JPirman/FPGA_polarimeter/doc/Block Design.pdf

AD7983_driver_0

AD7983_driver_v1_0

fpga_clk_i adc_clk_i

reset_n_i

data_o[15:0] data_rd_ready_o

adc_sdo

adc_sclk_o
adc_cnv_o
trigg_i

Encoder

nres
clk A_i B_i

I_i

cnt_o[10:0] dir_o_0 A_o B_o

Input_debouncer_0

Input_debouncer_v1_0

clk
signal_in

signal_out
trigg_falling
trigg_rising

axi_bram_ctrl_0

AXI BRAM Controller

S_AXI
s_axi_aclk | BRAM_PORTA
s_axi_aresetn

axi_bram_ctrl_0_bram

Block Memory Generator

BRAM_PORTA
BRAM_PORTB
addrb[31:0]
clkb
dinb[31:0] doutb[31:0] enb web[3:0]

rsta_busy
rstb_busy

axi_gpio_0

AXI GPIO

S_AXI | GPIO
gpio_io_i[1:0] s_axi_aclk
s_axi_aresetn

axi_iic_0

AXI IIC

S_AXI | IIC
s_axi_aclk s_axi_aresetn | iic2intc_irpt gpo[0:0]

axi_smc

AXI SmartConnect

S00_AXI | M00_AXI M01_AXI M02_AXI M03_AXI M04_AXI

aclk aresetn

axi_uartlite_0

AXI Uartlite

S_AXI | UART
s_axi_aclk s_axi_aresetn | interrupt

clk_wiz_0

Clocking Wizard

resetn
clk_in1

clk_out1
clk_out2
locked

i2c

mdm_1

MicroBlaze Debug Module (MDM)

MBDEBUG_0 Debug_SYS_Rst

microblaze_0

MicroBlaze

INTERRUPT | DLMB
| ILMB M_AXI_DP

DEBUG
Clk Reset

microblaze_0_axi_intc

AXI Interrupt Controller

s_axi
interrupt s_axi_aclk
s_axi_aresetn
intr[1:0]

microblaze_0_local_memory

DLMB
ILMB
LMB_Clk SYS_Rst

microblaze_0_xlconcat

Concat

In0[0:0]
In1[0:0] | dout[1:0]

A_i_0

BTN0

B_i_0
I_i_0

LD2

LD3

LD4
LD5

SW0

adc_cnv_0

adc_sck_0

adc_sdo_0

mot_sby

reset sys_clock

rst_clk_wiz_0_100M

Processor System Reset

slowest_sync_clk ext_reset_in

aux_reset_in mb_debug_sys_rst dcm_locked

mb_reset bus_struct_reset[0:0] peripheral_reset[0:0]

interconnect_aresetn[0:0] peripheral_aresetn[0:0]

sampling_controller_0

sampling_controller_v1_0

fpga_clk_i
reset_n_i | data_ready_o
trigger_i | idle_o
| bram_addr[31:0] bram_clk bram_wrdata[31:0]
bram_rddata[31:0]

bram_en
bram_we[3:0]

adc_data_ready_i adc_data_1[15:0] adc_data_2[15:0] enc_cnt_i[10:0]

usb_uart

util_vector_logic_0

Utility Vector Logic

Op1[0:0] Op2[0:0] | Res[0:0]

xlconcat_0

Concat

In0[0:0]
In1[0:0] | dout[1:0]

xlconstant_0

Constant

dout[15:0]

adc_sck_0 - JA pin 4
adc_cnv_0 - JA pin 1 mot_sby - IO9

Output of the XOR gate on bot quadrature encoder outputs will change state for every encoder step. We'll use this to trigger the ADC

### adc_sdo_0 - JA pin 3 I_i_0 - JC pin 1 A_i_0 - JC pin 2 B_i_0 - JC pin 3

## We can use the debouncer to output a pulse when a button is pressed/released. This is then used

## as a start signal for the sampling controller. This way we can prevent

## the core from continously running when the button is held
