JPirman/FPGA_polarimeter/Encoder_sampling/Vivado/archive_project_summary.txt

***************************************************************************************
*                      PROJECT ARCHIVE SUMMARY REPORT
*
*                      (archive_project_summary.txt)
*
*  PLEASE READ THIS REPORT TO GET THE DETAILED INFORMATION ABOUT THE PROJECT DATA THAT
*  WAS ARCHIVED FOR THE CURRENT PROJECT
*
* The report is divided into following five sections:-
*
* Section (1) - PROJECT INFORMATION
*  This section provides the details of the current project that was archived
*
* Section (2) - INCLUDED/EXCLUDED RUNS
*  This section summarizes the list of design runs for which the results were included
*  or excluded from the archive
*
* Section (3) - ARCHIVED SOURCES
*  This section summarizes the list of files that were added to the archive
*
* Section (3.1) - INCLUDE FILES
*  This section summarizes the list of 'include' files that were added to the archive
*
* Section (3.1.1) - INCLUDE_DIRS SETTINGS
*  This section summarizes the 'verilog include directory' path settings, if any
*
* Section (3.2) - REMOTE SOURCES
*  This section summarizes the list of referenced 'remote' files that were 'imported'
*  into the archived project
*
* Section (3.3) - SOURCES SUMMARY
*  This section summarizes the list of all the files present in the archive
*
* Section (3.4) - REMOTE IP DEFINITIONS
*  This section summarizes the list of all the remote IP's present in the archive
*
* Section (4) - JOURNAL/LOG FILES
*  This section summarizes the list of journal/log files that were added to the archive
*
* Section (5) - CONFIGURATION SETTINGS/FILES
*  This section summarizes the configuration settings/files that were added to the archive
*
***************************************************************************************

Section (1) - PROJECT INFORMATION
---------------------------------
Name      = Encoder_sampler
Directory = /home/jure/Dokumenti/Xilinx/Polarimeter/Encoder_sampler

WARNING: Please verify the compiled library directory path for the following property in the
         current project. The path may point to an invalid location after opening this project.
         This could happen if the project was unarchived in a location where this path is not
         accessible. To resolve this issue, please set this property with the desired path
         before launching simulation:-

Property = compxlib.xsim_compiled_library_dir
Path     = 

Section (2) - Excluded Runs
---------------------------
The run results were excluded for the following runs in the archived project:-

<synth_1>
<Main_microblaze_0_3_synth_1>
<Main_microblaze_0_axi_intc_3_synth_1>
<Main_clk_wiz_0_2_synth_1>
<Main_dlmb_v10_4_synth_1>
<Main_ilmb_v10_4_synth_1>
<Main_ilmb_bram_if_cntlr_4_synth_1>
<Main_lmb_bram_4_synth_1>
<Main_mdm_1_4_synth_1>
<Main_rst_clk_wiz_0_100M_1_synth_1>
<Main_axi_uartlite_0_2_synth_1>
<Main_axi_iic_0_1_synth_1>
<Main_util_vector_logic_0_1_synth_1>
<Main_axi_bram_ctrl_0_bram_0_synth_1>
<Main_sampling_controller_0_0_synth_1>
<Main_AD7983_driver_0_0_synth_1>
<impl_1>
<Main_microblaze_0_3_impl_1>
<Main_microblaze_0_axi_intc_3_impl_1>
<Main_clk_wiz_0_2_impl_1>
<Main_dlmb_v10_4_impl_1>
<Main_ilmb_v10_4_impl_1>
<Main_ilmb_bram_if_cntlr_4_impl_1>
<Main_lmb_bram_4_impl_1>
<Main_mdm_1_4_impl_1>
<Main_rst_clk_wiz_0_100M_1_impl_1>
<Main_axi_uartlite_0_2_impl_1>
<Main_axi_iic_0_1_impl_1>
<Main_util_vector_logic_0_1_impl_1>
<Main_axi_bram_ctrl_0_bram_0_impl_1>
<Main_sampling_controller_0_0_impl_1>
<Main_AD7983_driver_0_0_impl_1>

Section (3) - ARCHIVED SOURCES
------------------------------
The following sub-sections describes the list of sources that were archived for the current project:-

Section (3.1) - INCLUDE FILES
-----------------------------
List of referenced 'RTL Include' files that were 'imported' into the archived project:-

None

Section (3.1.1) - INCLUDE_DIRS SETTINGS
---------------------------------------
List of the "INCLUDE_DIRS" fileset property settings that may or may not be applicable in the archived
project, since most the 'RTL Include' files referenced in the original project were 'imported' into the
archived project.

<sources_1> fileset RTL include directory paths (INCLUDE_DIRS):-
None

<sim_1> fileset RTL include directory paths (INCLUDE_DIRS):-
None

Section (3.2) - REMOTE SOURCES
------------------------------
List of referenced 'remote' design files that were 'imported' into the archived project:-

<Main_AD7983_driver_0_0>
None

<Main_axi_bram_ctrl_0_bram_0>
/tmp/.Xil_jure/Vivado-25980-Jure-Linux/PrjAr/_X_/Encoder_sampler.gen/sources_1/bd/Main/ipshared/25a8/simulation/blk_mem_gen_v8_4.v
/tmp/.Xil_jure/Vivado-25980-Jure-Linux/PrjAr/_X_/Encoder_sampler.gen/sources_1/bd/Main/ipshared/25a8/hdl/blk_mem_gen_v8_4_vhsyn_rfs.vhd

<Main_axi_iic_0_1>
/tmp/.Xil_jure/Vivado-25980-Jure-Linux/PrjAr/_X_/Encoder_sampler.gen/sources_1/bd/Main/ipshared/0513/hdl/lib_pkg_v1_0_rfs.vhd
/tmp/.Xil_jure/Vivado-25980-Jure-Linux/PrjAr/_X_/Encoder_sampler.gen/sources_1/bd/Main/ipshared/ef1e/hdl/lib_cdc_v1_0_rfs.vhd
/tmp/.Xil_jure/Vivado-25980-Jure-Linux/PrjAr/_X_/Encoder_sampler.gen/sources_1/bd/Main/ipshared/66ea/hdl/axi_lite_ipif_v3_0_vh_rfs.vhd
/tmp/.Xil_jure/Vivado-25980-Jure-Linux/PrjAr/_X_/Encoder_sampler.gen/sources_1/bd/Main/ipshared/a040/hdl/interrupt_control_v3_1_vh_rfs.vhd
/tmp/.Xil_jure/Vivado-25980-Jure-Linux/PrjAr/_X_/Encoder_sampler.gen/sources_1/bd/Main/ipshared/eddf/hdl/axi_iic_v2_1_vh_rfs.vhd

<Main_axi_uartlite_0_2>
/tmp/.Xil_jure/Vivado-25980-Jure-Linux/PrjAr/_X_/Encoder_sampler.gen/sources_1/bd/Main/ipshared/66ea/hdl/axi_lite_ipif_v3_0_vh_rfs.vhd
/tmp/.Xil_jure/Vivado-25980-Jure-Linux/PrjAr/_X_/Encoder_sampler.gen/sources_1/bd/Main/ipshared/0513/hdl/lib_pkg_v1_0_rfs.vhd
/tmp/.Xil_jure/Vivado-25980-Jure-Linux/PrjAr/_X_/Encoder_sampler.gen/sources_1/bd/Main/ipshared/51ce/hdl/lib_srl_fifo_v1_0_rfs.vhd
/tmp/.Xil_jure/Vivado-25980-Jure-Linux/PrjAr/_X_/Encoder_sampler.gen/sources_1/bd/Main/ipshared/ef1e/hdl/lib_cdc_v1_0_rfs.vhd
/tmp/.Xil_jure/Vivado-25980-Jure-Linux/PrjAr/_X_/Encoder_sampler.gen/sources_1/bd/Main/ipshared/5d2b/hdl/axi_uartlite_v2_0_vh_rfs.vhd

<Main_clk_wiz_0_2>
/tmp/.Xil_jure/Vivado-25980-Jure-Linux/PrjAr/_X_/Encoder_sampler.gen/sources_1/bd/Main/ipshared/4e49/mmcm_pll_drp_func_7s_mmcm.vh
/tmp/.Xil_jure/Vivado-25980-Jure-Linux/PrjAr/_X_/Encoder_sampler.gen/sources_1/bd/Main/ipshared/4e49/mmcm_pll_drp_func_7s_pll.vh
/tmp/.Xil_jure/Vivado-25980-Jure-Linux/PrjAr/_X_/Encoder_sampler.gen/sources_1/bd/Main/ipshared/4e49/mmcm_pll_drp_func_us_mmcm.vh
/tmp/.Xil_jure/Vivado-25980-Jure-Linux/PrjAr/_X_/Encoder_sampler.gen/sources_1/bd/Main/ipshared/4e49/mmcm_pll_drp_func_us_pll.vh
/tmp/.Xil_jure/Vivado-25980-Jure-Linux/PrjAr/_X_/Encoder_sampler.gen/sources_1/bd/Main/ipshared/4e49/mmcm_pll_drp_func_us_plus_pll.vh
/tmp/.Xil_jure/Vivado-25980-Jure-Linux/PrjAr/_X_/Encoder_sampler.gen/sources_1/bd/Main/ipshared/4e49/mmcm_pll_drp_func_us_plus_mmcm.vh

<Main_dlmb_v10_4>
/tmp/.Xil_jure/Vivado-25980-Jure-Linux/PrjAr/_X_/Encoder_sampler.gen/sources_1/bd/Main/ipshared/cd1d/hdl/lmb_v10_v3_0_vh_rfs.vhd

<Main_ilmb_bram_if_cntlr_4>
/tmp/.Xil_jure/Vivado-25980-Jure-Linux/PrjAr/_X_/Encoder_sampler.gen/sources_1/bd/Main/ipshared/a177/hdl/lmb_bram_if_cntlr_v4_0_vh_rfs.vhd

<Main_ilmb_v10_4>
/tmp/.Xil_jure/Vivado-25980-Jure-Linux/PrjAr/_X_/Encoder_sampler.gen/sources_1/bd/Main/ipshared/cd1d/hdl/lmb_v10_v3_0_vh_rfs.vhd

<Main_lmb_bram_4>
/tmp/.Xil_jure/Vivado-25980-Jure-Linux/PrjAr/_X_/Encoder_sampler.gen/sources_1/bd/Main/ipshared/25a8/simulation/blk_mem_gen_v8_4.v
/tmp/.Xil_jure/Vivado-25980-Jure-Linux/PrjAr/_X_/Encoder_sampler.gen/sources_1/bd/Main/ipshared/25a8/hdl/blk_mem_gen_v8_4_vhsyn_rfs.vhd

<Main_mdm_1_4>
/tmp/.Xil_jure/Vivado-25980-Jure-Linux/PrjAr/_X_/Encoder_sampler.gen/sources_1/bd/Main/ipshared/66ea/hdl/axi_lite_ipif_v3_0_vh_rfs.vhd
/tmp/.Xil_jure/Vivado-25980-Jure-Linux/PrjAr/_X_/Encoder_sampler.gen/sources_1/bd/Main/ipshared/b8f4/hdl/mdm_v3_2_vh_rfs.vhd

<Main_microblaze_0_3>
/tmp/.Xil_jure/Vivado-25980-Jure-Linux/PrjAr/_X_/Encoder_sampler.gen/sources_1/bd/Main/ipshared/057e/hdl/microblaze_v11_0_vh_rfs.vhd

<Main_microblaze_0_axi_intc_3>
/tmp/.Xil_jure/Vivado-25980-Jure-Linux/PrjAr/_X_/Encoder_sampler.gen/sources_1/bd/Main/ipshared/66ea/hdl/axi_lite_ipif_v3_0_vh_rfs.vhd
/tmp/.Xil_jure/Vivado-25980-Jure-Linux/PrjAr/_X_/Encoder_sampler.gen/sources_1/bd/Main/ipshared/802b/hdl/axi_intc_v4_1_vh_rfs.vhd

<Main_rst_clk_wiz_0_100M_1>
/tmp/.Xil_jure/Vivado-25980-Jure-Linux/PrjAr/_X_/Encoder_sampler.gen/sources_1/bd/Main/ipshared/ef1e/hdl/lib_cdc_v1_0_rfs.vhd
/tmp/.Xil_jure/Vivado-25980-Jure-Linux/PrjAr/_X_/Encoder_sampler.gen/sources_1/bd/Main/ipshared/8842/hdl/proc_sys_reset_v5_0_vh_rfs.vhd

<Main_sampling_controller_0_0>
None

<Main_util_vector_logic_0_1>
/tmp/.Xil_jure/Vivado-25980-Jure-Linux/PrjAr/_X_/Encoder_sampler.gen/sources_1/bd/Main/ipshared/3d84/hdl/util_vector_logic_v2_0_vl_rfs.v

<constrs_1>
None

<sim_1>
None

<sources_1>
/tmp/.Xil_jure/Vivado-25980-Jure-Linux/PrjAr/_X_/Encoder_sampler.gen/sources_1/bd/Main/ipshared/057e/hdl/microblaze_v11_0_vh_rfs.vhd
/tmp/.Xil_jure/Vivado-25980-Jure-Linux/PrjAr/_X_/Encoder_sampler.gen/sources_1/bd/Main/ipshared/4e49/mmcm_pll_drp_func_7s_mmcm.vh
/tmp/.Xil_jure/Vivado-25980-Jure-Linux/PrjAr/_X_/Encoder_sampler.gen/sources_1/bd/Main/ipshared/4e49/mmcm_pll_drp_func_7s_pll.vh
/tmp/.Xil_jure/Vivado-25980-Jure-Linux/PrjAr/_X_/Encoder_sampler.gen/sources_1/bd/Main/ipshared/4e49/mmcm_pll_drp_func_us_mmcm.vh
/tmp/.Xil_jure/Vivado-25980-Jure-Linux/PrjAr/_X_/Encoder_sampler.gen/sources_1/bd/Main/ipshared/4e49/mmcm_pll_drp_func_us_pll.vh
/tmp/.Xil_jure/Vivado-25980-Jure-Linux/PrjAr/_X_/Encoder_sampler.gen/sources_1/bd/Main/ipshared/4e49/mmcm_pll_drp_func_us_plus_pll.vh
/tmp/.Xil_jure/Vivado-25980-Jure-Linux/PrjAr/_X_/Encoder_sampler.gen/sources_1/bd/Main/ipshared/4e49/mmcm_pll_drp_func_us_plus_mmcm.vh
/tmp/.Xil_jure/Vivado-25980-Jure-Linux/PrjAr/_X_/Encoder_sampler.gen/sources_1/bd/Main/ipshared/cd1d/hdl/lmb_v10_v3_0_vh_rfs.vhd
/tmp/.Xil_jure/Vivado-25980-Jure-Linux/PrjAr/_X_/Encoder_sampler.gen/sources_1/bd/Main/ipshared/cd1d/hdl/lmb_v10_v3_0_vh_rfs.vhd
/tmp/.Xil_jure/Vivado-25980-Jure-Linux/PrjAr/_X_/Encoder_sampler.gen/sources_1/bd/Main/ipshared/a177/hdl/lmb_bram_if_cntlr_v4_0_vh_rfs.vhd
/tmp/.Xil_jure/Vivado-25980-Jure-Linux/PrjAr/_X_/Encoder_sampler.gen/sources_1/bd/Main/ipshared/a177/hdl/lmb_bram_if_cntlr_v4_0_vh_rfs.vhd
/tmp/.Xil_jure/Vivado-25980-Jure-Linux/PrjAr/_X_/Encoder_sampler.gen/sources_1/bd/Main/ipshared/25a8/simulation/blk_mem_gen_v8_4.v
/tmp/.Xil_jure/Vivado-25980-Jure-Linux/PrjAr/_X_/Encoder_sampler.gen/sources_1/bd/Main/ipshared/25a8/hdl/blk_mem_gen_v8_4_vhsyn_rfs.vhd
/tmp/.Xil_jure/Vivado-25980-Jure-Linux/PrjAr/_X_/Encoder_sampler.gen/sources_1/bd/Main/ipshared/66ea/hdl/axi_lite_ipif_v3_0_vh_rfs.vhd
/tmp/.Xil_jure/Vivado-25980-Jure-Linux/PrjAr/_X_/Encoder_sampler.gen/sources_1/bd/Main/ipshared/802b/hdl/axi_intc_v4_1_vh_rfs.vhd
/tmp/.Xil_jure/Vivado-25980-Jure-Linux/PrjAr/_X_/Encoder_sampler.gen/sources_1/bd/Main/ipshared/4b67/hdl/xlconcat_v2_1_vl_rfs.v
/tmp/.Xil_jure/Vivado-25980-Jure-Linux/PrjAr/_X_/Encoder_sampler.gen/sources_1/bd/Main/ipshared/66ea/hdl/axi_lite_ipif_v3_0_vh_rfs.vhd
/tmp/.Xil_jure/Vivado-25980-Jure-Linux/PrjAr/_X_/Encoder_sampler.gen/sources_1/bd/Main/ipshared/b8f4/hdl/mdm_v3_2_vh_rfs.vhd
/tmp/.Xil_jure/Vivado-25980-Jure-Linux/PrjAr/_X_/Encoder_sampler.gen/sources_1/bd/Main/ipshared/ef1e/hdl/lib_cdc_v1_0_rfs.vhd
/tmp/.Xil_jure/Vivado-25980-Jure-Linux/PrjAr/_X_/Encoder_sampler.gen/sources_1/bd/Main/ipshared/8842/hdl/proc_sys_reset_v5_0_vh_rfs.vhd
/tmp/.Xil_jure/Vivado-25980-Jure-Linux/PrjAr/_X_/Encoder_sampler.gen/sources_1/bd/Main/ipshared/66ea/hdl/axi_lite_ipif_v3_0_vh_rfs.vhd
/tmp/.Xil_jure/Vivado-25980-Jure-Linux/PrjAr/_X_/Encoder_sampler.gen/sources_1/bd/Main/ipshared/0513/hdl/lib_pkg_v1_0_rfs.vhd
/tmp/.Xil_jure/Vivado-25980-Jure-Linux/PrjAr/_X_/Encoder_sampler.gen/sources_1/bd/Main/ipshared/51ce/hdl/lib_srl_fifo_v1_0_rfs.vhd
/tmp/.Xil_jure/Vivado-25980-Jure-Linux/PrjAr/_X_/Encoder_sampler.gen/sources_1/bd/Main/ipshared/ef1e/hdl/lib_cdc_v1_0_rfs.vhd
/tmp/.Xil_jure/Vivado-25980-Jure-Linux/PrjAr/_X_/Encoder_sampler.gen/sources_1/bd/Main/ipshared/5d2b/hdl/axi_uartlite_v2_0_vh_rfs.vhd
/tmp/.Xil_jure/Vivado-25980-Jure-Linux/PrjAr/_X_/Encoder_sampler.gen/sources_1/bd/Main/ipshared/0513/hdl/lib_pkg_v1_0_rfs.vhd
/tmp/.Xil_jure/Vivado-25980-Jure-Linux/PrjAr/_X_/Encoder_sampler.gen/sources_1/bd/Main/ipshared/ef1e/hdl/lib_cdc_v1_0_rfs.vhd
/tmp/.Xil_jure/Vivado-25980-Jure-Linux/PrjAr/_X_/Encoder_sampler.gen/sources_1/bd/Main/ipshared/66ea/hdl/axi_lite_ipif_v3_0_vh_rfs.vhd
/tmp/.Xil_jure/Vivado-25980-Jure-Linux/PrjAr/_X_/Encoder_sampler.gen/sources_1/bd/Main/ipshared/a040/hdl/interrupt_control_v3_1_vh_rfs.vhd
/tmp/.Xil_jure/Vivado-25980-Jure-Linux/PrjAr/_X_/Encoder_sampler.gen/sources_1/bd/Main/ipshared/eddf/hdl/axi_iic_v2_1_vh_rfs.vhd
/tmp/.Xil_jure/Vivado-25980-Jure-Linux/PrjAr/_X_/Encoder_sampler.gen/sources_1/bd/Main/ipshared/3d84/hdl/util_vector_logic_v2_0_vl_rfs.v
/tmp/.Xil_jure/Vivado-25980-Jure-Linux/PrjAr/_X_/Encoder_sampler.gen/sources_1/bd/Main/ipshared/66ea/hdl/axi_lite_ipif_v3_0_vh_rfs.vhd
/tmp/.Xil_jure/Vivado-25980-Jure-Linux/PrjAr/_X_/Encoder_sampler.gen/sources_1/bd/Main/ipshared/ef1e/hdl/lib_cdc_v1_0_rfs.vhd
/tmp/.Xil_jure/Vivado-25980-Jure-Linux/PrjAr/_X_/Encoder_sampler.gen/sources_1/bd/Main/ipshared/a040/hdl/interrupt_control_v3_1_vh_rfs.vhd
/tmp/.Xil_jure/Vivado-25980-Jure-Linux/PrjAr/_X_/Encoder_sampler.gen/sources_1/bd/Main/ipshared/3ed9/hdl/axi_gpio_v2_0_vh_rfs.vhd
/tmp/.Xil_jure/Vivado-25980-Jure-Linux/PrjAr/_X_/Encoder_sampler.gen/sources_1/bd/Main/ipshared/4b67/hdl/xlconcat_v2_1_vl_rfs.v
/tmp/.Xil_jure/Vivado-25980-Jure-Linux/PrjAr/_X_/Encoder_sampler.gen/sources_1/bd/Main/ipshared/fcfc/hdl/xlconstant_v1_1_vl_rfs.v
/tmp/.Xil_jure/Vivado-25980-Jure-Linux/PrjAr/_X_/Encoder_sampler.gen/sources_1/bd/Main/ipshared/3c31/hdl/axi_bram_ctrl_v4_1_rfs.vhd
/tmp/.Xil_jure/Vivado-25980-Jure-Linux/PrjAr/_X_/Encoder_sampler.gen/sources_1/bd/Main/ipshared/25a8/simulation/blk_mem_gen_v8_4.v
/tmp/.Xil_jure/Vivado-25980-Jure-Linux/PrjAr/_X_/Encoder_sampler.gen/sources_1/bd/Main/ipshared/25a8/hdl/blk_mem_gen_v8_4_vhsyn_rfs.vhd
/tmp/.Xil_jure/Vivado-25980-Jure-Linux/PrjAr/_X_/Encoder_sampler.gen/sources_1/bd/Main/ipshared/fcfc/hdl/xlconstant_v1_1_vl_rfs.v
/tmp/.Xil_jure/Vivado-25980-Jure-Linux/PrjAr/_X_/Encoder_sampler.gen/sources_1/bd/Main/ipshared/ef1e/hdl/lib_cdc_v1_0_rfs.vhd
/tmp/.Xil_jure/Vivado-25980-Jure-Linux/PrjAr/_X_/Encoder_sampler.gen/sources_1/bd/Main/ipshared/8842/hdl/proc_sys_reset_v5_0_vh_rfs.vhd
/tmp/.Xil_jure/Vivado-25980-Jure-Linux/PrjAr/_X_/Encoder_sampler.gen/sources_1/bd/Main/ipshared/f0b6/hdl/verilog/sc_util_v1_0_4_constants.vh
/tmp/.Xil_jure/Vivado-25980-Jure-Linux/PrjAr/_X_/Encoder_sampler.gen/sources_1/bd/Main/ipshared/f0b6/hdl/verilog/sc_util_v1_0_4_constants_noc.vh
/tmp/.Xil_jure/Vivado-25980-Jure-Linux/PrjAr/_X_/Encoder_sampler.gen/sources_1/bd/Main/ipshared/f0b6/hdl/verilog/sc_util_v1_0_4_structs.svh
/tmp/.Xil_jure/Vivado-25980-Jure-Linux/PrjAr/_X_/Encoder_sampler.gen/sources_1/bd/Main/ipshared/f0b6/hdl/sc_util_v1_0_vl_rfs.sv
/tmp/.Xil_jure/Vivado-25980-Jure-Linux/PrjAr/_X_/Encoder_sampler.gen/sources_1/bd/Main/ipshared/c012/hdl/sc_switchboard_v1_0_vl_rfs.sv
/tmp/.Xil_jure/Vivado-25980-Jure-Linux/PrjAr/_X_/Encoder_sampler.gen/sources_1/bd/Main/ipshared/f0b6/hdl/verilog/sc_util_v1_0_4_constants.vh
/tmp/.Xil_jure/Vivado-25980-Jure-Linux/PrjAr/_X_/Encoder_sampler.gen/sources_1/bd/Main/ipshared/f0b6/hdl/verilog/sc_util_v1_0_4_constants_noc.vh
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
/tmp/.Xil_jure/Vivado-25980-Jure-Linux/PrjAr/_X_/Encoder_sampler.gen/sources_1/bd/Main/ipshared/f0b6/hdl/verilog/sc_util_v1_0_4_constants_noc.vh
/tmp/.Xil_jure/Vivado-25980-Jure-Linux/PrjAr/_X_/Encoder_sampler.gen/sources_1/bd/Main/ipshared/f0b6/hdl/verilog/sc_util_v1_0_4_structs.svh
/tmp/.Xil_jure/Vivado-25980-Jure-Linux/PrjAr/_X_/Encoder_sampler.gen/sources_1/bd/Main/ipshared/f0b6/hdl/sc_util_v1_0_vl_rfs.sv
/tmp/.Xil_jure/Vivado-25980-Jure-Linux/PrjAr/_X_/Encoder_sampler.gen/sources_1/bd/Main/ipshared/ea34/hdl/sc_mmu_v1_0_vl_rfs.sv
/tmp/.Xil_jure/Vivado-25980-Jure-Linux/PrjAr/_X_/Encoder_sampler.gen/sources_1/bd/Main/ipshared/4fd2/hdl/sc_transaction_regulator_v1_0_vl_rfs.sv
/tmp/.Xil_jure/Vivado-25980-Jure-Linux/PrjAr/_X_/Encoder_sampler.gen/sources_1/bd/Main/ipshared/8047/hdl/sc_si_converter_v1_0_vl_rfs.sv
/tmp/.Xil_jure/Vivado-25980-Jure-Linux/PrjAr/_X_/Encoder_sampler.gen/sources_1/bd/Main/ipshared/66be/hdl/verilog/sc_node_v1_0_14_t_reqsend.svh
/tmp/.Xil_jure/Vivado-25980-Jure-Linux/PrjAr/_X_/Encoder_sampler.gen/sources_1/bd/Main/ipshared/66be/hdl/sc_node_v1_0_vl_rfs.sv
/tmp/.Xil_jure/Vivado-25980-Jure-Linux/PrjAr/_X_/Encoder_sampler.gen/sources_1/bd/Main/ipshared/c012/hdl/sc_switchboard_v1_0_vl_rfs.sv
/tmp/.Xil_jure/Vivado-25980-Jure-Linux/PrjAr/_X_/Encoder_sampler.gen/sources_1/bd/Main/ipshared/f38e/hdl/sc_axi2sc_v1_0_vl_rfs.sv
/tmp/.Xil_jure/Vivado-25980-Jure-Linux/PrjAr/_X_/Encoder_sampler.gen/sources_1/bd/Main/ipshared/9cc5/hdl/sc_sc2axi_v1_0_vl_rfs.sv
/tmp/.Xil_jure/Vivado-25980-Jure-Linux/PrjAr/_X_/Encoder_sampler.gen/sources_1/bd/Main/ipshared/6bba/hdl/sc_exit_v1_0_vl_rfs.sv
/tmp/.Xil_jure/Vivado-25980-Jure-Linux/PrjAr/_X_/Encoder_sampler.gen/sources_1/bd/Main/ipshared/ec67/hdl/axi_infrastructure_v1_1_0.vh
/tmp/.Xil_jure/Vivado-25980-Jure-Linux/PrjAr/_X_/Encoder_sampler.gen/sources_1/bd/Main/ipshared/ec67/hdl/axi_infrastructure_v1_1_vl_rfs.v
/tmp/.Xil_jure/Vivado-25980-Jure-Linux/PrjAr/_X_/Encoder_sampler.gen/sources_1/bd/Main/ipshared/0a3f/hdl/axi_register_slice_v2_1_vl_rfs.v
/tmp/.Xil_jure/Vivado-25980-Jure-Linux/PrjAr/_X_/Encoder_sampler.gen/sources_1/bd/Main/ipshared/1033/hdl/axi_vip_v1_1_vl_rfs.sv
/tmp/.Xil_jure/Vivado-25980-Jure-Linux/PrjAr/_X_/Encoder_sampler.gen/sources_1/bd/Main/ipshared/ef1e/hdl/lib_cdc_v1_0_rfs.vhd
/tmp/.Xil_jure/Vivado-25980-Jure-Linux/PrjAr/_X_/Encoder_sampler.gen/sources_1/bd/Main/ipshared/8842/hdl/proc_sys_reset_v5_0_vh_rfs.vhd
/tmp/.Xil_jure/Vivado-25980-Jure-Linux/PrjAr/_X_/Encoder_sampler.gen/sources_1/bd/Main/ipshared/fcfc/hdl/xlconstant_v1_1_vl_rfs.v

<utils_1>
None

Section (3.3) - SOURCES SUMMARY
-------------------------------
List of all the source files present in the archived project:-

<sources_1>
./Encoder_sampler.srcs/sources_1/new/Input_debouncer.v
./Encoder_sampler.srcs/sources_1/new/Encoder_decoder.v
./Encoder_sampler.srcs/sources_1/new/AD7983_driver.v
./Encoder_sampler.srcs/sources_1/new/sampling_controller.v
./Encoder_sampler.srcs/sources_1/bd/Main/Main.bd
./Encoder_sampler.srcs/sources_1/bd/Main/ip/Main_microblaze_0_3/Main_microblaze_0_3.xci
./Encoder_sampler.gen/sources_1/bd/Main/ip/Main_microblaze_0_3/data/mb_bootloop_le.elf
./Encoder_sampler.gen/sources_1/bd/Main/ip/Main_microblaze_0_3/Main_microblaze_0_3.xdc
./Encoder_sampler.gen/sources_1/bd/Main/ip/Main_microblaze_0_3/Main_microblaze_0_3_ooc_debug.xdc
./Encoder_sampler.gen/sources_1/bd/Main/ipshared/057e/hdl/microblaze_v11_0_vh_rfs.vhd
./Encoder_sampler.gen/sources_1/bd/Main/ip/Main_microblaze_0_3/sim/Main_microblaze_0_3.vhd
./Encoder_sampler.gen/sources_1/bd/Main/ip/Main_microblaze_0_3/Main_microblaze_0_3.dcp
./Encoder_sampler.gen/sources_1/bd/Main/ip/Main_microblaze_0_3/Main_microblaze_0_3_stub.v
./Encoder_sampler.gen/sources_1/bd/Main/ip/Main_microblaze_0_3/Main_microblaze_0_3_stub.vhdl
./Encoder_sampler.gen/sources_1/bd/Main/ip/Main_microblaze_0_3/Main_microblaze_0_3_sim_netlist.v
./Encoder_sampler.gen/sources_1/bd/Main/ip/Main_microblaze_0_3/Main_microblaze_0_3_sim_netlist.vhdl
./Encoder_sampler.gen/sources_1/bd/Main/ip/Main_microblaze_0_3/synth/Main_microblaze_0_3.vhd
./Encoder_sampler.gen/sources_1/bd/Main/ip/Main_microblaze_0_3/Main_microblaze_0_3_ooc.xdc
./Encoder_sampler.gen/sources_1/bd/Main/ip/Main_microblaze_0_3/Main_microblaze_0_3.xml
./Encoder_sampler.srcs/sources_1/bd/Main/ip/Main_clk_wiz_0_2/Main_clk_wiz_0_2.xci
./Encoder_sampler.gen/sources_1/bd/Main/ip/Main_clk_wiz_0_2/Main_clk_wiz_0_2_board.xdc
./Encoder_sampler.gen/sources_1/bd/Main/ip/Main_clk_wiz_0_2/Main_clk_wiz_0_2.xdc
./Encoder_sampler.gen/sources_1/bd/Main/ip/Main_clk_wiz_0_2/Main_clk_wiz_0_2_ooc.xdc
./Encoder_sampler.gen/sources_1/bd/Main/ipshared/4e49/mmcm_pll_drp_func_7s_mmcm.vh
./Encoder_sampler.gen/sources_1/bd/Main/ipshared/4e49/mmcm_pll_drp_func_7s_pll.vh
./Encoder_sampler.gen/sources_1/bd/Main/ipshared/4e49/mmcm_pll_drp_func_us_mmcm.vh
./Encoder_sampler.gen/sources_1/bd/Main/ipshared/4e49/mmcm_pll_drp_func_us_pll.vh
./Encoder_sampler.gen/sources_1/bd/Main/ipshared/4e49/mmcm_pll_drp_func_us_plus_pll.vh
./Encoder_sampler.gen/sources_1/bd/Main/ipshared/4e49/mmcm_pll_drp_func_us_plus_mmcm.vh
./Encoder_sampler.gen/sources_1/bd/Main/ip/Main_clk_wiz_0_2/Main_clk_wiz_0_2_clk_wiz.v
./Encoder_sampler.gen/sources_1/bd/Main/ip/Main_clk_wiz_0_2/Main_clk_wiz_0_2.v
./Encoder_sampler.gen/sources_1/bd/Main/ip/Main_clk_wiz_0_2/Main_clk_wiz_0_2.dcp
./Encoder_sampler.gen/sources_1/bd/Main/ip/Main_clk_wiz_0_2/Main_clk_wiz_0_2_stub.v
./Encoder_sampler.gen/sources_1/bd/Main/ip/Main_clk_wiz_0_2/Main_clk_wiz_0_2_stub.vhdl
./Encoder_sampler.gen/sources_1/bd/Main/ip/Main_clk_wiz_0_2/Main_clk_wiz_0_2_sim_netlist.v
./Encoder_sampler.gen/sources_1/bd/Main/ip/Main_clk_wiz_0_2/Main_clk_wiz_0_2_sim_netlist.vhdl
./Encoder_sampler.gen/sources_1/bd/Main/ip/Main_clk_wiz_0_2/Main_clk_wiz_0_2.xml
./Encoder_sampler.srcs/sources_1/bd/Main/ip/Main_dlmb_v10_4/Main_dlmb_v10_4.xci
./Encoder_sampler.gen/sources_1/bd/Main/ipshared/cd1d/hdl/lmb_v10_v3_0_vh_rfs.vhd
./Encoder_sampler.gen/sources_1/bd/Main/ip/Main_dlmb_v10_4/sim/Main_dlmb_v10_4.vhd
./Encoder_sampler.gen/sources_1/bd/Main/ip/Main_dlmb_v10_4/Main_dlmb_v10_4.dcp
./Encoder_sampler.gen/sources_1/bd/Main/ip/Main_dlmb_v10_4/Main_dlmb_v10_4_stub.v
./Encoder_sampler.gen/sources_1/bd/Main/ip/Main_dlmb_v10_4/Main_dlmb_v10_4_stub.vhdl
./Encoder_sampler.gen/sources_1/bd/Main/ip/Main_dlmb_v10_4/Main_dlmb_v10_4_sim_netlist.v
./Encoder_sampler.gen/sources_1/bd/Main/ip/Main_dlmb_v10_4/Main_dlmb_v10_4_sim_netlist.vhdl
./Encoder_sampler.gen/sources_1/bd/Main/ip/Main_dlmb_v10_4/synth/Main_dlmb_v10_4.vhd
./Encoder_sampler.gen/sources_1/bd/Main/ip/Main_dlmb_v10_4/Main_dlmb_v10_4_ooc.xdc
./Encoder_sampler.gen/sources_1/bd/Main/ip/Main_dlmb_v10_4/Main_dlmb_v10_4.xml
./Encoder_sampler.srcs/sources_1/bd/Main/ip/Main_ilmb_v10_4/Main_ilmb_v10_4.xci
./Encoder_sampler.gen/sources_1/bd/Main/ipshared/cd1d/hdl/lmb_v10_v3_0_vh_rfs.vhd
./Encoder_sampler.gen/sources_1/bd/Main/ip/Main_ilmb_v10_4/sim/Main_ilmb_v10_4.vhd
./Encoder_sampler.gen/sources_1/bd/Main/ip/Main_ilmb_v10_4/Main_ilmb_v10_4.dcp
./Encoder_sampler.gen/sources_1/bd/Main/ip/Main_ilmb_v10_4/Main_ilmb_v10_4_stub.v
./Encoder_sampler.gen/sources_1/bd/Main/ip/Main_ilmb_v10_4/Main_ilmb_v10_4_stub.vhdl
./Encoder_sampler.gen/sources_1/bd/Main/ip/Main_ilmb_v10_4/Main_ilmb_v10_4_sim_netlist.v
./Encoder_sampler.gen/sources_1/bd/Main/ip/Main_ilmb_v10_4/Main_ilmb_v10_4_sim_netlist.vhdl
./Encoder_sampler.gen/sources_1/bd/Main/ip/Main_ilmb_v10_4/synth/Main_ilmb_v10_4.vhd
./Encoder_sampler.gen/sources_1/bd/Main/ip/Main_ilmb_v10_4/Main_ilmb_v10_4_ooc.xdc
./Encoder_sampler.gen/sources_1/bd/Main/ip/Main_ilmb_v10_4/Main_ilmb_v10_4.xml
./Encoder_sampler.srcs/sources_1/bd/Main/ip/Main_dlmb_bram_if_cntlr_4/Main_dlmb_bram_if_cntlr_4.xci
./Encoder_sampler.gen/sources_1/bd/Main/ipshared/a177/hdl/lmb_bram_if_cntlr_v4_0_vh_rfs.vhd
./Encoder_sampler.gen/sources_1/bd/Main/ip/Main_dlmb_bram_if_cntlr_4/sim/Main_dlmb_bram_if_cntlr_4.vhd
./Encoder_sampler.gen/sources_1/bd/Main/ip/Main_dlmb_bram_if_cntlr_4/Main_dlmb_bram_if_cntlr_4_stub.v
./Encoder_sampler.gen/sources_1/bd/Main/ip/Main_dlmb_bram_if_cntlr_4/Main_dlmb_bram_if_cntlr_4_sim_netlist.v
./Encoder_sampler.gen/sources_1/bd/Main/ip/Main_dlmb_bram_if_cntlr_4/Main_dlmb_bram_if_cntlr_4.dcp
./Encoder_sampler.gen/sources_1/bd/Main/ip/Main_dlmb_bram_if_cntlr_4/Main_dlmb_bram_if_cntlr_4_sim_netlist.vhdl
./Encoder_sampler.gen/sources_1/bd/Main/ip/Main_dlmb_bram_if_cntlr_4/Main_dlmb_bram_if_cntlr_4_stub.vhdl
./Encoder_sampler.gen/sources_1/bd/Main/ip/Main_dlmb_bram_if_cntlr_4/synth/Main_dlmb_bram_if_cntlr_4.vhd
./Encoder_sampler.gen/sources_1/bd/Main/ip/Main_dlmb_bram_if_cntlr_4/Main_dlmb_bram_if_cntlr_4_ooc.xdc
./Encoder_sampler.gen/sources_1/bd/Main/ip/Main_dlmb_bram_if_cntlr_4/Main_dlmb_bram_if_cntlr_4.xml
./Encoder_sampler.srcs/sources_1/bd/Main/ip/Main_ilmb_bram_if_cntlr_4/Main_ilmb_bram_if_cntlr_4.xci
./Encoder_sampler.gen/sources_1/bd/Main/ipshared/a177/hdl/lmb_bram_if_cntlr_v4_0_vh_rfs.vhd
./Encoder_sampler.gen/sources_1/bd/Main/ip/Main_ilmb_bram_if_cntlr_4/sim/Main_ilmb_bram_if_cntlr_4.vhd
./Encoder_sampler.gen/sources_1/bd/Main/ip/Main_ilmb_bram_if_cntlr_4/Main_ilmb_bram_if_cntlr_4.dcp
./Encoder_sampler.gen/sources_1/bd/Main/ip/Main_ilmb_bram_if_cntlr_4/Main_ilmb_bram_if_cntlr_4_stub.v
./Encoder_sampler.gen/sources_1/bd/Main/ip/Main_ilmb_bram_if_cntlr_4/Main_ilmb_bram_if_cntlr_4_stub.vhdl
./Encoder_sampler.gen/sources_1/bd/Main/ip/Main_ilmb_bram_if_cntlr_4/Main_ilmb_bram_if_cntlr_4_sim_netlist.v
./Encoder_sampler.gen/sources_1/bd/Main/ip/Main_ilmb_bram_if_cntlr_4/Main_ilmb_bram_if_cntlr_4_sim_netlist.vhdl
./Encoder_sampler.gen/sources_1/bd/Main/ip/Main_ilmb_bram_if_cntlr_4/synth/Main_ilmb_bram_if_cntlr_4.vhd
./Encoder_sampler.gen/sources_1/bd/Main/ip/Main_ilmb_bram_if_cntlr_4/Main_ilmb_bram_if_cntlr_4_ooc.xdc
./Encoder_sampler.gen/sources_1/bd/Main/ip/Main_ilmb_bram_if_cntlr_4/Main_ilmb_bram_if_cntlr_4.xml
./Encoder_sampler.srcs/sources_1/bd/Main/ip/Main_lmb_bram_4/Main_lmb_bram_4.xci
./Encoder_sampler.gen/sources_1/bd/Main/ipshared/25a8/simulation/blk_mem_gen_v8_4.v
./Encoder_sampler.gen/sources_1/bd/Main/ip/Main_lmb_bram_4/sim/Main_lmb_bram_4.v
./Encoder_sampler.gen/sources_1/bd/Main/ip/Main_lmb_bram_4/Main_lmb_bram_4.dcp
./Encoder_sampler.gen/sources_1/bd/Main/ip/Main_lmb_bram_4/Main_lmb_bram_4_stub.v
./Encoder_sampler.gen/sources_1/bd/Main/ip/Main_lmb_bram_4/Main_lmb_bram_4_stub.vhdl
./Encoder_sampler.gen/sources_1/bd/Main/ip/Main_lmb_bram_4/Main_lmb_bram_4_sim_netlist.v
./Encoder_sampler.gen/sources_1/bd/Main/ip/Main_lmb_bram_4/Main_lmb_bram_4_sim_netlist.vhdl
./Encoder_sampler.gen/sources_1/bd/Main/ip/Main_lmb_bram_4/Main_lmb_bram_4_ooc.xdc
./Encoder_sampler.gen/sources_1/bd/Main/ipshared/25a8/hdl/blk_mem_gen_v8_4_vhsyn_rfs.vhd
./Encoder_sampler.gen/sources_1/bd/Main/ip/Main_lmb_bram_4/synth/Main_lmb_bram_4.vhd
./Encoder_sampler.gen/sources_1/bd/Main/ip/Main_lmb_bram_4/Main_lmb_bram_4.xml
./Encoder_sampler.srcs/sources_1/bd/Main/ip/Main_microblaze_0_axi_intc_3/Main_microblaze_0_axi_intc_3.xci
./Encoder_sampler.gen/sources_1/bd/Main/ipshared/66ea/hdl/axi_lite_ipif_v3_0_vh_rfs.vhd
./Encoder_sampler.gen/sources_1/bd/Main/ip/Main_microblaze_0_axi_intc_3/Main_microblaze_0_axi_intc_3.xdc
./Encoder_sampler.gen/sources_1/bd/Main/ip/Main_microblaze_0_axi_intc_3/Main_microblaze_0_axi_intc_3_clocks.xdc
./Encoder_sampler.gen/sources_1/bd/Main/ip/Main_microblaze_0_axi_intc_3/Main_microblaze_0_axi_intc_3_ooc.xdc
./Encoder_sampler.gen/sources_1/bd/Main/ipshared/802b/hdl/axi_intc_v4_1_vh_rfs.vhd
./Encoder_sampler.gen/sources_1/bd/Main/ip/Main_microblaze_0_axi_intc_3/sim/Main_microblaze_0_axi_intc_3.vhd
./Encoder_sampler.gen/sources_1/bd/Main/ip/Main_microblaze_0_axi_intc_3/Main_microblaze_0_axi_intc_3.dcp
./Encoder_sampler.gen/sources_1/bd/Main/ip/Main_microblaze_0_axi_intc_3/Main_microblaze_0_axi_intc_3_stub.v
./Encoder_sampler.gen/sources_1/bd/Main/ip/Main_microblaze_0_axi_intc_3/Main_microblaze_0_axi_intc_3_stub.vhdl
./Encoder_sampler.gen/sources_1/bd/Main/ip/Main_microblaze_0_axi_intc_3/Main_microblaze_0_axi_intc_3_sim_netlist.v
./Encoder_sampler.gen/sources_1/bd/Main/ip/Main_microblaze_0_axi_intc_3/Main_microblaze_0_axi_intc_3_sim_netlist.vhdl
./Encoder_sampler.gen/sources_1/bd/Main/ip/Main_microblaze_0_axi_intc_3/synth/Main_microblaze_0_axi_intc_3.vhd
./Encoder_sampler.gen/sources_1/bd/Main/ip/Main_microblaze_0_axi_intc_3/Main_microblaze_0_axi_intc_3.xml
./Encoder_sampler.srcs/sources_1/bd/Main/ip/Main_microblaze_0_xlconcat_3/Main_microblaze_0_xlconcat_3.xci
./Encoder_sampler.gen/sources_1/bd/Main/ipshared/4b67/hdl/xlconcat_v2_1_vl_rfs.v
./Encoder_sampler.gen/sources_1/bd/Main/ip/Main_microblaze_0_xlconcat_3/sim/Main_microblaze_0_xlconcat_3.v
./Encoder_sampler.gen/sources_1/bd/Main/ip/Main_microblaze_0_xlconcat_3/synth/Main_microblaze_0_xlconcat_3.v
./Encoder_sampler.gen/sources_1/bd/Main/ip/Main_microblaze_0_xlconcat_3/Main_microblaze_0_xlconcat_3.xml
./Encoder_sampler.srcs/sources_1/bd/Main/ip/Main_mdm_1_4/Main_mdm_1_4.xci
./Encoder_sampler.gen/sources_1/bd/Main/ipshared/66ea/hdl/axi_lite_ipif_v3_0_vh_rfs.vhd
./Encoder_sampler.gen/sources_1/bd/Main/ip/Main_mdm_1_4/Main_mdm_1_4.xdc
./Encoder_sampler.gen/sources_1/bd/Main/ip/Main_mdm_1_4/Main_mdm_1_4_ooc_trace.xdc
./Encoder_sampler.gen/sources_1/bd/Main/ipshared/b8f4/hdl/mdm_v3_2_vh_rfs.vhd
./Encoder_sampler.gen/sources_1/bd/Main/ip/Main_mdm_1_4/sim/Main_mdm_1_4.vhd
./Encoder_sampler.gen/sources_1/bd/Main/ip/Main_mdm_1_4/Main_mdm_1_4.dcp
./Encoder_sampler.gen/sources_1/bd/Main/ip/Main_mdm_1_4/Main_mdm_1_4_stub.v
./Encoder_sampler.gen/sources_1/bd/Main/ip/Main_mdm_1_4/Main_mdm_1_4_stub.vhdl
./Encoder_sampler.gen/sources_1/bd/Main/ip/Main_mdm_1_4/Main_mdm_1_4_sim_netlist.v
./Encoder_sampler.gen/sources_1/bd/Main/ip/Main_mdm_1_4/Main_mdm_1_4_sim_netlist.vhdl
./Encoder_sampler.gen/sources_1/bd/Main/ip/Main_mdm_1_4/synth/Main_mdm_1_4.vhd
./Encoder_sampler.gen/sources_1/bd/Main/ip/Main_mdm_1_4/Main_mdm_1_4.xml
./Encoder_sampler.srcs/sources_1/bd/Main/ip/Main_rst_clk_wiz_0_100M_1/Main_rst_clk_wiz_0_100M_1.xci
./Encoder_sampler.gen/sources_1/bd/Main/ip/Main_rst_clk_wiz_0_100M_1/Main_rst_clk_wiz_0_100M_1_board.xdc
./Encoder_sampler.gen/sources_1/bd/Main/ipshared/ef1e/hdl/lib_cdc_v1_0_rfs.vhd
./Encoder_sampler.gen/sources_1/bd/Main/ipshared/8842/hdl/proc_sys_reset_v5_0_vh_rfs.vhd
./Encoder_sampler.gen/sources_1/bd/Main/ip/Main_rst_clk_wiz_0_100M_1/sim/Main_rst_clk_wiz_0_100M_1.vhd
./Encoder_sampler.gen/sources_1/bd/Main/ip/Main_rst_clk_wiz_0_100M_1/Main_rst_clk_wiz_0_100M_1.dcp
./Encoder_sampler.gen/sources_1/bd/Main/ip/Main_rst_clk_wiz_0_100M_1/Main_rst_clk_wiz_0_100M_1_stub.v
./Encoder_sampler.gen/sources_1/bd/Main/ip/Main_rst_clk_wiz_0_100M_1/Main_rst_clk_wiz_0_100M_1_stub.vhdl
./Encoder_sampler.gen/sources_1/bd/Main/ip/Main_rst_clk_wiz_0_100M_1/Main_rst_clk_wiz_0_100M_1_sim_netlist.v
./Encoder_sampler.gen/sources_1/bd/Main/ip/Main_rst_clk_wiz_0_100M_1/Main_rst_clk_wiz_0_100M_1_sim_netlist.vhdl
./Encoder_sampler.gen/sources_1/bd/Main/ip/Main_rst_clk_wiz_0_100M_1/Main_rst_clk_wiz_0_100M_1.xdc
./Encoder_sampler.gen/sources_1/bd/Main/ip/Main_rst_clk_wiz_0_100M_1/synth/Main_rst_clk_wiz_0_100M_1.vhd
./Encoder_sampler.gen/sources_1/bd/Main/ip/Main_rst_clk_wiz_0_100M_1/Main_rst_clk_wiz_0_100M_1_ooc.xdc
./Encoder_sampler.gen/sources_1/bd/Main/ip/Main_rst_clk_wiz_0_100M_1/Main_rst_clk_wiz_0_100M_1.xml
./Encoder_sampler.srcs/sources_1/bd/Main/ip/Main_axi_uartlite_0_2/Main_axi_uartlite_0_2.xci
./Encoder_sampler.gen/sources_1/bd/Main/ip/Main_axi_uartlite_0_2/Main_axi_uartlite_0_2_board.xdc
./Encoder_sampler.gen/sources_1/bd/Main/ipshared/66ea/hdl/axi_lite_ipif_v3_0_vh_rfs.vhd
./Encoder_sampler.gen/sources_1/bd/Main/ipshared/0513/hdl/lib_pkg_v1_0_rfs.vhd
./Encoder_sampler.gen/sources_1/bd/Main/ipshared/51ce/hdl/lib_srl_fifo_v1_0_rfs.vhd
./Encoder_sampler.gen/sources_1/bd/Main/ipshared/ef1e/hdl/lib_cdc_v1_0_rfs.vhd
./Encoder_sampler.gen/sources_1/bd/Main/ip/Main_axi_uartlite_0_2/Main_axi_uartlite_0_2_ooc.xdc
./Encoder_sampler.gen/sources_1/bd/Main/ip/Main_axi_uartlite_0_2/Main_axi_uartlite_0_2.xdc
./Encoder_sampler.gen/sources_1/bd/Main/ipshared/5d2b/hdl/axi_uartlite_v2_0_vh_rfs.vhd
./Encoder_sampler.gen/sources_1/bd/Main/ip/Main_axi_uartlite_0_2/sim/Main_axi_uartlite_0_2.vhd
./Encoder_sampler.gen/sources_1/bd/Main/ip/Main_axi_uartlite_0_2/Main_axi_uartlite_0_2.dcp
./Encoder_sampler.gen/sources_1/bd/Main/ip/Main_axi_uartlite_0_2/Main_axi_uartlite_0_2_stub.v
./Encoder_sampler.gen/sources_1/bd/Main/ip/Main_axi_uartlite_0_2/Main_axi_uartlite_0_2_stub.vhdl
./Encoder_sampler.gen/sources_1/bd/Main/ip/Main_axi_uartlite_0_2/Main_axi_uartlite_0_2_sim_netlist.v
./Encoder_sampler.gen/sources_1/bd/Main/ip/Main_axi_uartlite_0_2/Main_axi_uartlite_0_2_sim_netlist.vhdl
./Encoder_sampler.gen/sources_1/bd/Main/ip/Main_axi_uartlite_0_2/synth/Main_axi_uartlite_0_2.vhd
./Encoder_sampler.gen/sources_1/bd/Main/ip/Main_axi_uartlite_0_2/Main_axi_uartlite_0_2.xml
./Encoder_sampler.srcs/sources_1/bd/Main/ip/Main_axi_iic_0_1/Main_axi_iic_0_1.xci
./Encoder_sampler.gen/sources_1/bd/Main/ip/Main_axi_iic_0_1/Main_axi_iic_0_1_board.xdc
./Encoder_sampler.gen/sources_1/bd/Main/ipshared/0513/hdl/lib_pkg_v1_0_rfs.vhd
./Encoder_sampler.gen/sources_1/bd/Main/ipshared/ef1e/hdl/lib_cdc_v1_0_rfs.vhd
./Encoder_sampler.gen/sources_1/bd/Main/ipshared/66ea/hdl/axi_lite_ipif_v3_0_vh_rfs.vhd
./Encoder_sampler.gen/sources_1/bd/Main/ipshared/a040/hdl/interrupt_control_v3_1_vh_rfs.vhd
./Encoder_sampler.gen/sources_1/bd/Main/ipshared/eddf/hdl/axi_iic_v2_1_vh_rfs.vhd
./Encoder_sampler.gen/sources_1/bd/Main/ip/Main_axi_iic_0_1/sim/Main_axi_iic_0_1.vhd
./Encoder_sampler.gen/sources_1/bd/Main/ip/Main_axi_iic_0_1/Main_axi_iic_0_1.dcp
./Encoder_sampler.gen/sources_1/bd/Main/ip/Main_axi_iic_0_1/Main_axi_iic_0_1_stub.v
./Encoder_sampler.gen/sources_1/bd/Main/ip/Main_axi_iic_0_1/Main_axi_iic_0_1_stub.vhdl
./Encoder_sampler.gen/sources_1/bd/Main/ip/Main_axi_iic_0_1/Main_axi_iic_0_1_sim_netlist.v
./Encoder_sampler.gen/sources_1/bd/Main/ip/Main_axi_iic_0_1/Main_axi_iic_0_1_sim_netlist.vhdl
./Encoder_sampler.gen/sources_1/bd/Main/ip/Main_axi_iic_0_1/Main_axi_iic_0_1_ooc.xdc
./Encoder_sampler.gen/sources_1/bd/Main/ip/Main_axi_iic_0_1/synth/Main_axi_iic_0_1.vhd
./Encoder_sampler.gen/sources_1/bd/Main/ip/Main_axi_iic_0_1/Main_axi_iic_0_1.xml
./Encoder_sampler.srcs/sources_1/bd/Main/ip/Main_util_vector_logic_0_1/Main_util_vector_logic_0_1.xci
./Encoder_sampler.gen/sources_1/bd/Main/ipshared/3d84/hdl/util_vector_logic_v2_0_vl_rfs.v
./Encoder_sampler.gen/sources_1/bd/Main/ip/Main_util_vector_logic_0_1/sim/Main_util_vector_logic_0_1.v
./Encoder_sampler.gen/sources_1/bd/Main/ip/Main_util_vector_logic_0_1/Main_util_vector_logic_0_1.dcp
./Encoder_sampler.gen/sources_1/bd/Main/ip/Main_util_vector_logic_0_1/Main_util_vector_logic_0_1_stub.v
./Encoder_sampler.gen/sources_1/bd/Main/ip/Main_util_vector_logic_0_1/Main_util_vector_logic_0_1_stub.vhdl
./Encoder_sampler.gen/sources_1/bd/Main/ip/Main_util_vector_logic_0_1/Main_util_vector_logic_0_1_sim_netlist.v
./Encoder_sampler.gen/sources_1/bd/Main/ip/Main_util_vector_logic_0_1/Main_util_vector_logic_0_1_sim_netlist.vhdl
./Encoder_sampler.gen/sources_1/bd/Main/ip/Main_util_vector_logic_0_1/synth/Main_util_vector_logic_0_1.v
./Encoder_sampler.gen/sources_1/bd/Main/ip/Main_util_vector_logic_0_1/Main_util_vector_logic_0_1.xml
./Encoder_sampler.srcs/sources_1/bd/Main/ip/Main_axi_gpio_0_1/Main_axi_gpio_0_1.xci
./Encoder_sampler.gen/sources_1/bd/Main/ip/Main_axi_gpio_0_1/Main_axi_gpio_0_1_board.xdc
./Encoder_sampler.gen/sources_1/bd/Main/ipshared/66ea/hdl/axi_lite_ipif_v3_0_vh_rfs.vhd
./Encoder_sampler.gen/sources_1/bd/Main/ipshared/ef1e/hdl/lib_cdc_v1_0_rfs.vhd
./Encoder_sampler.gen/sources_1/bd/Main/ipshared/a040/hdl/interrupt_control_v3_1_vh_rfs.vhd
./Encoder_sampler.gen/sources_1/bd/Main/ip/Main_axi_gpio_0_1/Main_axi_gpio_0_1_ooc.xdc
./Encoder_sampler.gen/sources_1/bd/Main/ip/Main_axi_gpio_0_1/Main_axi_gpio_0_1.xdc
./Encoder_sampler.gen/sources_1/bd/Main/ipshared/3ed9/hdl/axi_gpio_v2_0_vh_rfs.vhd
./Encoder_sampler.gen/sources_1/bd/Main/ip/Main_axi_gpio_0_1/sim/Main_axi_gpio_0_1.vhd
./Encoder_sampler.gen/sources_1/bd/Main/ip/Main_axi_gpio_0_1/Main_axi_gpio_0_1.dcp
./Encoder_sampler.gen/sources_1/bd/Main/ip/Main_axi_gpio_0_1/Main_axi_gpio_0_1_stub.v
./Encoder_sampler.gen/sources_1/bd/Main/ip/Main_axi_gpio_0_1/Main_axi_gpio_0_1_sim_netlist.v
./Encoder_sampler.gen/sources_1/bd/Main/ip/Main_axi_gpio_0_1/Main_axi_gpio_0_1_sim_netlist.vhdl
./Encoder_sampler.gen/sources_1/bd/Main/ip/Main_axi_gpio_0_1/Main_axi_gpio_0_1_stub.vhdl
./Encoder_sampler.gen/sources_1/bd/Main/ip/Main_axi_gpio_0_1/synth/Main_axi_gpio_0_1.vhd
./Encoder_sampler.gen/sources_1/bd/Main/ip/Main_axi_gpio_0_1/Main_axi_gpio_0_1.xml
./Encoder_sampler.srcs/sources_1/bd/Main/ip/Main_xlconcat_0_0/Main_xlconcat_0_0.xci
./Encoder_sampler.gen/sources_1/bd/Main/ipshared/4b67/hdl/xlconcat_v2_1_vl_rfs.v
./Encoder_sampler.gen/sources_1/bd/Main/ip/Main_xlconcat_0_0/sim/Main_xlconcat_0_0.v
./Encoder_sampler.gen/sources_1/bd/Main/ip/Main_xlconcat_0_0/synth/Main_xlconcat_0_0.v
./Encoder_sampler.gen/sources_1/bd/Main/ip/Main_xlconcat_0_0/Main_xlconcat_0_0.xml
./Encoder_sampler.srcs/sources_1/bd/Main/ip/Main_Input_debouncer_0_3/Main_Input_debouncer_0_3.xci
./Encoder_sampler.gen/sources_1/bd/Main/ip/Main_Input_debouncer_0_3/sim/Main_Input_debouncer_0_3.v
./Encoder_sampler.gen/sources_1/bd/Main/ip/Main_Input_debouncer_0_3/Main_Input_debouncer_0_3_stub.vhdl
./Encoder_sampler.gen/sources_1/bd/Main/ip/Main_Input_debouncer_0_3/Main_Input_debouncer_0_3_stub.v
./Encoder_sampler.gen/sources_1/bd/Main/ip/Main_Input_debouncer_0_3/Main_Input_debouncer_0_3_sim_netlist.v
./Encoder_sampler.gen/sources_1/bd/Main/ip/Main_Input_debouncer_0_3/Main_Input_debouncer_0_3_sim_netlist.vhdl
./Encoder_sampler.gen/sources_1/bd/Main/ip/Main_Input_debouncer_0_3/Main_Input_debouncer_0_3.dcp
./Encoder_sampler.gen/sources_1/bd/Main/ip/Main_Input_debouncer_0_3/synth/Main_Input_debouncer_0_3.v
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
./Encoder_sampler.srcs/sources_1/bd/Main/ip/Main_axi_bram_ctrl_0_1/Main_axi_bram_ctrl_0_1.xci
./Encoder_sampler.gen/sources_1/bd/Main/ipshared/3c31/hdl/axi_bram_ctrl_v4_1_rfs.vhd
./Encoder_sampler.gen/sources_1/bd/Main/ip/Main_axi_bram_ctrl_0_1/sim/Main_axi_bram_ctrl_0_1.vhd
./Encoder_sampler.gen/sources_1/bd/Main/ip/Main_axi_bram_ctrl_0_1/Main_axi_bram_ctrl_0_1_sim_netlist.vhdl
./Encoder_sampler.gen/sources_1/bd/Main/ip/Main_axi_bram_ctrl_0_1/Main_axi_bram_ctrl_0_1_stub.v
./Encoder_sampler.gen/sources_1/bd/Main/ip/Main_axi_bram_ctrl_0_1/Main_axi_bram_ctrl_0_1.dcp
./Encoder_sampler.gen/sources_1/bd/Main/ip/Main_axi_bram_ctrl_0_1/Main_axi_bram_ctrl_0_1_stub.vhdl
./Encoder_sampler.gen/sources_1/bd/Main/ip/Main_axi_bram_ctrl_0_1/Main_axi_bram_ctrl_0_1_sim_netlist.v
./Encoder_sampler.gen/sources_1/bd/Main/ip/Main_axi_bram_ctrl_0_1/synth/Main_axi_bram_ctrl_0_1.vhd
./Encoder_sampler.gen/sources_1/bd/Main/ip/Main_axi_bram_ctrl_0_1/Main_axi_bram_ctrl_0_1_ooc.xdc
./Encoder_sampler.gen/sources_1/bd/Main/ip/Main_axi_bram_ctrl_0_1/Main_axi_bram_ctrl_0_1.xml
./Encoder_sampler.srcs/sources_1/bd/Main/ip/Main_axi_bram_ctrl_0_bram_0/Main_axi_bram_ctrl_0_bram_0.xci
./Encoder_sampler.gen/sources_1/bd/Main/ipshared/25a8/simulation/blk_mem_gen_v8_4.v
./Encoder_sampler.gen/sources_1/bd/Main/ip/Main_axi_bram_ctrl_0_bram_0/sim/Main_axi_bram_ctrl_0_bram_0.v
./Encoder_sampler.gen/sources_1/bd/Main/ip/Main_axi_bram_ctrl_0_bram_0/Main_axi_bram_ctrl_0_bram_0.dcp
./Encoder_sampler.gen/sources_1/bd/Main/ip/Main_axi_bram_ctrl_0_bram_0/Main_axi_bram_ctrl_0_bram_0_stub.v
./Encoder_sampler.gen/sources_1/bd/Main/ip/Main_axi_bram_ctrl_0_bram_0/Main_axi_bram_ctrl_0_bram_0_stub.vhdl
./Encoder_sampler.gen/sources_1/bd/Main/ip/Main_axi_bram_ctrl_0_bram_0/Main_axi_bram_ctrl_0_bram_0_sim_netlist.v
./Encoder_sampler.gen/sources_1/bd/Main/ip/Main_axi_bram_ctrl_0_bram_0/Main_axi_bram_ctrl_0_bram_0_sim_netlist.vhdl
./Encoder_sampler.gen/sources_1/bd/Main/ip/Main_axi_bram_ctrl_0_bram_0/Main_axi_bram_ctrl_0_bram_0_ooc.xdc
./Encoder_sampler.gen/sources_1/bd/Main/ipshared/25a8/hdl/blk_mem_gen_v8_4_vhsyn_rfs.vhd
./Encoder_sampler.gen/sources_1/bd/Main/ip/Main_axi_bram_ctrl_0_bram_0/synth/Main_axi_bram_ctrl_0_bram_0.vhd
./Encoder_sampler.gen/sources_1/bd/Main/ip/Main_axi_bram_ctrl_0_bram_0/Main_axi_bram_ctrl_0_bram_0.xml
./Encoder_sampler.srcs/sources_1/bd/Main/ip/Main_axi_smc_0/Main_axi_smc_0.xci
./Encoder_sampler.gen/sources_1/bd/Main/ip/Main_axi_smc_0/bd_0/bd_4c2d.bd
./Encoder_sampler.gen/sources_1/bd/Main/ip/Main_axi_smc_0/bd_0/ip/ip_0/bd_4c2d_one_0.xci
./Encoder_sampler.gen/sources_1/bd/Main/ipshared/fcfc/hdl/xlconstant_v1_1_vl_rfs.v
./Encoder_sampler.gen/sources_1/bd/Main/ip/Main_axi_smc_0/bd_0/ip/ip_0/sim/bd_4c2d_one_0.v
./Encoder_sampler.gen/sources_1/bd/Main/ip/Main_axi_smc_0/bd_0/ip/ip_0/synth/bd_4c2d_one_0.v
./Encoder_sampler.gen/sources_1/bd/Main/ip/Main_axi_smc_0/bd_0/ip/ip_0/bd_4c2d_one_0.xml
./Encoder_sampler.gen/sources_1/bd/Main/ip/Main_axi_smc_0/bd_0/ip/ip_1/bd_4c2d_psr_aclk_0.xci
./Encoder_sampler.gen/sources_1/bd/Main/ip/Main_axi_smc_0/bd_0/ip/ip_1/bd_4c2d_psr_aclk_0_board.xdc
./Encoder_sampler.gen/sources_1/bd/Main/ipshared/ef1e/hdl/lib_cdc_v1_0_rfs.vhd
./Encoder_sampler.gen/sources_1/bd/Main/ipshared/8842/hdl/proc_sys_reset_v5_0_vh_rfs.vhd
./Encoder_sampler.gen/sources_1/bd/Main/ip/Main_axi_smc_0/bd_0/ip/ip_1/sim/bd_4c2d_psr_aclk_0.vhd
./Encoder_sampler.gen/sources_1/bd/Main/ip/Main_axi_smc_0/bd_0/ip/ip_1/bd_4c2d_psr_aclk_0.xdc
./Encoder_sampler.gen/sources_1/bd/Main/ip/Main_axi_smc_0/bd_0/ip/ip_1/synth/bd_4c2d_psr_aclk_0.vhd
./Encoder_sampler.gen/sources_1/bd/Main/ip/Main_axi_smc_0/bd_0/ip/ip_1/bd_4c2d_psr_aclk_0.xml
./Encoder_sampler.gen/sources_1/bd/Main/ip/Main_axi_smc_0/bd_0/ip/ip_2/bd_4c2d_arinsw_0.xci
./Encoder_sampler.gen/sources_1/bd/Main/ipshared/f0b6/hdl/verilog/sc_util_v1_0_4_constants.vh
./Encoder_sampler.gen/sources_1/bd/Main/ipshared/f0b6/hdl/verilog/sc_util_v1_0_4_constants_noc.vh
./Encoder_sampler.gen/sources_1/bd/Main/ipshared/f0b6/hdl/verilog/sc_util_v1_0_4_structs.svh
./Encoder_sampler.gen/sources_1/bd/Main/ipshared/f0b6/hdl/sc_util_v1_0_vl_rfs.sv
./Encoder_sampler.gen/sources_1/bd/Main/ip/Main_axi_smc_0/bd_0/ip/ip_2/bd_4c2d_arinsw_0_ooc.xdc
./Encoder_sampler.gen/sources_1/bd/Main/ipshared/c012/hdl/sc_switchboard_v1_0_vl_rfs.sv
./Encoder_sampler.gen/sources_1/bd/Main/ip/Main_axi_smc_0/bd_0/ip/ip_2/sim/bd_4c2d_arinsw_0.sv
./Encoder_sampler.gen/sources_1/bd/Main/ip/Main_axi_smc_0/bd_0/ip/ip_2/synth/bd_4c2d_arinsw_0.sv
./Encoder_sampler.gen/sources_1/bd/Main/ip/Main_axi_smc_0/bd_0/ip/ip_2/bd_4c2d_arinsw_0.xml
./Encoder_sampler.gen/sources_1/bd/Main/ip/Main_axi_smc_0/bd_0/ip/ip_3/bd_4c2d_rinsw_0.xci
./Encoder_sampler.gen/sources_1/bd/Main/ipshared/f0b6/hdl/verilog/sc_util_v1_0_4_constants.vh
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
./Encoder_sampler.gen/sources_1/bd/Main/ipshared/f0b6/hdl/sc_util_v1_0_vl_rfs.sv
./Encoder_sampler.gen/sources_1/bd/Main/ipshared/66be/hdl/verilog/sc_node_v1_0_14_t_reqsend.svh
./Encoder_sampler.gen/sources_1/bd/Main/ip/Main_axi_smc_0/bd_0/ip/ip_59/bd_4c2d_m04bn_0_ooc.xdc
./Encoder_sampler.gen/sources_1/bd/Main/ipshared/66be/hdl/sc_node_v1_0_vl_rfs.sv
./Encoder_sampler.gen/sources_1/bd/Main/ip/Main_axi_smc_0/bd_0/ip/ip_59/sim/bd_4c2d_m04bn_0.sv
./Encoder_sampler.gen/sources_1/bd/Main/ip/Main_axi_smc_0/bd_0/ip/ip_59/synth/bd_4c2d_m04bn_0.sv
./Encoder_sampler.gen/sources_1/bd/Main/ip/Main_axi_smc_0/bd_0/ip/ip_59/bd_4c2d_m04bn_0.xml
./Encoder_sampler.gen/sources_1/bd/Main/ip/Main_axi_smc_0/bd_0/ip/ip_60/bd_4c2d_m04e_0.xci
./Encoder_sampler.gen/sources_1/bd/Main/ipshared/f0b6/hdl/verilog/sc_util_v1_0_4_constants.vh
./Encoder_sampler.gen/sources_1/bd/Main/ipshared/f0b6/hdl/verilog/sc_util_v1_0_4_constants_noc.vh
./Encoder_sampler.gen/sources_1/bd/Main/ipshared/f0b6/hdl/verilog/sc_util_v1_0_4_structs.svh
./Encoder_sampler.gen/sources_1/bd/Main/ipshared/f0b6/hdl/sc_util_v1_0_vl_rfs.sv
./Encoder_sampler.gen/sources_1/bd/Main/ipshared/6bba/hdl/sc_exit_v1_0_vl_rfs.sv
./Encoder_sampler.gen/sources_1/bd/Main/ip/Main_axi_smc_0/bd_0/ip/ip_60/sim/bd_4c2d_m04e_0.sv
./Encoder_sampler.gen/sources_1/bd/Main/ip/Main_axi_smc_0/bd_0/ip/ip_60/synth/bd_4c2d_m04e_0.sv
./Encoder_sampler.gen/sources_1/bd/Main/ip/Main_axi_smc_0/bd_0/ip/ip_60/bd_4c2d_m04e_0.xml
./Encoder_sampler.gen/sources_1/bd/Main/ip/Main_axi_smc_0/bd_0/synth/bd_4c2d.v
./Encoder_sampler.gen/sources_1/bd/Main/ip/Main_axi_smc_0/bd_0/sim/bd_4c2d.v
./Encoder_sampler.gen/sources_1/bd/Main/ip/Main_axi_smc_0/bd_0/sim/bd_4c2d.protoinst
./Encoder_sampler.gen/sources_1/bd/Main/ip/Main_axi_smc_0/bd_0/hw_handoff/Main_axi_smc_0.hwh
./Encoder_sampler.gen/sources_1/bd/Main/ip/Main_axi_smc_0/bd_0/synth/Main_axi_smc_0.hwdef
./Encoder_sampler.gen/sources_1/bd/Main/ip/Main_axi_smc_0/sc_xtlm_Main_axi_smc_0.mem
./Encoder_sampler.gen/sources_1/bd/Main/ipshared/f0b6/hdl/verilog/sc_util_v1_0_4_constants.vh
./Encoder_sampler.gen/sources_1/bd/Main/ipshared/f0b6/hdl/verilog/sc_util_v1_0_4_constants_noc.vh
./Encoder_sampler.gen/sources_1/bd/Main/ipshared/f0b6/hdl/verilog/sc_util_v1_0_4_structs.svh
./Encoder_sampler.gen/sources_1/bd/Main/ipshared/f0b6/hdl/sc_util_v1_0_vl_rfs.sv
./Encoder_sampler.gen/sources_1/bd/Main/ipshared/ea34/hdl/sc_mmu_v1_0_vl_rfs.sv
./Encoder_sampler.gen/sources_1/bd/Main/ipshared/4fd2/hdl/sc_transaction_regulator_v1_0_vl_rfs.sv
./Encoder_sampler.gen/sources_1/bd/Main/ipshared/8047/hdl/sc_si_converter_v1_0_vl_rfs.sv
./Encoder_sampler.gen/sources_1/bd/Main/ipshared/66be/hdl/verilog/sc_node_v1_0_14_t_reqsend.svh
./Encoder_sampler.gen/sources_1/bd/Main/ipshared/66be/hdl/sc_node_v1_0_vl_rfs.sv
./Encoder_sampler.gen/sources_1/bd/Main/ipshared/c012/hdl/sc_switchboard_v1_0_vl_rfs.sv
./Encoder_sampler.gen/sources_1/bd/Main/ipshared/f38e/hdl/sc_axi2sc_v1_0_vl_rfs.sv
./Encoder_sampler.gen/sources_1/bd/Main/ipshared/9cc5/hdl/sc_sc2axi_v1_0_vl_rfs.sv
./Encoder_sampler.gen/sources_1/bd/Main/ipshared/6bba/hdl/sc_exit_v1_0_vl_rfs.sv
./Encoder_sampler.gen/sources_1/bd/Main/ipshared/ec67/hdl/axi_infrastructure_v1_1_0.vh
./Encoder_sampler.gen/sources_1/bd/Main/ipshared/ec67/hdl/axi_infrastructure_v1_1_vl_rfs.v
./Encoder_sampler.gen/sources_1/bd/Main/ipshared/0a3f/hdl/axi_register_slice_v2_1_vl_rfs.v
./Encoder_sampler.gen/sources_1/bd/Main/ipshared/1033/hdl/axi_vip_v1_1_vl_rfs.sv
./Encoder_sampler.gen/sources_1/bd/Main/ipshared/ef1e/hdl/lib_cdc_v1_0_rfs.vhd
./Encoder_sampler.gen/sources_1/bd/Main/ipshared/8842/hdl/proc_sys_reset_v5_0_vh_rfs.vhd
./Encoder_sampler.gen/sources_1/bd/Main/ipshared/fcfc/hdl/xlconstant_v1_1_vl_rfs.v
./Encoder_sampler.gen/sources_1/bd/Main/ip/Main_axi_smc_0/sim/Main_axi_smc_0.v
./Encoder_sampler.gen/sources_1/bd/Main/ip/Main_axi_smc_0/Main_axi_smc_0.dcp
./Encoder_sampler.gen/sources_1/bd/Main/ip/Main_axi_smc_0/Main_axi_smc_0_stub.v
./Encoder_sampler.gen/sources_1/bd/Main/ip/Main_axi_smc_0/Main_axi_smc_0_stub.vhdl
./Encoder_sampler.gen/sources_1/bd/Main/ip/Main_axi_smc_0/Main_axi_smc_0_sim_netlist.v
./Encoder_sampler.gen/sources_1/bd/Main/ip/Main_axi_smc_0/Main_axi_smc_0_sim_netlist.vhdl
./Encoder_sampler.gen/sources_1/bd/Main/ip/Main_axi_smc_0/ooc.xdc
./Encoder_sampler.gen/sources_1/bd/Main/ip/Main_axi_smc_0/synth/Main_axi_smc_0.v
./Encoder_sampler.gen/sources_1/bd/Main/ip/Main_axi_smc_0/Main_axi_smc_0.xml
./Encoder_sampler.srcs/sources_1/bd/Main/ip/Main_AD7983_driver_0_0/Main_AD7983_driver_0_0.xci
./Encoder_sampler.gen/sources_1/bd/Main/ip/Main_AD7983_driver_0_0/sim/Main_AD7983_driver_0_0.v
./Encoder_sampler.gen/sources_1/bd/Main/ip/Main_AD7983_driver_0_0/Main_AD7983_driver_0_0.dcp
./Encoder_sampler.gen/sources_1/bd/Main/ip/Main_AD7983_driver_0_0/Main_AD7983_driver_0_0_stub.v
./Encoder_sampler.gen/sources_1/bd/Main/ip/Main_AD7983_driver_0_0/Main_AD7983_driver_0_0_stub.vhdl
./Encoder_sampler.gen/sources_1/bd/Main/ip/Main_AD7983_driver_0_0/Main_AD7983_driver_0_0_sim_netlist.v
./Encoder_sampler.gen/sources_1/bd/Main/ip/Main_AD7983_driver_0_0/Main_AD7983_driver_0_0_sim_netlist.vhdl
./Encoder_sampler.gen/sources_1/bd/Main/ip/Main_AD7983_driver_0_0/synth/Main_AD7983_driver_0_0.v
./Encoder_sampler.gen/sources_1/bd/Main/ip/Main_AD7983_driver_0_0/Main_AD7983_driver_0_0.xml
./Encoder_sampler.srcs/sources_1/bd/Main/ip/Main_sampling_controller_0_0/Main_sampling_controller_0_0.xci
./Encoder_sampler.gen/sources_1/bd/Main/ip/Main_sampling_controller_0_0/sim/Main_sampling_controller_0_0.v
./Encoder_sampler.gen/sources_1/bd/Main/ip/Main_sampling_controller_0_0/Main_sampling_controller_0_0.dcp
./Encoder_sampler.gen/sources_1/bd/Main/ip/Main_sampling_controller_0_0/Main_sampling_controller_0_0_stub.v
./Encoder_sampler.gen/sources_1/bd/Main/ip/Main_sampling_controller_0_0/Main_sampling_controller_0_0_stub.vhdl
./Encoder_sampler.gen/sources_1/bd/Main/ip/Main_sampling_controller_0_0/Main_sampling_controller_0_0_sim_netlist.v
./Encoder_sampler.gen/sources_1/bd/Main/ip/Main_sampling_controller_0_0/Main_sampling_controller_0_0_sim_netlist.vhdl
./Encoder_sampler.gen/sources_1/bd/Main/ip/Main_sampling_controller_0_0/synth/Main_sampling_controller_0_0.v
./Encoder_sampler.gen/sources_1/bd/Main/ip/Main_sampling_controller_0_0/Main_sampling_controller_0_0.xml
./Encoder_sampler.gen/sources_1/bd/Main/synth/Main.v
./Encoder_sampler.gen/sources_1/bd/Main/sim/Main.v
./Encoder_sampler.gen/sources_1/bd/Main/Main.bmm
./Encoder_sampler.gen/sources_1/bd/Main/Main_ooc.xdc
./Encoder_sampler.gen/sources_1/bd/Main/hw_handoff/Main.hwh
./Encoder_sampler.gen/sources_1/bd/Main/Main.bda
./Encoder_sampler.gen/sources_1/bd/Main/synth/Main.hwdef
./Encoder_sampler.gen/sources_1/bd/Main/sim/Main.protoinst

<constrs_1>
./Encoder_sampler.srcs/constrs_1/new/Pinout.xdc

<sim_1>
None

<utils_1>
./Encoder_sampler.srcs/utils_1/imports/synth_1/Main_wrapper.dcp

<Main_microblaze_0_3>
./Encoder_sampler.srcs/sources_1/bd/Main/ip/Main_microblaze_0_3/Main_microblaze_0_3.xci
./Encoder_sampler.gen/sources_1/bd/Main/ip/Main_microblaze_0_3/data/mb_bootloop_le.elf
./Encoder_sampler.gen/sources_1/bd/Main/ip/Main_microblaze_0_3/Main_microblaze_0_3.xdc
./Encoder_sampler.gen/sources_1/bd/Main/ip/Main_microblaze_0_3/Main_microblaze_0_3_ooc_debug.xdc
./Encoder_sampler.gen/sources_1/bd/Main/ipshared/057e/hdl/microblaze_v11_0_vh_rfs.vhd
./Encoder_sampler.gen/sources_1/bd/Main/ip/Main_microblaze_0_3/sim/Main_microblaze_0_3.vhd
./Encoder_sampler.gen/sources_1/bd/Main/ip/Main_microblaze_0_3/Main_microblaze_0_3.dcp
./Encoder_sampler.gen/sources_1/bd/Main/ip/Main_microblaze_0_3/Main_microblaze_0_3_stub.v
./Encoder_sampler.gen/sources_1/bd/Main/ip/Main_microblaze_0_3/Main_microblaze_0_3_stub.vhdl
./Encoder_sampler.gen/sources_1/bd/Main/ip/Main_microblaze_0_3/Main_microblaze_0_3_sim_netlist.v
./Encoder_sampler.gen/sources_1/bd/Main/ip/Main_microblaze_0_3/Main_microblaze_0_3_sim_netlist.vhdl
./Encoder_sampler.gen/sources_1/bd/Main/ip/Main_microblaze_0_3/synth/Main_microblaze_0_3.vhd
./Encoder_sampler.gen/sources_1/bd/Main/ip/Main_microblaze_0_3/Main_microblaze_0_3_ooc.xdc
./Encoder_sampler.gen/sources_1/bd/Main/ip/Main_microblaze_0_3/Main_microblaze_0_3.xml

<Main_microblaze_0_axi_intc_3>
./Encoder_sampler.srcs/sources_1/bd/Main/ip/Main_microblaze_0_axi_intc_3/Main_microblaze_0_axi_intc_3.xci
./Encoder_sampler.gen/sources_1/bd/Main/ipshared/66ea/hdl/axi_lite_ipif_v3_0_vh_rfs.vhd
./Encoder_sampler.gen/sources_1/bd/Main/ip/Main_microblaze_0_axi_intc_3/Main_microblaze_0_axi_intc_3.xdc
./Encoder_sampler.gen/sources_1/bd/Main/ip/Main_microblaze_0_axi_intc_3/Main_microblaze_0_axi_intc_3_clocks.xdc
./Encoder_sampler.gen/sources_1/bd/Main/ip/Main_microblaze_0_axi_intc_3/Main_microblaze_0_axi_intc_3_ooc.xdc
./Encoder_sampler.gen/sources_1/bd/Main/ipshared/802b/hdl/axi_intc_v4_1_vh_rfs.vhd
./Encoder_sampler.gen/sources_1/bd/Main/ip/Main_microblaze_0_axi_intc_3/sim/Main_microblaze_0_axi_intc_3.vhd
./Encoder_sampler.gen/sources_1/bd/Main/ip/Main_microblaze_0_axi_intc_3/Main_microblaze_0_axi_intc_3.dcp
./Encoder_sampler.gen/sources_1/bd/Main/ip/Main_microblaze_0_axi_intc_3/Main_microblaze_0_axi_intc_3_stub.v
./Encoder_sampler.gen/sources_1/bd/Main/ip/Main_microblaze_0_axi_intc_3/Main_microblaze_0_axi_intc_3_stub.vhdl
./Encoder_sampler.gen/sources_1/bd/Main/ip/Main_microblaze_0_axi_intc_3/Main_microblaze_0_axi_intc_3_sim_netlist.v
./Encoder_sampler.gen/sources_1/bd/Main/ip/Main_microblaze_0_axi_intc_3/Main_microblaze_0_axi_intc_3_sim_netlist.vhdl
./Encoder_sampler.gen/sources_1/bd/Main/ip/Main_microblaze_0_axi_intc_3/synth/Main_microblaze_0_axi_intc_3.vhd
./Encoder_sampler.gen/sources_1/bd/Main/ip/Main_microblaze_0_axi_intc_3/Main_microblaze_0_axi_intc_3.xml

<Main_clk_wiz_0_2>
./Encoder_sampler.srcs/sources_1/bd/Main/ip/Main_clk_wiz_0_2/Main_clk_wiz_0_2.xci
./Encoder_sampler.gen/sources_1/bd/Main/ip/Main_clk_wiz_0_2/Main_clk_wiz_0_2_board.xdc
./Encoder_sampler.gen/sources_1/bd/Main/ip/Main_clk_wiz_0_2/Main_clk_wiz_0_2.xdc
./Encoder_sampler.gen/sources_1/bd/Main/ip/Main_clk_wiz_0_2/Main_clk_wiz_0_2_ooc.xdc
./Encoder_sampler.gen/sources_1/bd/Main/ipshared/4e49/mmcm_pll_drp_func_7s_mmcm.vh
./Encoder_sampler.gen/sources_1/bd/Main/ipshared/4e49/mmcm_pll_drp_func_7s_pll.vh
./Encoder_sampler.gen/sources_1/bd/Main/ipshared/4e49/mmcm_pll_drp_func_us_mmcm.vh
./Encoder_sampler.gen/sources_1/bd/Main/ipshared/4e49/mmcm_pll_drp_func_us_pll.vh
./Encoder_sampler.gen/sources_1/bd/Main/ipshared/4e49/mmcm_pll_drp_func_us_plus_pll.vh
./Encoder_sampler.gen/sources_1/bd/Main/ipshared/4e49/mmcm_pll_drp_func_us_plus_mmcm.vh
./Encoder_sampler.gen/sources_1/bd/Main/ip/Main_clk_wiz_0_2/Main_clk_wiz_0_2_clk_wiz.v
./Encoder_sampler.gen/sources_1/bd/Main/ip/Main_clk_wiz_0_2/Main_clk_wiz_0_2.v
./Encoder_sampler.gen/sources_1/bd/Main/ip/Main_clk_wiz_0_2/Main_clk_wiz_0_2.dcp
./Encoder_sampler.gen/sources_1/bd/Main/ip/Main_clk_wiz_0_2/Main_clk_wiz_0_2_stub.v
./Encoder_sampler.gen/sources_1/bd/Main/ip/Main_clk_wiz_0_2/Main_clk_wiz_0_2_stub.vhdl
./Encoder_sampler.gen/sources_1/bd/Main/ip/Main_clk_wiz_0_2/Main_clk_wiz_0_2_sim_netlist.v
./Encoder_sampler.gen/sources_1/bd/Main/ip/Main_clk_wiz_0_2/Main_clk_wiz_0_2_sim_netlist.vhdl
./Encoder_sampler.gen/sources_1/bd/Main/ip/Main_clk_wiz_0_2/Main_clk_wiz_0_2.xml

<Main_dlmb_v10_4>
./Encoder_sampler.srcs/sources_1/bd/Main/ip/Main_dlmb_v10_4/Main_dlmb_v10_4.xci
./Encoder_sampler.gen/sources_1/bd/Main/ipshared/cd1d/hdl/lmb_v10_v3_0_vh_rfs.vhd
./Encoder_sampler.gen/sources_1/bd/Main/ip/Main_dlmb_v10_4/sim/Main_dlmb_v10_4.vhd
./Encoder_sampler.gen/sources_1/bd/Main/ip/Main_dlmb_v10_4/Main_dlmb_v10_4.dcp
./Encoder_sampler.gen/sources_1/bd/Main/ip/Main_dlmb_v10_4/Main_dlmb_v10_4_stub.v
./Encoder_sampler.gen/sources_1/bd/Main/ip/Main_dlmb_v10_4/Main_dlmb_v10_4_stub.vhdl
./Encoder_sampler.gen/sources_1/bd/Main/ip/Main_dlmb_v10_4/Main_dlmb_v10_4_sim_netlist.v
./Encoder_sampler.gen/sources_1/bd/Main/ip/Main_dlmb_v10_4/Main_dlmb_v10_4_sim_netlist.vhdl
./Encoder_sampler.gen/sources_1/bd/Main/ip/Main_dlmb_v10_4/synth/Main_dlmb_v10_4.vhd
./Encoder_sampler.gen/sources_1/bd/Main/ip/Main_dlmb_v10_4/Main_dlmb_v10_4_ooc.xdc
./Encoder_sampler.gen/sources_1/bd/Main/ip/Main_dlmb_v10_4/Main_dlmb_v10_4.xml

<Main_ilmb_v10_4>
./Encoder_sampler.srcs/sources_1/bd/Main/ip/Main_ilmb_v10_4/Main_ilmb_v10_4.xci
./Encoder_sampler.gen/sources_1/bd/Main/ipshared/cd1d/hdl/lmb_v10_v3_0_vh_rfs.vhd
./Encoder_sampler.gen/sources_1/bd/Main/ip/Main_ilmb_v10_4/sim/Main_ilmb_v10_4.vhd
./Encoder_sampler.gen/sources_1/bd/Main/ip/Main_ilmb_v10_4/Main_ilmb_v10_4.dcp
./Encoder_sampler.gen/sources_1/bd/Main/ip/Main_ilmb_v10_4/Main_ilmb_v10_4_stub.v
./Encoder_sampler.gen/sources_1/bd/Main/ip/Main_ilmb_v10_4/Main_ilmb_v10_4_stub.vhdl
./Encoder_sampler.gen/sources_1/bd/Main/ip/Main_ilmb_v10_4/Main_ilmb_v10_4_sim_netlist.v
./Encoder_sampler.gen/sources_1/bd/Main/ip/Main_ilmb_v10_4/Main_ilmb_v10_4_sim_netlist.vhdl
./Encoder_sampler.gen/sources_1/bd/Main/ip/Main_ilmb_v10_4/synth/Main_ilmb_v10_4.vhd
./Encoder_sampler.gen/sources_1/bd/Main/ip/Main_ilmb_v10_4/Main_ilmb_v10_4_ooc.xdc
./Encoder_sampler.gen/sources_1/bd/Main/ip/Main_ilmb_v10_4/Main_ilmb_v10_4.xml

<Main_ilmb_bram_if_cntlr_4>
./Encoder_sampler.srcs/sources_1/bd/Main/ip/Main_ilmb_bram_if_cntlr_4/Main_ilmb_bram_if_cntlr_4.xci
./Encoder_sampler.gen/sources_1/bd/Main/ipshared/a177/hdl/lmb_bram_if_cntlr_v4_0_vh_rfs.vhd
./Encoder_sampler.gen/sources_1/bd/Main/ip/Main_ilmb_bram_if_cntlr_4/sim/Main_ilmb_bram_if_cntlr_4.vhd
./Encoder_sampler.gen/sources_1/bd/Main/ip/Main_ilmb_bram_if_cntlr_4/Main_ilmb_bram_if_cntlr_4.dcp
./Encoder_sampler.gen/sources_1/bd/Main/ip/Main_ilmb_bram_if_cntlr_4/Main_ilmb_bram_if_cntlr_4_stub.v
./Encoder_sampler.gen/sources_1/bd/Main/ip/Main_ilmb_bram_if_cntlr_4/Main_ilmb_bram_if_cntlr_4_stub.vhdl
./Encoder_sampler.gen/sources_1/bd/Main/ip/Main_ilmb_bram_if_cntlr_4/Main_ilmb_bram_if_cntlr_4_sim_netlist.v
./Encoder_sampler.gen/sources_1/bd/Main/ip/Main_ilmb_bram_if_cntlr_4/Main_ilmb_bram_if_cntlr_4_sim_netlist.vhdl
./Encoder_sampler.gen/sources_1/bd/Main/ip/Main_ilmb_bram_if_cntlr_4/synth/Main_ilmb_bram_if_cntlr_4.vhd
./Encoder_sampler.gen/sources_1/bd/Main/ip/Main_ilmb_bram_if_cntlr_4/Main_ilmb_bram_if_cntlr_4_ooc.xdc
./Encoder_sampler.gen/sources_1/bd/Main/ip/Main_ilmb_bram_if_cntlr_4/Main_ilmb_bram_if_cntlr_4.xml

<Main_lmb_bram_4>
./Encoder_sampler.srcs/sources_1/bd/Main/ip/Main_lmb_bram_4/Main_lmb_bram_4.xci
./Encoder_sampler.gen/sources_1/bd/Main/ipshared/25a8/simulation/blk_mem_gen_v8_4.v
./Encoder_sampler.gen/sources_1/bd/Main/ip/Main_lmb_bram_4/sim/Main_lmb_bram_4.v
./Encoder_sampler.gen/sources_1/bd/Main/ip/Main_lmb_bram_4/Main_lmb_bram_4.dcp
./Encoder_sampler.gen/sources_1/bd/Main/ip/Main_lmb_bram_4/Main_lmb_bram_4_stub.v
./Encoder_sampler.gen/sources_1/bd/Main/ip/Main_lmb_bram_4/Main_lmb_bram_4_stub.vhdl
./Encoder_sampler.gen/sources_1/bd/Main/ip/Main_lmb_bram_4/Main_lmb_bram_4_sim_netlist.v
./Encoder_sampler.gen/sources_1/bd/Main/ip/Main_lmb_bram_4/Main_lmb_bram_4_sim_netlist.vhdl
./Encoder_sampler.gen/sources_1/bd/Main/ip/Main_lmb_bram_4/Main_lmb_bram_4_ooc.xdc
./Encoder_sampler.gen/sources_1/bd/Main/ipshared/25a8/hdl/blk_mem_gen_v8_4_vhsyn_rfs.vhd
./Encoder_sampler.gen/sources_1/bd/Main/ip/Main_lmb_bram_4/synth/Main_lmb_bram_4.vhd
./Encoder_sampler.gen/sources_1/bd/Main/ip/Main_lmb_bram_4/Main_lmb_bram_4.xml

<Main_mdm_1_4>
./Encoder_sampler.srcs/sources_1/bd/Main/ip/Main_mdm_1_4/Main_mdm_1_4.xci
./Encoder_sampler.gen/sources_1/bd/Main/ipshared/66ea/hdl/axi_lite_ipif_v3_0_vh_rfs.vhd
./Encoder_sampler.gen/sources_1/bd/Main/ip/Main_mdm_1_4/Main_mdm_1_4.xdc
./Encoder_sampler.gen/sources_1/bd/Main/ip/Main_mdm_1_4/Main_mdm_1_4_ooc_trace.xdc
./Encoder_sampler.gen/sources_1/bd/Main/ipshared/b8f4/hdl/mdm_v3_2_vh_rfs.vhd
./Encoder_sampler.gen/sources_1/bd/Main/ip/Main_mdm_1_4/sim/Main_mdm_1_4.vhd
./Encoder_sampler.gen/sources_1/bd/Main/ip/Main_mdm_1_4/Main_mdm_1_4.dcp
./Encoder_sampler.gen/sources_1/bd/Main/ip/Main_mdm_1_4/Main_mdm_1_4_stub.v
./Encoder_sampler.gen/sources_1/bd/Main/ip/Main_mdm_1_4/Main_mdm_1_4_stub.vhdl
./Encoder_sampler.gen/sources_1/bd/Main/ip/Main_mdm_1_4/Main_mdm_1_4_sim_netlist.v
./Encoder_sampler.gen/sources_1/bd/Main/ip/Main_mdm_1_4/Main_mdm_1_4_sim_netlist.vhdl
./Encoder_sampler.gen/sources_1/bd/Main/ip/Main_mdm_1_4/synth/Main_mdm_1_4.vhd
./Encoder_sampler.gen/sources_1/bd/Main/ip/Main_mdm_1_4/Main_mdm_1_4.xml

<Main_rst_clk_wiz_0_100M_1>
./Encoder_sampler.srcs/sources_1/bd/Main/ip/Main_rst_clk_wiz_0_100M_1/Main_rst_clk_wiz_0_100M_1.xci
./Encoder_sampler.gen/sources_1/bd/Main/ip/Main_rst_clk_wiz_0_100M_1/Main_rst_clk_wiz_0_100M_1_board.xdc
./Encoder_sampler.gen/sources_1/bd/Main/ipshared/ef1e/hdl/lib_cdc_v1_0_rfs.vhd
./Encoder_sampler.gen/sources_1/bd/Main/ipshared/8842/hdl/proc_sys_reset_v5_0_vh_rfs.vhd
./Encoder_sampler.gen/sources_1/bd/Main/ip/Main_rst_clk_wiz_0_100M_1/sim/Main_rst_clk_wiz_0_100M_1.vhd
./Encoder_sampler.gen/sources_1/bd/Main/ip/Main_rst_clk_wiz_0_100M_1/Main_rst_clk_wiz_0_100M_1.dcp
./Encoder_sampler.gen/sources_1/bd/Main/ip/Main_rst_clk_wiz_0_100M_1/Main_rst_clk_wiz_0_100M_1_stub.v
./Encoder_sampler.gen/sources_1/bd/Main/ip/Main_rst_clk_wiz_0_100M_1/Main_rst_clk_wiz_0_100M_1_stub.vhdl
./Encoder_sampler.gen/sources_1/bd/Main/ip/Main_rst_clk_wiz_0_100M_1/Main_rst_clk_wiz_0_100M_1_sim_netlist.v
./Encoder_sampler.gen/sources_1/bd/Main/ip/Main_rst_clk_wiz_0_100M_1/Main_rst_clk_wiz_0_100M_1_sim_netlist.vhdl
./Encoder_sampler.gen/sources_1/bd/Main/ip/Main_rst_clk_wiz_0_100M_1/Main_rst_clk_wiz_0_100M_1.xdc
./Encoder_sampler.gen/sources_1/bd/Main/ip/Main_rst_clk_wiz_0_100M_1/synth/Main_rst_clk_wiz_0_100M_1.vhd
./Encoder_sampler.gen/sources_1/bd/Main/ip/Main_rst_clk_wiz_0_100M_1/Main_rst_clk_wiz_0_100M_1_ooc.xdc
./Encoder_sampler.gen/sources_1/bd/Main/ip/Main_rst_clk_wiz_0_100M_1/Main_rst_clk_wiz_0_100M_1.xml

<Main_axi_uartlite_0_2>
./Encoder_sampler.srcs/sources_1/bd/Main/ip/Main_axi_uartlite_0_2/Main_axi_uartlite_0_2.xci
./Encoder_sampler.gen/sources_1/bd/Main/ip/Main_axi_uartlite_0_2/Main_axi_uartlite_0_2_board.xdc
./Encoder_sampler.gen/sources_1/bd/Main/ipshared/66ea/hdl/axi_lite_ipif_v3_0_vh_rfs.vhd
./Encoder_sampler.gen/sources_1/bd/Main/ipshared/0513/hdl/lib_pkg_v1_0_rfs.vhd
./Encoder_sampler.gen/sources_1/bd/Main/ipshared/51ce/hdl/lib_srl_fifo_v1_0_rfs.vhd
./Encoder_sampler.gen/sources_1/bd/Main/ipshared/ef1e/hdl/lib_cdc_v1_0_rfs.vhd
./Encoder_sampler.gen/sources_1/bd/Main/ip/Main_axi_uartlite_0_2/Main_axi_uartlite_0_2_ooc.xdc
./Encoder_sampler.gen/sources_1/bd/Main/ip/Main_axi_uartlite_0_2/Main_axi_uartlite_0_2.xdc
./Encoder_sampler.gen/sources_1/bd/Main/ipshared/5d2b/hdl/axi_uartlite_v2_0_vh_rfs.vhd
./Encoder_sampler.gen/sources_1/bd/Main/ip/Main_axi_uartlite_0_2/sim/Main_axi_uartlite_0_2.vhd
./Encoder_sampler.gen/sources_1/bd/Main/ip/Main_axi_uartlite_0_2/Main_axi_uartlite_0_2.dcp
./Encoder_sampler.gen/sources_1/bd/Main/ip/Main_axi_uartlite_0_2/Main_axi_uartlite_0_2_stub.v
./Encoder_sampler.gen/sources_1/bd/Main/ip/Main_axi_uartlite_0_2/Main_axi_uartlite_0_2_stub.vhdl
./Encoder_sampler.gen/sources_1/bd/Main/ip/Main_axi_uartlite_0_2/Main_axi_uartlite_0_2_sim_netlist.v
./Encoder_sampler.gen/sources_1/bd/Main/ip/Main_axi_uartlite_0_2/Main_axi_uartlite_0_2_sim_netlist.vhdl
./Encoder_sampler.gen/sources_1/bd/Main/ip/Main_axi_uartlite_0_2/synth/Main_axi_uartlite_0_2.vhd
./Encoder_sampler.gen/sources_1/bd/Main/ip/Main_axi_uartlite_0_2/Main_axi_uartlite_0_2.xml

<Main_axi_iic_0_1>
./Encoder_sampler.srcs/sources_1/bd/Main/ip/Main_axi_iic_0_1/Main_axi_iic_0_1.xci
./Encoder_sampler.gen/sources_1/bd/Main/ip/Main_axi_iic_0_1/Main_axi_iic_0_1_board.xdc
./Encoder_sampler.gen/sources_1/bd/Main/ipshared/0513/hdl/lib_pkg_v1_0_rfs.vhd
./Encoder_sampler.gen/sources_1/bd/Main/ipshared/ef1e/hdl/lib_cdc_v1_0_rfs.vhd
./Encoder_sampler.gen/sources_1/bd/Main/ipshared/66ea/hdl/axi_lite_ipif_v3_0_vh_rfs.vhd
./Encoder_sampler.gen/sources_1/bd/Main/ipshared/a040/hdl/interrupt_control_v3_1_vh_rfs.vhd
./Encoder_sampler.gen/sources_1/bd/Main/ipshared/eddf/hdl/axi_iic_v2_1_vh_rfs.vhd
./Encoder_sampler.gen/sources_1/bd/Main/ip/Main_axi_iic_0_1/sim/Main_axi_iic_0_1.vhd
./Encoder_sampler.gen/sources_1/bd/Main/ip/Main_axi_iic_0_1/Main_axi_iic_0_1.dcp
./Encoder_sampler.gen/sources_1/bd/Main/ip/Main_axi_iic_0_1/Main_axi_iic_0_1_stub.v
./Encoder_sampler.gen/sources_1/bd/Main/ip/Main_axi_iic_0_1/Main_axi_iic_0_1_stub.vhdl
./Encoder_sampler.gen/sources_1/bd/Main/ip/Main_axi_iic_0_1/Main_axi_iic_0_1_sim_netlist.v
./Encoder_sampler.gen/sources_1/bd/Main/ip/Main_axi_iic_0_1/Main_axi_iic_0_1_sim_netlist.vhdl
./Encoder_sampler.gen/sources_1/bd/Main/ip/Main_axi_iic_0_1/Main_axi_iic_0_1_ooc.xdc
./Encoder_sampler.gen/sources_1/bd/Main/ip/Main_axi_iic_0_1/synth/Main_axi_iic_0_1.vhd
./Encoder_sampler.gen/sources_1/bd/Main/ip/Main_axi_iic_0_1/Main_axi_iic_0_1.xml

<Main_util_vector_logic_0_1>
./Encoder_sampler.srcs/sources_1/bd/Main/ip/Main_util_vector_logic_0_1/Main_util_vector_logic_0_1.xci
./Encoder_sampler.gen/sources_1/bd/Main/ipshared/3d84/hdl/util_vector_logic_v2_0_vl_rfs.v
./Encoder_sampler.gen/sources_1/bd/Main/ip/Main_util_vector_logic_0_1/sim/Main_util_vector_logic_0_1.v
./Encoder_sampler.gen/sources_1/bd/Main/ip/Main_util_vector_logic_0_1/Main_util_vector_logic_0_1.dcp
./Encoder_sampler.gen/sources_1/bd/Main/ip/Main_util_vector_logic_0_1/Main_util_vector_logic_0_1_stub.v
./Encoder_sampler.gen/sources_1/bd/Main/ip/Main_util_vector_logic_0_1/Main_util_vector_logic_0_1_stub.vhdl
./Encoder_sampler.gen/sources_1/bd/Main/ip/Main_util_vector_logic_0_1/Main_util_vector_logic_0_1_sim_netlist.v
./Encoder_sampler.gen/sources_1/bd/Main/ip/Main_util_vector_logic_0_1/Main_util_vector_logic_0_1_sim_netlist.vhdl
./Encoder_sampler.gen/sources_1/bd/Main/ip/Main_util_vector_logic_0_1/synth/Main_util_vector_logic_0_1.v
./Encoder_sampler.gen/sources_1/bd/Main/ip/Main_util_vector_logic_0_1/Main_util_vector_logic_0_1.xml

<Main_axi_bram_ctrl_0_bram_0>
./Encoder_sampler.srcs/sources_1/bd/Main/ip/Main_axi_bram_ctrl_0_bram_0/Main_axi_bram_ctrl_0_bram_0.xci
./Encoder_sampler.gen/sources_1/bd/Main/ipshared/25a8/simulation/blk_mem_gen_v8_4.v
./Encoder_sampler.gen/sources_1/bd/Main/ip/Main_axi_bram_ctrl_0_bram_0/sim/Main_axi_bram_ctrl_0_bram_0.v
./Encoder_sampler.gen/sources_1/bd/Main/ip/Main_axi_bram_ctrl_0_bram_0/Main_axi_bram_ctrl_0_bram_0.dcp
./Encoder_sampler.gen/sources_1/bd/Main/ip/Main_axi_bram_ctrl_0_bram_0/Main_axi_bram_ctrl_0_bram_0_stub.v
./Encoder_sampler.gen/sources_1/bd/Main/ip/Main_axi_bram_ctrl_0_bram_0/Main_axi_bram_ctrl_0_bram_0_stub.vhdl
./Encoder_sampler.gen/sources_1/bd/Main/ip/Main_axi_bram_ctrl_0_bram_0/Main_axi_bram_ctrl_0_bram_0_sim_netlist.v
./Encoder_sampler.gen/sources_1/bd/Main/ip/Main_axi_bram_ctrl_0_bram_0/Main_axi_bram_ctrl_0_bram_0_sim_netlist.vhdl
./Encoder_sampler.gen/sources_1/bd/Main/ip/Main_axi_bram_ctrl_0_bram_0/Main_axi_bram_ctrl_0_bram_0_ooc.xdc
./Encoder_sampler.gen/sources_1/bd/Main/ipshared/25a8/hdl/blk_mem_gen_v8_4_vhsyn_rfs.vhd
./Encoder_sampler.gen/sources_1/bd/Main/ip/Main_axi_bram_ctrl_0_bram_0/synth/Main_axi_bram_ctrl_0_bram_0.vhd
./Encoder_sampler.gen/sources_1/bd/Main/ip/Main_axi_bram_ctrl_0_bram_0/Main_axi_bram_ctrl_0_bram_0.xml

<Main_sampling_controller_0_0>
./Encoder_sampler.srcs/sources_1/bd/Main/ip/Main_sampling_controller_0_0/Main_sampling_controller_0_0.xci
./Encoder_sampler.gen/sources_1/bd/Main/ip/Main_sampling_controller_0_0/sim/Main_sampling_controller_0_0.v
./Encoder_sampler.gen/sources_1/bd/Main/ip/Main_sampling_controller_0_0/Main_sampling_controller_0_0.dcp
./Encoder_sampler.gen/sources_1/bd/Main/ip/Main_sampling_controller_0_0/Main_sampling_controller_0_0_stub.v
./Encoder_sampler.gen/sources_1/bd/Main/ip/Main_sampling_controller_0_0/Main_sampling_controller_0_0_stub.vhdl
./Encoder_sampler.gen/sources_1/bd/Main/ip/Main_sampling_controller_0_0/Main_sampling_controller_0_0_sim_netlist.v
./Encoder_sampler.gen/sources_1/bd/Main/ip/Main_sampling_controller_0_0/Main_sampling_controller_0_0_sim_netlist.vhdl
./Encoder_sampler.gen/sources_1/bd/Main/ip/Main_sampling_controller_0_0/synth/Main_sampling_controller_0_0.v
./Encoder_sampler.gen/sources_1/bd/Main/ip/Main_sampling_controller_0_0/Main_sampling_controller_0_0.xml

<Main_AD7983_driver_0_0>
./Encoder_sampler.srcs/sources_1/bd/Main/ip/Main_AD7983_driver_0_0/Main_AD7983_driver_0_0.xci
./Encoder_sampler.gen/sources_1/bd/Main/ip/Main_AD7983_driver_0_0/sim/Main_AD7983_driver_0_0.v
./Encoder_sampler.gen/sources_1/bd/Main/ip/Main_AD7983_driver_0_0/Main_AD7983_driver_0_0.dcp
./Encoder_sampler.gen/sources_1/bd/Main/ip/Main_AD7983_driver_0_0/Main_AD7983_driver_0_0_stub.v
./Encoder_sampler.gen/sources_1/bd/Main/ip/Main_AD7983_driver_0_0/Main_AD7983_driver_0_0_stub.vhdl
./Encoder_sampler.gen/sources_1/bd/Main/ip/Main_AD7983_driver_0_0/Main_AD7983_driver_0_0_sim_netlist.v
./Encoder_sampler.gen/sources_1/bd/Main/ip/Main_AD7983_driver_0_0/Main_AD7983_driver_0_0_sim_netlist.vhdl
./Encoder_sampler.gen/sources_1/bd/Main/ip/Main_AD7983_driver_0_0/synth/Main_AD7983_driver_0_0.v
./Encoder_sampler.gen/sources_1/bd/Main/ip/Main_AD7983_driver_0_0/Main_AD7983_driver_0_0.xml

Section (3.4) - REMOTE IP DEFINITIONS
-------------------------------------
List of all the remote IP's present in the archived project:-

<sources_1>
None

<Main_microblaze_0_3>
None

<Main_microblaze_0_axi_intc_3>
None

<Main_clk_wiz_0_2>
None

<Main_dlmb_v10_4>
None

<Main_ilmb_v10_4>
None

<Main_ilmb_bram_if_cntlr_4>
None

<Main_lmb_bram_4>
None

<Main_mdm_1_4>
None

<Main_rst_clk_wiz_0_100M_1>
None

<Main_axi_uartlite_0_2>
None

<Main_axi_iic_0_1>
None

<Main_util_vector_logic_0_1>
None

<Main_axi_bram_ctrl_0_bram_0>
None

<Main_sampling_controller_0_0>
None

<Main_AD7983_driver_0_0>
None

./Encoder_sampler.board/arty-s7-25

Section (4) - JOURNAL/LOG FILES
-------------------------------
List of Journal/Log files that were added to the archived project:-

Section (5) - CONFIGURATION SETTINGS/FILES
------------------------------------------
List of configuration settings/files that were added to the archived project:-
