JPirman/FPGA_polarimeter/Hardware/3D_printed_parts/Polarizer mount B.stl

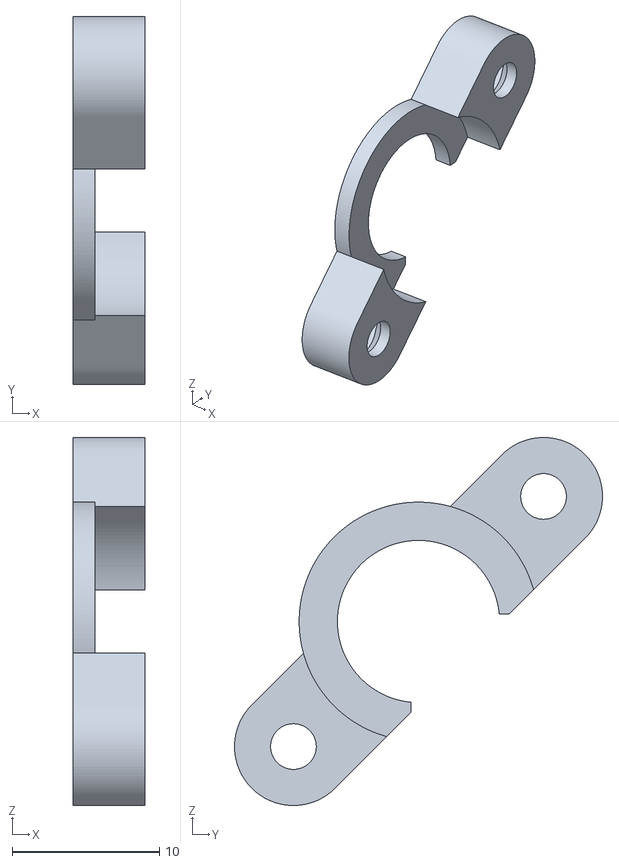
[picture p12: CAD file, 2022-07-17]
Hardware/3D_printed_parts/Polarizer mount B.stl
4.90 x 25.0 x 25.0
