JPirman/FPGA_polarimeter/Hardware/3D_printed_parts/Frame.stl

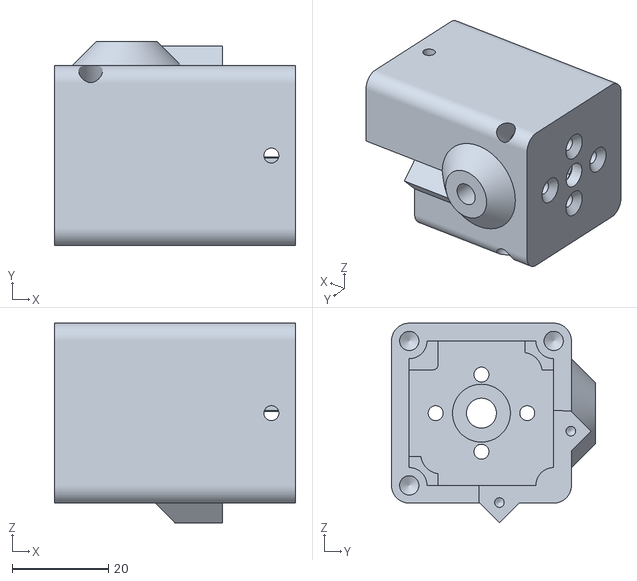
[picture p13: CAD file, 2022-07-17]
Hardware/3D_printed_parts/Frame.stl
50.0 x 42.3 x 41.4
