JPirman/FPGA_polarimeter/Hardware/3D_printed_parts/Encoder_Cover.stl

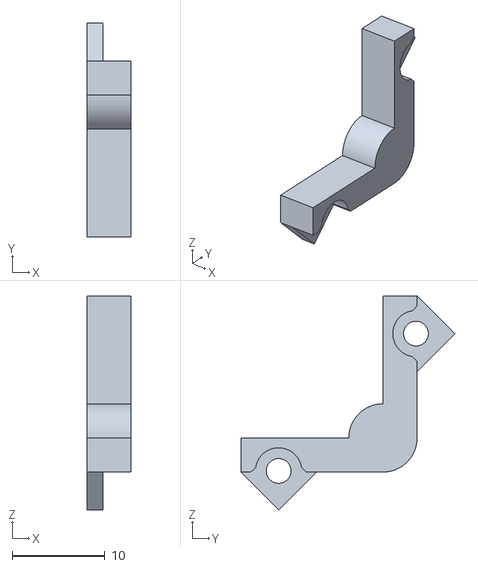
[picture p14: CAD file, 2022-07-17]
Hardware/3D_printed_parts/Encoder_Cover.stl
4.76 x 23.1 x 23.1
