JPirman/FPGA_polarimeter/Hardware/3D_printed_parts/Polarizer mount A.stl

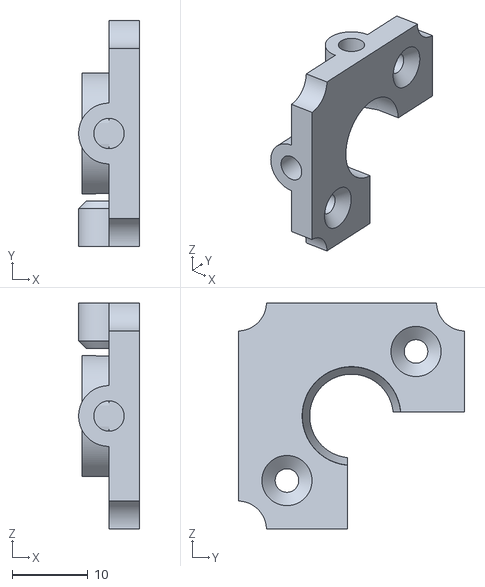
[picture p15: CAD file, 2022-07-17]
Hardware/3D_printed_parts/Polarizer mount A.stl
8.00 x 29.8 x 29.8
