JPirman/FPGA_polarimeter/Hardware/3D_printed_parts/QWP Mount.stl

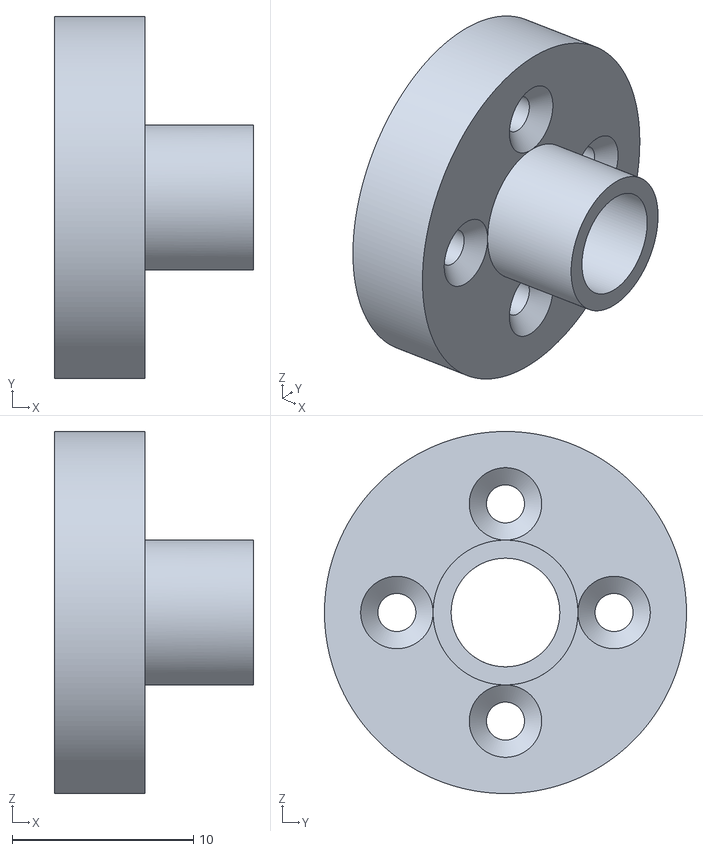
[picture p16: CAD file, 2022-07-17]
Hardware/3D_printed_parts/QWP Mount.stl
11.0 x 20.0 x 20.0
