JPirman/FPGA_polarimeter/doc/Main.pdf

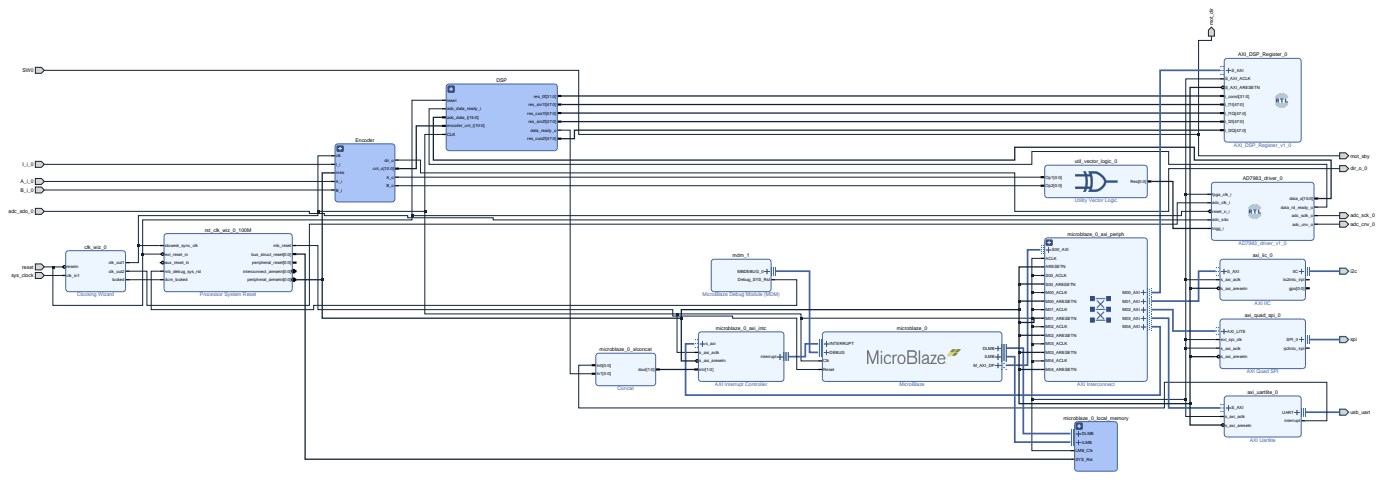
[picture p17: page 1]
AD7983_driver_0; AD7983_driver_v1_0; fpga_clk_i adc_clk_i; reset_n_i; data_o[15:0] data_rd_ready_o; adc_sdo; adc_sclk_o; adc_cnv_o; trigg_i; AXI_DSP_Register_0; AXI_DSP_Register_v1_0; S_AXI S_AXI_ACLK; S_AXI_ARESETN; i_const[31:0]; DSP; reset adc_data_ready_i adc_data_i[15:0] encoder_cnt_i[10:0] CLK; res_0f[31:0]; res_sin1f[47:0]; res_cos1f[47:0]; res_sin2f[47:0] data_ready_o Encoder; res_cos2f[47:0]; clk; dir_o; nres; cnt_o[10:0] A_o A_i; axi_iic_0; AXI IIC; S_AXI; IIC; s_axi_aclk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

Utility Vector Logic

Processor System Reset

MicroBlaze Debug Module (MDM)

AXI Quad SPI

AXI Interrupt Controller
