JPirman/FPGA_polarimeter/Encoder_sampling/Vivado/Encoder_sampler.gen/sources_1/bd/Main/synth/Main.v

//Copyright 1986-2022 Xilinx, Inc. All Rights Reserved.
//--------------------------------------------------------------------------------
//Tool Version: Vivado v.2022.1 (lin64) Build 3526262 Mon Apr 18 15:47:01 MDT 2022
//Date        : Fri Jul 15 23:37:31 2022
//Host        : Jure-Linux running 64-bit Linux Mint 20.3
//Command     : generate_target Main.bd
//Design      : Main
//Purpose     : IP block netlist
//--------------------------------------------------------------------------------
`timescale 1 ps / 1 ps

module Encoder_imp_13XH5OO
   (A_i,
    A_o,
    B_i,
    B_o,
    I_i,
    clk,
    cnt_o,
    dir_o_0,
    nres);
  input A_i;
  output A_o;
  input B_i;
  output B_o;
  input I_i;
  input clk;
  output [10:0]cnt_o;
  output dir_o_0;
  input nres;

  wire A_debouncer_signal_out;
  wire B_debouncer_signal_out;
  wire [10:0]Encoder_decoder_0_cnt_o;
  wire Encoder_decoder_0_dir_o;
  wire I_debouncer_signal_out;
  wire clk_0_1;
  wire nres_i_0_1;
  wire signal_in_0_1;
  wire signal_in_1_1;
  wire signal_in_2_1;

  assign A_o = B_debouncer_signal_out;
  assign B_o = I_debouncer_signal_out;
  assign clk_0_1 = clk;
  assign cnt_o[10:0] = Encoder_decoder_0_cnt_o;
  assign dir_o_0 = Encoder_decoder_0_dir_o;
  assign nres_i_0_1 = nres;
  assign signal_in_0_1 = A_i;
  assign signal_in_1_1 = B_i;
  assign signal_in_2_1 = I_i;
  Main_Input_debouncer_0_4 A_debouncer
       (.clk(clk_0_1),
        .signal_in(signal_in_0_1),
        .signal_out(A_debouncer_signal_out));
  /* Encoders can produce
noisy signals. Therefore
a debouncer should be
used */
  Main_Input_debouncer_1_0 B_debouncer
       (.clk(clk_0_1),
        .signal_in(signal_in_1_1),
        .signal_out(B_debouncer_signal_out));
  Main_Encoder_decoder_0_0 Encoder_decoder_0
       (.A_i(A_debouncer_signal_out),
        .B_i(B_debouncer_signal_out),
        .I_i(I_debouncer_signal_out),
        .clk_i(clk_0_1),
        .cnt_o(Encoder_decoder_0_cnt_o),
        .dir_o(Encoder_decoder_0_dir_o),
        .nres_i(nres_i_0_1));
  Main_Input_debouncer_2_0 I_debouncer
       (.clk(clk_0_1),
        .signal_in(signal_in_2_1),
        .signal_out(I_debouncer_signal_out));
endmodule

(* CORE_GENERATION_INFO = "Main,IP_Integrator,{x_ipVendor=xilinx.com,x_ipLibrary=BlockDiagram,x_ipName=Main,x_ipVersion=1.00.a,x_ipLanguage=VERILOG,numBlks=29,numReposBlks=27,numNonXlnxBlks=0,numHierBlks=2,maxHierDepth=1,numSysgenBlks=0,numHlsBlks=0,numHdlrefBlks=7,numPkgbdBlks=0,bdsource=USER,da_axi4_cnt=25,da_board_cnt=8,da_bram_cntlr_cnt=1,da_clkrst_cnt=3,da_mb_cnt=7,synth_mode=OOC_per_IP}" *) (* HW_HANDOFF = "Main.hwdef" *) 
module Main
   (A_i_0,
    BTN0,
    B_i_0,
    I_i_0,
    LD2,
    LD3,
    LD4,
    LD5,
    SW0,
    adc_cnv_0,
    adc_sck_0,
    adc_sdo_0,
    i2c_scl_i,
    i2c_scl_o,
    i2c_scl_t,
    i2c_sda_i,
    i2c_sda_o,
    i2c_sda_t,
    mot_sby,
    reset,
    sys_clock,
    usb_uart_rxd,
    usb_uart_txd);
  input A_i_0;
  input BTN0;
  input B_i_0;
  input I_i_0;
  output LD2;
  output LD3;
  output LD4;
  output LD5;
  input SW0;
  output adc_cnv_0;
  output adc_sck_0;
  /* adc_sdo_0 - JA pin 3
I_i_0 - JC pin 1
A_i_0 - JC pin 2
B_i_0 - JC pin 3 */
  input adc_sdo_0;
  (* X_INTERFACE_INFO = "xilinx.com:interface:iic:1.0 i2c SCL_I" *) input i2c_scl_i;
  (* X_INTERFACE_INFO = "xilinx.com:interface:iic:1.0 i2c SCL_O" *) output i2c_scl_o;
  (* X_INTERFACE_INFO = "xilinx.com:interface:iic:1.0 i2c SCL_T" *) output i2c_scl_t;
  (* X_INTERFACE_INFO = "xilinx.com:interface:iic:1.0 i2c SDA_I" *) input i2c_sda_i;
  (* X_INTERFACE_INFO = "xilinx.com:interface:iic:1.0 i2c SDA_O" *) output i2c_sda_o;
  (* X_INTERFACE_INFO = "xilinx.com:interface:iic:1.0 i2c SDA_T" *) output i2c_sda_t;
  /* adc_sck_0 - JA pin 4
adc_cnv_0 - JA pin 1
mot_sby -  IO9 */
  output mot_sby;
  (* X_INTERFACE_INFO = "xilinx.com:signal:reset:1.0 RST.RESET RST" *) (* X_INTERFACE_PARAMETER = "XIL_INTERFACENAME RST.RESET, INSERT_VIP 0, POLARITY ACTIVE_LOW" *) input reset;
  (* X_INTERFACE_INFO = "xilinx.com:signal:clock:1.0 CLK.SYS_CLOCK CLK" *) (* X_INTERFACE_PARAMETER = "XIL_INTERFACENAME CLK.SYS_CLOCK, CLK_DOMAIN Main_sys_clock, FREQ_HZ 12000000, FREQ_TOLERANCE_HZ 0, INSERT_VIP 0, PHASE 0.0" *) input sys_clock;
  (* X_INTERFACE_INFO = "xilinx.com:interface:uart:1.0 usb_uart RxD" *) input usb_uart_rxd;
  (* X_INTERFACE_INFO = "xilinx.com:interface:uart:1.0 usb_uart TxD" *) output usb_uart_txd;

  wire AD7983_driver_0_adc_cnv;
  wire AD7983_driver_0_adc_sck;
  wire [15:0]AD7983_driver_0_data_o;
  wire AD7983_driver_0_data_rd_ready_o;
  wire A_i_0_1;
  wire B_i_0_1;
  wire DSP_data_ready_o;
  wire [10:0]Encoder_cnt_o_0;
  wire Encoder_dir_o_0;
  wire Encoder_signal_out;
  wire Encoder_signal_out1;
  wire I_i_0_1;
  wire Input_debouncer_0_trigg_falling;
  wire SW0_1;
  wire adc_sdo_0_1;
  wire [12:0]axi_bram_ctrl_0_BRAM_PORTA_ADDR;
  wire axi_bram_ctrl_0_BRAM_PORTA_CLK;
  wire [31:0]axi_bram_ctrl_0_BRAM_PORTA_DIN;
  wire [31:0]axi_bram_ctrl_0_BRAM_PORTA_DOUT;
  wire axi_bram_ctrl_0_BRAM_PORTA_EN;
  wire axi_bram_ctrl_0_BRAM_PORTA_RST;
  wire [3:0]axi_bram_ctrl_0_BRAM_PORTA_WE;
  wire [31:0]axi_bram_ctrl_0_bram_doutb;
  wire axi_iic_0_IIC_SCL_I;
  wire axi_iic_0_IIC_SCL_O;
  wire axi_iic_0_IIC_SCL_T;
  wire axi_iic_0_IIC_SDA_I;
  wire axi_iic_0_IIC_SDA_O;
  wire axi_iic_0_IIC_SDA_T;
  wire [12:0]axi_smc_M00_AXI_ARADDR;
  wire [1:0]axi_smc_M00_AXI_ARBURST;
  wire [3:0]axi_smc_M00_AXI_ARCACHE;
  wire [7:0]axi_smc_M00_AXI_ARLEN;
  wire [0:0]axi_smc_M00_AXI_ARLOCK;
  wire [2:0]axi_smc_M00_AXI_ARPROT;
  wire axi_smc_M00_AXI_ARREADY;
  wire [2:0]axi_smc_M00_AXI_ARSIZE;
  wire axi_smc_M00_AXI_ARVALID;
  wire [12:0]axi_smc_M00_AXI_AWADDR;
  wire [1:0]axi_smc_M00_AXI_AWBURST;
  wire [3:0]axi_smc_M00_AXI_AWCACHE;
  wire [7:0]axi_smc_M00_AXI_AWLEN;
  wire [0:0]axi_smc_M00_AXI_AWLOCK;
  wire [2:0]axi_smc_M00_AXI_AWPROT;
  wire axi_smc_M00_AXI_AWREADY;
  wire [2:0]axi_smc_M00_AXI_AWSIZE;
  wire axi_smc_M00_AXI_AWVALID;
  wire axi_smc_M00_AXI_BREADY;
  wire [1:0]axi_smc_M00_AXI_BRESP;
  wire axi_smc_M00_AXI_BVALID;
  wire [31:0]axi_smc_M00_AXI_RDATA;
  wire axi_smc_M00_AXI_RLAST;
  wire axi_smc_M00_AXI_RREADY;
  wire [1:0]axi_smc_M00_AXI_RRESP;
  wire axi_smc_M00_AXI_RVALID;
  wire [31:0]axi_smc_M00_AXI_WDATA;
  wire axi_smc_M00_AXI_WLAST;
  wire axi_smc_M00_AXI_WREADY;
  wire [3:0]axi_smc_M00_AXI_WSTRB;
  wire axi_smc_M00_AXI_WVALID;
  wire [8:0]axi_smc_M01_AXI_ARADDR;
  wire axi_smc_M01_AXI_ARREADY;
  wire axi_smc_M01_AXI_ARVALID;
  wire [8:0]axi_smc_M01_AXI_AWADDR;
  wire axi_smc_M01_AXI_AWREADY;
  wire axi_smc_M01_AXI_AWVALID;
  wire axi_smc_M01_AXI_BREADY;
  wire [1:0]axi_smc_M01_AXI_BRESP;
  wire axi_smc_M01_AXI_BVALID;
  wire [31:0]axi_smc_M01_AXI_RDATA;
  wire axi_smc_M01_AXI_RREADY;
  wire [1:0]axi_smc_M01_AXI_RRESP;
  wire axi_smc_M01_AXI_RVALID;
  wire [31:0]axi_smc_M01_AXI_WDATA;
  wire axi_smc_M01_AXI_WREADY;
  wire [3:0]axi_smc_M01_AXI_WSTRB;
  wire axi_smc_M01_AXI_WVALID;
  wire [8:0]axi_smc_M02_AXI_ARADDR;
  wire axi_smc_M02_AXI_ARREADY;
  wire axi_smc_M02_AXI_ARVALID;
  wire [8:0]axi_smc_M02_AXI_AWADDR;
  wire axi_smc_M02_AXI_AWREADY;
  wire axi_smc_M02_AXI_AWVALID;
  wire axi_smc_M02_AXI_BREADY;
  wire [1:0]axi_smc_M02_AXI_BRESP;
  wire axi_smc_M02_AXI_BVALID;
  wire [31:0]axi_smc_M02_AXI_RDATA;
  wire axi_smc_M02_AXI_RREADY;
  wire [1:0]axi_smc_M02_AXI_RRESP;
  wire axi_smc_M02_AXI_RVALID;
  wire [31:0]axi_smc_M02_AXI_WDATA;
  wire axi_smc_M02_AXI_WREADY;
  wire [3:0]axi_smc_M02_AXI_WSTRB;
  wire axi_smc_M02_AXI_WVALID;
  wire [3:0]axi_smc_M03_AXI_ARADDR;
  wire axi_smc_M03_AXI_ARREADY;
  wire axi_smc_M03_AXI_ARVALID;
  wire [3:0]axi_smc_M03_AXI_AWADDR;
  wire axi_smc_M03_AXI_AWREADY;
  wire axi_smc_M03_AXI_AWVALID;
  wire axi_smc_M03_AXI_BREADY;
  wire [1:0]axi_smc_M03_AXI_BRESP;
  wire axi_smc_M03_AXI_BVALID;
  wire [31:0]axi_smc_M03_AXI_RDATA;
  wire axi_smc_M03_AXI_RREADY;
  wire [1:0]axi_smc_M03_AXI_RRESP;
  wire axi_smc_M03_AXI_RVALID;
  wire [31:0]axi_smc_M03_AXI_WDATA;
  wire axi_smc_M03_AXI_WREADY;
  wire [3:0]axi_smc_M03_AXI_WSTRB;
  wire axi_smc_M03_AXI_WVALID;
  wire [8:0]axi_smc_M04_AXI_ARADDR;
  wire axi_smc_M04_AXI_ARREADY;
  wire axi_smc_M04_AXI_ARVALID;
  wire [8:0]axi_smc_M04_AXI_AWADDR;
  wire axi_smc_M04_AXI_AWREADY;
  wire axi_smc_M04_AXI_AWVALID;
  wire axi_smc_M04_AXI_BREADY;
  wire [1:0]axi_smc_M04_AXI_BRESP;
  wire axi_smc_M04_AXI_BVALID;
  wire [31:0]axi_smc_M04_AXI_RDATA;
  wire axi_smc_M04_AXI_RREADY;
  wire [1:0]axi_smc_M04_AXI_RRESP;
  wire axi_smc_M04_AXI_RVALID;
  wire [31:0]axi_smc_M04_AXI_WDATA;
  wire axi_smc_M04_AXI_WREADY;
  wire [3:0]axi_smc_M04_AXI_WSTRB;
  wire axi_smc_M04_AXI_WVALID;
  wire axi_uartlite_0_UART_RxD;
  wire axi_uartlite_0_UART_TxD;
  wire axi_uartlite_0_interrupt;
  wire clk_wiz_0_clk_out2;
  wire clk_wiz_0_locked;
  wire mdm_1_debug_sys_rst;
  wire microblaze_0_Clk;
  wire [31:0]microblaze_0_M_AXI_DP_ARADDR;
  wire [2:0]microblaze_0_M_AXI_DP_ARPROT;
  wire microblaze_0_M_AXI_DP_ARREADY;
  wire microblaze_0_M_AXI_DP_ARVALID;
  wire [31:0]microblaze_0_M_AXI_DP_AWADDR;
  wire [2:0]microblaze_0_M_AXI_DP_AWPROT;
  wire microblaze_0_M_AXI_DP_AWREADY;
  wire microblaze_0_M_AXI_DP_AWVALID;
  wire microblaze_0_M_AXI_DP_BREADY;
  wire [1:0]microblaze_0_M_AXI_DP_BRESP;
  wire microblaze_0_M_AXI_DP_BVALID;
  wire [31:0]microblaze_0_M_AXI_DP_RDATA;
  wire microblaze_0_M_AXI_DP_RREADY;
  wire [1:0]microblaze_0_M_AXI_DP_RRESP;
  wire microblaze_0_M_AXI_DP_RVALID;
  wire [31:0]microblaze_0_M_AXI_DP_WDATA;
  wire microblaze_0_M_AXI_DP_WREADY;
  wire [3:0]microblaze_0_M_AXI_DP_WSTRB;
  wire microblaze_0_M_AXI_DP_WVALID;
  wire microblaze_0_axi_intc_interrupt_INTERRUPT;
  wire microblaze_0_debug_CAPTURE;
  wire microblaze_0_debug_CLK;
  wire microblaze_0_debug_DISABLE;
  wire [0:7]microblaze_0_debug_REG_EN;
  wire microblaze_0_debug_RST;
  wire microblaze_0_debug_SHIFT;
  wire microblaze_0_debug_TDI;
  wire microblaze_0_debug_TDO;
  wire microblaze_0_debug_UPDATE;
  wire [0:31]microblaze_0_dlmb_1_ABUS;
  wire microblaze_0_dlmb_1_ADDRSTROBE;
  wire [0:3]microblaze_0_dlmb_1_BE;
  wire microblaze_0_dlmb_1_CE;
  wire [0:31]microblaze_0_dlmb_1_READDBUS;
  wire microblaze_0_dlmb_1_READSTROBE;
  wire microblaze_0_dlmb_1_READY;
  wire microblaze_0_dlmb_1_UE;
  wire microblaze_0_dlmb_1_WAIT;
  wire [0:31]microblaze_0_dlmb_1_WRITEDBUS;
  wire microblaze_0_dlmb_1_WRITESTROBE;
  wire [0:31]microblaze_0_ilmb_1_ABUS;
  wire microblaze_0_ilmb_1_ADDRSTROBE;
  wire microblaze_0_ilmb_1_CE;
  wire [0:31]microblaze_0_ilmb_1_READDBUS;
  wire microblaze_0_ilmb_1_READSTROBE;
  wire microblaze_0_ilmb_1_READY;
  wire microblaze_0_ilmb_1_UE;
  wire microblaze_0_ilmb_1_WAIT;
  wire [1:0]microblaze_0_intr;
  wire reset_1;
  wire [0:0]rst_clk_wiz_0_100M_bus_struct_reset;
  wire rst_clk_wiz_0_100M_mb_reset;
  wire [0:0]rst_clk_wiz_0_100M_peripheral_aresetn;
  wire [31:0]sampling_controller_0_bram_addr;
  wire sampling_controller_0_bram_clk;
  wire sampling_controller_0_bram_en;
  wire [3:0]sampling_controller_0_bram_we;
  wire [31:0]sampling_controller_0_bram_wrdata;
  wire sampling_controller_0_idle_o;
  wire signal_in_0_1;
  wire sys_clock_1;
  wire [0:0]util_vector_logic_0_Res;
  wire [1:0]xlconcat_0_dout;
  wire [15:0]xlconstant_0_dout;

  assign A_i_0_1 = A_i_0;
  assign B_i_0_1 = B_i_0;
  assign I_i_0_1 = I_i_0;
  assign LD2 = SW0_1;
  assign LD3 = Encoder_dir_o_0;
  assign LD4 = DSP_data_ready_o;
  assign LD5 = sampling_controller_0_idle_o;
  assign SW0_1 = SW0;
  assign adc_cnv_0 = AD7983_driver_0_adc_cnv;
  assign adc_sck_0 = AD7983_driver_0_adc_sck;
  assign adc_sdo_0_1 = adc_sdo_0;
  assign axi_iic_0_IIC_SCL_I = i2c_scl_i;
  assign axi_iic_0_IIC_SDA_I = i2c_sda_i;
  assign axi_uartlite_0_UART_RxD = usb_uart_rxd;
  assign i2c_scl_o = axi_iic_0_IIC_SCL_O;
  assign i2c_scl_t = axi_iic_0_IIC_SCL_T;
  assign i2c_sda_o = axi_iic_0_IIC_SDA_O;
  assign i2c_sda_t = axi_iic_0_IIC_SDA_T;
  assign mot_sby = SW0_1;
  assign reset_1 = reset;
  assign signal_in_0_1 = BTN0;
  assign sys_clock_1 = sys_clock;
  assign usb_uart_txd = axi_uartlite_0_UART_TxD;
  Main_AD7983_driver_0_0 AD7983_driver_0
       (.adc_clk_i(clk_wiz_0_clk_out2),
        .adc_cnv_o(AD7983_driver_0_adc_cnv),
        .adc_sclk_o(AD7983_driver_0_adc_sck),
        .adc_sdo(adc_sdo_0_1),
        .data_o(AD7983_driver_0_data_o),
        .data_rd_ready_o(AD7983_driver_0_data_rd_ready_o),
        .fpga_clk_i(microblaze_0_Clk),
        .reset_n_i(rst_clk_wiz_0_100M_peripheral_aresetn),
        .trigg_i(util_vector_logic_0_Res));
  Encoder_imp_13XH5OO Encoder
       (.A_i(A_i_0_1),
        .A_o(Encoder_signal_out),
        .B_i(B_i_0_1),
        .B_o(Encoder_signal_out1),
        .I_i(I_i_0_1),
        .clk(microblaze_0_Clk),
        .cnt_o(Encoder_cnt_o_0),
        .dir_o_0(Encoder_dir_o_0),
        .nres(rst_clk_wiz_0_100M_peripheral_aresetn));
  /* We can use the debouncer to
output a pulse when a button is
pressed/released. This is then used
as a start signal for the sampling 
controller. This way we can prevent 
the core from continously
running when the button is held */
  Main_Input_debouncer_0_3 Input_debouncer_0
       (.clk(microblaze_0_Clk),
        .signal_in(signal_in_0_1),
        .trigg_falling(Input_debouncer_0_trigg_falling));
  (* BMM_INFO_ADDRESS_SPACE = "byte  0xC0000000 32 > Main axi_bram_ctrl_0_bram" *) 
  (* KEEP_HIERARCHY = "yes" *) 
  Main_axi_bram_ctrl_0_1 axi_bram_ctrl_0
       (.bram_addr_a(axi_bram_ctrl_0_BRAM_PORTA_ADDR),
        .bram_clk_a(axi_bram_ctrl_0_BRAM_PORTA_CLK),
        .bram_en_a(axi_bram_ctrl_0_BRAM_PORTA_EN),
        .bram_rddata_a(axi_bram_ctrl_0_BRAM_PORTA_DOUT),
        .bram_rst_a(axi_bram_ctrl_0_BRAM_PORTA_RST),
        .bram_we_a(axi_bram_ctrl_0_BRAM_PORTA_WE),
        .bram_wrdata_a(axi_bram_ctrl_0_BRAM_PORTA_DIN),
        .s_axi_aclk(microblaze_0_Clk),
        .s_axi_araddr(axi_smc_M00_AXI_ARADDR),
        .s_axi_arburst(axi_smc_M00_AXI_ARBURST),
        .s_axi_arcache(axi_smc_M00_AXI_ARCACHE),
        .s_axi_aresetn(rst_clk_wiz_0_100M_peripheral_aresetn),
        .s_axi_arlen(axi_smc_M00_AXI_ARLEN),
        .s_axi_arlock(axi_smc_M00_AXI_ARLOCK),
        .s_axi_arprot(axi_smc_M00_AXI_ARPROT),
        .s_axi_arready(axi_smc_M00_AXI_ARREADY),
        .s_axi_arsize(axi_smc_M00_AXI_ARSIZE),
        .s_axi_arvalid(axi_smc_M00_AXI_ARVALID),
        .s_axi_awaddr(axi_smc_M00_AXI_AWADDR),
        .s_axi_awburst(axi_smc_M00_AXI_AWBURST),
        .s_axi_awcache(axi_smc_M00_AXI_AWCACHE),
        .s_axi_awlen(axi_smc_M00_AXI_AWLEN),
        .s_axi_awlock(axi_smc_M00_AXI_AWLOCK),
        .s_axi_awprot(axi_smc_M00_AXI_AWPROT),
        .s_axi_awready(axi_smc_M00_AXI_AWREADY),
        .s_axi_awsize(axi_smc_M00_AXI_AWSIZE),
        .s_axi_awvalid(axi_smc_M00_AXI_AWVALID),
        .s_axi_bready(axi_smc_M00_AXI_BREADY),
        .s_axi_bresp(axi_smc_M00_AXI_BRESP),
        .s_axi_bvalid(axi_smc_M00_AXI_BVALID),
        .s_axi_rdata(axi_smc_M00_AXI_RDATA),
        .s_axi_rlast(axi_smc_M00_AXI_RLAST),
        .s_axi_rready(axi_smc_M00_AXI_RREADY),
        .s_axi_rresp(axi_smc_M00_AXI_RRESP),
        .s_axi_rvalid(axi_smc_M00_AXI_RVALID),
        .s_axi_wdata(axi_smc_M00_AXI_WDATA),
        .s_axi_wlast(axi_smc_M00_AXI_WLAST),
        .s_axi_wready(axi_smc_M00_AXI_WREADY),
        .s_axi_wstrb(axi_smc_M00_AXI_WSTRB),
        .s_axi_wvalid(axi_smc_M00_AXI_WVALID));
  Main_axi_bram_ctrl_0_bram_0 axi_bram_ctrl_0_bram
       (.addra({1'b0,1'b0,1'b0,1'b0,1'b0,1'b0,1'b0,1'b0,1'b0,1'b0,1'b0,1'b0,1'b0,1'b0,1'b0,1'b0,1'b0,1'b0,1'b0,axi_bram_ctrl_0_BRAM_PORTA_ADDR}),
        .addrb(sampling_controller_0_bram_addr),
        .clka(axi_bram_ctrl_0_BRAM_PORTA_CLK),
        .clkb(sampling_controller_0_bram_clk),
        .dina(axi_bram_ctrl_0_BRAM_PORTA_DIN),
        .dinb(sampling_controller_0_bram_wrdata),
        .douta(axi_bram_ctrl_0_BRAM_PORTA_DOUT),
        .doutb(axi_bram_ctrl_0_bram_doutb),
        .ena(axi_bram_ctrl_0_BRAM_PORTA_EN),
        .enb(sampling_controller_0_bram_en),
        .rsta(axi_bram_ctrl_0_BRAM_PORTA_RST),
        .rstb(1'b0),
        .wea(axi_bram_ctrl_0_BRAM_PORTA_WE),
        .web(sampling_controller_0_bram_we));
  Main_axi_gpio_0_1 axi_gpio_0
       (.gpio_io_i(xlconcat_0_dout),
        .s_axi_aclk(microblaze_0_Clk),
        .s_axi_araddr(axi_smc_M01_AXI_ARADDR),
        .s_axi_aresetn(rst_clk_wiz_0_100M_peripheral_aresetn),
        .s_axi_arready(axi_smc_M01_AXI_ARREADY),
        .s_axi_arvalid(axi_smc_M01_AXI_ARVALID),
        .s_axi_awaddr(axi_smc_M01_AXI_AWADDR),
        .s_axi_awready(axi_smc_M01_AXI_AWREADY),
        .s_axi_awvalid(axi_smc_M01_AXI_AWVALID),
        .s_axi_bready(axi_smc_M01_AXI_BREADY),
        .s_axi_bresp(axi_smc_M01_AXI_BRESP),
        .s_axi_bvalid(axi_smc_M01_AXI_BVALID),
        .s_axi_rdata(axi_smc_M01_AXI_RDATA),
        .s_axi_rready(axi_smc_M01_AXI_RREADY),
        .s_axi_rresp(axi_smc_M01_AXI_RRESP),
        .s_axi_rvalid(axi_smc_M01_AXI_RVALID),
        .s_axi_wdata(axi_smc_M01_AXI_WDATA),
        .s_axi_wready(axi_smc_M01_AXI_WREADY),
        .s_axi_wstrb(axi_smc_M01_AXI_WSTRB),
        .s_axi_wvalid(axi_smc_M01_AXI_WVALID));
  Main_axi_iic_0_1 axi_iic_0
       (.s_axi_aclk(microblaze_0_Clk),
        .s_axi_araddr(axi_smc_M02_AXI_ARADDR),
        .s_axi_aresetn(rst_clk_wiz_0_100M_peripheral_aresetn),
        .s_axi_arready(axi_smc_M02_AXI_ARREADY),
        .s_axi_arvalid(axi_smc_M02_AXI_ARVALID),
        .s_axi_awaddr(axi_smc_M02_AXI_AWADDR),
        .s_axi_awready(axi_smc_M02_AXI_AWREADY),
        .s_axi_awvalid(axi_smc_M02_AXI_AWVALID),
        .s_axi_bready(axi_smc_M02_AXI_BREADY),
        .s_axi_bresp(axi_smc_M02_AXI_BRESP),
        .s_axi_bvalid(axi_smc_M02_AXI_BVALID),
        .s_axi_rdata(axi_smc_M02_AXI_RDATA),
        .s_axi_rready(axi_smc_M02_AXI_RREADY),
        .s_axi_rresp(axi_smc_M02_AXI_RRESP),
        .s_axi_rvalid(axi_smc_M02_AXI_RVALID),
        .s_axi_wdata(axi_smc_M02_AXI_WDATA),
        .s_axi_wready(axi_smc_M02_AXI_WREADY),
        .s_axi_wstrb(axi_smc_M02_AXI_WSTRB),
        .s_axi_wvalid(axi_smc_M02_AXI_WVALID),
        .scl_i(axi_iic_0_IIC_SCL_I),
        .scl_o(axi_iic_0_IIC_SCL_O),
        .scl_t(axi_iic_0_IIC_SCL_T),
        .sda_i(axi_iic_0_IIC_SDA_I),
        .sda_o(axi_iic_0_IIC_SDA_O),
        .sda_t(axi_iic_0_IIC_SDA_T));
  Main_axi_smc_0 axi_smc
       (.M00_AXI_araddr(axi_smc_M00_AXI_ARADDR),
        .M00_AXI_arburst(axi_smc_M00_AXI_ARBURST),
        .M00_AXI_arcache(axi_smc_M00_AXI_ARCACHE),
        .M00_AXI_arlen(axi_smc_M00_AXI_ARLEN),
        .M00_AXI_arlock(axi_smc_M00_AXI_ARLOCK),
        .M00_AXI_arprot(axi_smc_M00_AXI_ARPROT),
        .M00_AXI_arready(axi_smc_M00_AXI_ARREADY),
        .M00_AXI_arsize(axi_smc_M00_AXI_ARSIZE),
        .M00_AXI_arvalid(axi_smc_M00_AXI_ARVALID),
        .M00_AXI_awaddr(axi_smc_M00_AXI_AWADDR),
        .M00_AXI_awburst(axi_smc_M00_AXI_AWBURST),
        .M00_AXI_awcache(axi_smc_M00_AXI_AWCACHE),
        .M00_AXI_awlen(axi_smc_M00_AXI_AWLEN),
        .M00_AXI_awlock(axi_smc_M00_AXI_AWLOCK),
        .M00_AXI_awprot(axi_smc_M00_AXI_AWPROT),
        .M00_AXI_awready(axi_smc_M00_AXI_AWREADY),
        .M00_AXI_awsize(axi_smc_M00_AXI_AWSIZE),
        .M00_AXI_awvalid(axi_smc_M00_AXI_AWVALID),
        .M00_AXI_bready(axi_smc_M00_AXI_BREADY),
        .M00_AXI_bresp(axi_smc_M00_AXI_BRESP),
        .M00_AXI_bvalid(axi_smc_M00_AXI_BVALID),
        .M00_AXI_rdata(axi_smc_M00_AXI_RDATA),
        .M00_AXI_rlast(axi_smc_M00_AXI_RLAST),
        .M00_AXI_rready(axi_smc_M00_AXI_RREADY),
        .M00_AXI_rresp(axi_smc_M00_AXI_RRESP),
        .M00_AXI_rvalid(axi_smc_M00_AXI_RVALID),
        .M00_AXI_wdata(axi_smc_M00_AXI_WDATA),
        .M00_AXI_wlast(axi_smc_M00_AXI_WLAST),
        .M00_AXI_wready(axi_smc_M00_AXI_WREADY),
        .M00_AXI_wstrb(axi_smc_M00_AXI_WSTRB),
        .M00_AXI_wvalid(axi_smc_M00_AXI_WVALID),
        .M01_AXI_araddr(axi_smc_M01_AXI_ARADDR),
        .M01_AXI_arready(axi_smc_M01_AXI_ARREADY),
        .M01_AXI_arvalid(axi_smc_M01_AXI_ARVALID),
        .M01_AXI_awaddr(axi_smc_M01_AXI_AWADDR),
        .M01_AXI_awready(axi_smc_M01_AXI_AWREADY),
        .M01_AXI_awvalid(axi_smc_M01_AXI_AWVALID),
        .M01_AXI_bready(axi_smc_M01_AXI_BREADY),
        .M01_AXI_bresp(axi_smc_M01_AXI_BRESP),
        .M01_AXI_bvalid(axi_smc_M01_AXI_BVALID),
        .M01_AXI_rdata(axi_smc_M01_AXI_RDATA),
        .M01_AXI_rready(axi_smc_M01_AXI_RREADY),
        .M01_AXI_rresp(axi_smc_M01_AXI_RRESP),
        .M01_AXI_rvalid(axi_smc_M01_AXI_RVALID),
        .M01_AXI_wdata(axi_smc_M01_AXI_WDATA),
        .M01_AXI_wready(axi_smc_M01_AXI_WREADY),
        .M01_AXI_wstrb(axi_smc_M01_AXI_WSTRB),
        .M01_AXI_wvalid(axi_smc_M01_AXI_WVALID),
        .M02_AXI_araddr(axi_smc_M02_AXI_ARADDR),
        .M02_AXI_arready(axi_smc_M02_AXI_ARREADY),
        .M02_AXI_arvalid(axi_smc_M02_AXI_ARVALID),
        .M02_AXI_awaddr(axi_smc_M02_AXI_AWADDR),
        .M02_AXI_awready(axi_smc_M02_AXI_AWREADY),
        .M02_AXI_awvalid(axi_smc_M02_AXI_AWVALID),
        .M02_AXI_bready(axi_smc_M02_AXI_BREADY),
        .M02_AXI_bresp(axi_smc_M02_AXI_BRESP),
        .M02_AXI_bvalid(axi_smc_M02_AXI_BVALID),
        .M02_AXI_rdata(axi_smc_M02_AXI_RDATA),
        .M02_AXI_rready(axi_smc_M02_AXI_RREADY),
        .M02_AXI_rresp(axi_smc_M02_AXI_RRESP),
        .M02_AXI_rvalid(axi_smc_M02_AXI_RVALID),
        .M02_AXI_wdata(axi_smc_M02_AXI_WDATA),
        .M02_AXI_wready(axi_smc_M02_AXI_WREADY),
        .M02_AXI_wstrb(axi_smc_M02_AXI_WSTRB),
        .M02_AXI_wvalid(axi_smc_M02_AXI_WVALID),
        .M03_AXI_araddr(axi_smc_M03_AXI_ARADDR),
        .M03_AXI_arready(axi_smc_M03_AXI_ARREADY),
        .M03_AXI_arvalid(axi_smc_M03_AXI_ARVALID),
        .M03_AXI_awaddr(axi_smc_M03_AXI_AWADDR),
        .M03_AXI_awready(axi_smc_M03_AXI_AWREADY),
        .M03_AXI_awvalid(axi_smc_M03_AXI_AWVALID),
        .M03_AXI_bready(axi_smc_M03_AXI_BREADY),
        .M03_AXI_bresp(axi_smc_M03_AXI_BRESP),
        .M03_AXI_bvalid(axi_smc_M03_AXI_BVALID),
        .M03_AXI_rdata(axi_smc_M03_AXI_RDATA),
        .M03_AXI_rready(axi_smc_M03_AXI_RREADY),
        .M03_AXI_rresp(axi_smc_M03_AXI_RRESP),
        .M03_AXI_rvalid(axi_smc_M03_AXI_RVALID),
        .M03_AXI_wdata(axi_smc_M03_AXI_WDATA),
        .M03_AXI_wready(axi_smc_M03_AXI_WREADY),
        .M03_AXI_wstrb(axi_smc_M03_AXI_WSTRB),
        .M03_AXI_wvalid(axi_smc_M03_AXI_WVALID),
        .M04_AXI_araddr(axi_smc_M04_AXI_ARADDR),
        .M04_AXI_arready(axi_smc_M04_AXI_ARREADY),
        .M04_AXI_arvalid(axi_smc_M04_AXI_ARVALID),
        .M04_AXI_awaddr(axi_smc_M04_AXI_AWADDR),
        .M04_AXI_awready(axi_smc_M04_AXI_AWREADY),
        .M04_AXI_awvalid(axi_smc_M04_AXI_AWVALID),
        .M04_AXI_bready(axi_smc_M04_AXI_BREADY),
        .M04_AXI_bresp(axi_smc_M04_AXI_BRESP),
        .M04_AXI_bvalid(axi_smc_M04_AXI_BVALID),
        .M04_AXI_rdata(axi_smc_M04_AXI_RDATA),
        .M04_AXI_rready(axi_smc_M04_AXI_RREADY),
        .M04_AXI_rresp(axi_smc_M04_AXI_RRESP),
        .M04_AXI_rvalid(axi_smc_M04_AXI_RVALID),
        .M04_AXI_wdata(axi_smc_M04_AXI_WDATA),
        .M04_AXI_wready(axi_smc_M04_AXI_WREADY),
        .M04_AXI_wstrb(axi_smc_M04_AXI_WSTRB),
        .M04_AXI_wvalid(axi_smc_M04_AXI_WVALID),
        .S00_AXI_araddr(microblaze_0_M_AXI_DP_ARADDR),
        .S00_AXI_arprot(microblaze_0_M_AXI_DP_ARPROT),
        .S00_AXI_arready(microblaze_0_M_AXI_DP_ARREADY),
        .S00_AXI_arvalid(microblaze_0_M_AXI_DP_ARVALID),
        .S00_AXI_awaddr(microblaze_0_M_AXI_DP_AWADDR),
        .S00_AXI_awprot(microblaze_0_M_AXI_DP_AWPROT),
        .S00_AXI_awready(microblaze_0_M_AXI_DP_AWREADY),
        .S00_AXI_awvalid(microblaze_0_M_AXI_DP_AWVALID),
        .S00_AXI_bready(microblaze_0_M_AXI_DP_BREADY),
        .S00_AXI_bresp(microblaze_0_M_AXI_DP_BRESP),
        .S00_AXI_bvalid(microblaze_0_M_AXI_DP_BVALID),
        .S00_AXI_rdata(microblaze_0_M_AXI_DP_RDATA),
        .S00_AXI_rready(microblaze_0_M_AXI_DP_RREADY),
        .S00_AXI_rresp(microblaze_0_M_AXI_DP_RRESP),
        .S00_AXI_rvalid(microblaze_0_M_AXI_DP_RVALID),
        .S00_AXI_wdata(microblaze_0_M_AXI_DP_WDATA),
        .S00_AXI_wready(microblaze_0_M_AXI_DP_WREADY),
        .S00_AXI_wstrb(microblaze_0_M_AXI_DP_WSTRB),
        .S00_AXI_wvalid(microblaze_0_M_AXI_DP_WVALID),
        .aclk(microblaze_0_Clk),
        .aresetn(rst_clk_wiz_0_100M_peripheral_aresetn));
  Main_axi_uartlite_0_2 axi_uartlite_0
       (.interrupt(axi_uartlite_0_interrupt),
        .rx(axi_uartlite_0_UART_RxD),
        .s_axi_aclk(microblaze_0_Clk),
        .s_axi_araddr(axi_smc_M03_AXI_ARADDR),
        .s_axi_aresetn(rst_clk_wiz_0_100M_peripheral_aresetn),
        .s_axi_arready(axi_smc_M03_AXI_ARREADY),
        .s_axi_arvalid(axi_smc_M03_AXI_ARVALID),
        .s_axi_awaddr(axi_smc_M03_AXI_AWADDR),
        .s_axi_awready(axi_smc_M03_AXI_AWREADY),
        .s_axi_awvalid(axi_smc_M03_AXI_AWVALID),
        .s_axi_bready(axi_smc_M03_AXI_BREADY),
        .s_axi_bresp(axi_smc_M03_AXI_BRESP),
        .s_axi_bvalid(axi_smc_M03_AXI_BVALID),
        .s_axi_rdata(axi_smc_M03_AXI_RDATA),
        .s_axi_rready(axi_smc_M03_AXI_RREADY),
        .s_axi_rresp(axi_smc_M03_AXI_RRESP),
        .s_axi_rvalid(axi_smc_M03_AXI_RVALID),
        .s_axi_wdata(axi_smc_M03_AXI_WDATA),
        .s_axi_wready(axi_smc_M03_AXI_WREADY),
        .s_axi_wstrb(axi_smc_M03_AXI_WSTRB),
        .s_axi_wvalid(axi_smc_M03_AXI_WVALID),
        .tx(axi_uartlite_0_UART_TxD));
  Main_clk_wiz_0_2 clk_wiz_0
       (.clk_in1(sys_clock_1),
        .clk_out1(microblaze_0_Clk),
        .clk_out2(clk_wiz_0_clk_out2),
        .locked(clk_wiz_0_locked),
        .resetn(reset_1));
  Main_mdm_1_4 mdm_1
       (.Dbg_Capture_0(microblaze_0_debug_CAPTURE),
        .Dbg_Clk_0(microblaze_0_debug_CLK),
        .Dbg_Disable_0(microblaze_0_debug_DISABLE),
        .Dbg_Reg_En_0(microblaze_0_debug_REG_EN),
        .Dbg_Rst_0(microblaze_0_debug_RST),
        .Dbg_Shift_0(microblaze_0_debug_SHIFT),
        .Dbg_TDI_0(microblaze_0_debug_TDI),
        .Dbg_TDO_0(microblaze_0_debug_TDO),
        .Dbg_Update_0(microblaze_0_debug_UPDATE),
        .Debug_SYS_Rst(mdm_1_debug_sys_rst));
  (* BMM_INFO_PROCESSOR = "microblaze-le > Main microblaze_0_local_memory/dlmb_bram_if_cntlr Main axi_bram_ctrl_0" *) 
  (* KEEP_HIERARCHY = "yes" *) 
  Main_microblaze_0_3 microblaze_0
       (.Byte_Enable(microblaze_0_dlmb_1_BE),
        .Clk(microblaze_0_Clk),
        .DCE(microblaze_0_dlmb_1_CE),
        .DReady(microblaze_0_dlmb_1_READY),
        .DUE(microblaze_0_dlmb_1_UE),
        .DWait(microblaze_0_dlmb_1_WAIT),
        .D_AS(microblaze_0_dlmb_1_ADDRSTROBE),
        .Data_Addr(microblaze_0_dlmb_1_ABUS),
        .Data_Read(microblaze_0_dlmb_1_READDBUS),
        .Data_Write(microblaze_0_dlmb_1_WRITEDBUS),
        .Dbg_Capture(microblaze_0_debug_CAPTURE),
        .Dbg_Clk(microblaze_0_debug_CLK),
        .Dbg_Disable(microblaze_0_debug_DISABLE),
        .Dbg_Reg_En(microblaze_0_debug_REG_EN),
        .Dbg_Shift(microblaze_0_debug_SHIFT),
        .Dbg_TDI(microblaze_0_debug_TDI),
        .Dbg_TDO(microblaze_0_debug_TDO),
        .Dbg_Update(microblaze_0_debug_UPDATE),
        .Debug_Rst(microblaze_0_debug_RST),
        .ICE(microblaze_0_ilmb_1_CE),
        .IFetch(microblaze_0_ilmb_1_READSTROBE),
        .IReady(microblaze_0_ilmb_1_READY),
        .IUE(microblaze_0_ilmb_1_UE),
        .IWAIT(microblaze_0_ilmb_1_WAIT),
        .I_AS(microblaze_0_ilmb_1_ADDRSTROBE),
        .Instr(microblaze_0_ilmb_1_READDBUS),
        .Instr_Addr(microblaze_0_ilmb_1_ABUS),
        .Interrupt(microblaze_0_axi_intc_interrupt_INTERRUPT),
        .Interrupt_Address({1'b0,1'b0,1'b0,1'b0,1'b0,1'b0,1'b0,1'b0,1'b0,1'b0,1'b0,1'b0,1'b0,1'b0,1'b0,1'b0,1'b0,1'b0,1'b0,1'b0,1'b0,1'b0,1'b0,1'b0,1'b0,1'b0,1'b0,1'b0,1'b0,1'b0,1'b0,1'b0}),
        .M_AXI_DP_ARADDR(microblaze_0_M_AXI_DP_ARADDR),
        .M_AXI_DP_ARPROT(microblaze_0_M_AXI_DP_ARPROT),
        .M_AXI_DP_ARREADY(microblaze_0_M_AXI_DP_ARREADY),
        .M_AXI_DP_ARVALID(microblaze_0_M_AXI_DP_ARVALID),
        .M_AXI_DP_AWADDR(microblaze_0_M_AXI_DP_AWADDR),
        .M_AXI_DP_AWPROT(microblaze_0_M_AXI_DP_AWPROT),
        .M_AXI_DP_AWREADY(microblaze_0_M_AXI_DP_AWREADY),
        .M_AXI_DP_AWVALID(microblaze_0_M_AXI_DP_AWVALID),
        .M_AXI_DP_BREADY(microblaze_0_M_AXI_DP_BREADY),
        .M_AXI_DP_BRESP(microblaze_0_M_AXI_DP_BRESP),
        .M_AXI_DP_BVALID(microblaze_0_M_AXI_DP_BVALID),
        .M_AXI_DP_RDATA(microblaze_0_M_AXI_DP_RDATA),
        .M_AXI_DP_RREADY(microblaze_0_M_AXI_DP_RREADY),
        .M_AXI_DP_RRESP(microblaze_0_M_AXI_DP_RRESP),
        .M_AXI_DP_RVALID(microblaze_0_M_AXI_DP_RVALID),
        .M_AXI_DP_WDATA(microblaze_0_M_AXI_DP_WDATA),
        .M_AXI_DP_WREADY(microblaze_0_M_AXI_DP_WREADY),
        .M_AXI_DP_WSTRB(microblaze_0_M_AXI_DP_WSTRB),
        .M_AXI_DP_WVALID(microblaze_0_M_AXI_DP_WVALID),
        .Read_Strobe(microblaze_0_dlmb_1_READSTROBE),
        .Reset(rst_clk_wiz_0_100M_mb_reset),
        .Write_Strobe(microblaze_0_dlmb_1_WRITESTROBE));
  Main_microblaze_0_axi_intc_3 microblaze_0_axi_intc
       (.intr(microblaze_0_intr),
        .irq(microblaze_0_axi_intc_interrupt_INTERRUPT),
        .s_axi_aclk(microblaze_0_Clk),
        .s_axi_araddr(axi_smc_M04_AXI_ARADDR),
        .s_axi_aresetn(rst_clk_wiz_0_100M_peripheral_aresetn),
        .s_axi_arready(axi_smc_M04_AXI_ARREADY),
        .s_axi_arvalid(axi_smc_M04_AXI_ARVALID),
        .s_axi_awaddr(axi_smc_M04_AXI_AWADDR),
        .s_axi_awready(axi_smc_M04_AXI_AWREADY),
        .s_axi_awvalid(axi_smc_M04_AXI_AWVALID),
        .s_axi_bready(axi_smc_M04_AXI_BREADY),
        .s_axi_bresp(axi_smc_M04_AXI_BRESP),
        .s_axi_bvalid(axi_smc_M04_AXI_BVALID),
        .s_axi_rdata(axi_smc_M04_AXI_RDATA),
        .s_axi_rready(axi_smc_M04_AXI_RREADY),
        .s_axi_rresp(axi_smc_M04_AXI_RRESP),
        .s_axi_rvalid(axi_smc_M04_AXI_RVALID),
        .s_axi_wdata(axi_smc_M04_AXI_WDATA),
        .s_axi_wready(axi_smc_M04_AXI_WREADY),
        .s_axi_wstrb(axi_smc_M04_AXI_WSTRB),
        .s_axi_wvalid(axi_smc_M04_AXI_WVALID));
  microblaze_0_local_memory_imp_2C4IQC microblaze_0_local_memory
       (.DLMB_abus(microblaze_0_dlmb_1_ABUS),
        .DLMB_addrstrobe(microblaze_0_dlmb_1_ADDRSTROBE),
        .DLMB_be(microblaze_0_dlmb_1_BE),
        .DLMB_ce(microblaze_0_dlmb_1_CE),
        .DLMB_readdbus(microblaze_0_dlmb_1_READDBUS),
        .DLMB_readstrobe(microblaze_0_dlmb_1_READSTROBE),
        .DLMB_ready(microblaze_0_dlmb_1_READY),
        .DLMB_ue(microblaze_0_dlmb_1_UE),
        .DLMB_wait(microblaze_0_dlmb_1_WAIT),
        .DLMB_writedbus(microblaze_0_dlmb_1_WRITEDBUS),
        .DLMB_writestrobe(microblaze_0_dlmb_1_WRITESTROBE),
        .ILMB_abus(microblaze_0_ilmb_1_ABUS),
        .ILMB_addrstrobe(microblaze_0_ilmb_1_ADDRSTROBE),
        .ILMB_ce(microblaze_0_ilmb_1_CE),
        .ILMB_readdbus(microblaze_0_ilmb_1_READDBUS),
        .ILMB_readstrobe(microblaze_0_ilmb_1_READSTROBE),
        .ILMB_ready(microblaze_0_ilmb_1_READY),
        .ILMB_ue(microblaze_0_ilmb_1_UE),
        .ILMB_wait(microblaze_0_ilmb_1_WAIT),
        .LMB_Clk(microblaze_0_Clk),
        .SYS_Rst(rst_clk_wiz_0_100M_bus_struct_reset));
  Main_microblaze_0_xlconcat_3 microblaze_0_xlconcat
       (.In0(axi_uartlite_0_interrupt),
        .In1(DSP_data_ready_o),
        .dout(microblaze_0_intr));
  Main_rst_clk_wiz_0_100M_1 rst_clk_wiz_0_100M
       (.aux_reset_in(1'b1),
        .bus_struct_reset(rst_clk_wiz_0_100M_bus_struct_reset),
        .dcm_locked(clk_wiz_0_locked),
        .ext_reset_in(reset_1),
        .mb_debug_sys_rst(mdm_1_debug_sys_rst),
        .mb_reset(rst_clk_wiz_0_100M_mb_reset),
        .peripheral_aresetn(rst_clk_wiz_0_100M_peripheral_aresetn),
        .slowest_sync_clk(microblaze_0_Clk));
  Main_sampling_controller_0_0 sampling_controller_0
       (.adc_data_1(AD7983_driver_0_data_o),
        .adc_data_2(xlconstant_0_dout),
        .adc_data_ready_i(AD7983_driver_0_data_rd_ready_o),
        .bram_addr(sampling_controller_0_bram_addr),
        .bram_clk(sampling_controller_0_bram_clk),
        .bram_en(sampling_controller_0_bram_en),
        .bram_rddata(axi_bram_ctrl_0_bram_doutb),
        .bram_we(sampling_controller_0_bram_we),
        .bram_wrdata(sampling_controller_0_bram_wrdata),
        .data_ready_o(DSP_data_ready_o),
        .enc_cnt_i(Encoder_cnt_o_0),
        .fpga_clk_i(microblaze_0_Clk),
        .idle_o(sampling_controller_0_idle_o),
        .reset_n_i(rst_clk_wiz_0_100M_peripheral_aresetn),
        .trigger_i(Input_debouncer_0_trigg_falling));
  /* Output of the XOR gate on bot
quadrature encoder outputs
will change state for every encoder
step. We'll use this to trigger the ADC */
  Main_util_vector_logic_0_1 util_vector_logic_0
       (.Op1(Encoder_signal_out),
        .Op2(Encoder_signal_out1),
        .Res(util_vector_logic_0_Res));
  Main_xlconcat_0_0 xlconcat_0
       (.In0(SW0_1),
        .In1(Encoder_dir_o_0),
        .dout(xlconcat_0_dout));
  Main_xlconstant_0_0 xlconstant_0
       (.dout(xlconstant_0_dout));
endmodule

module microblaze_0_local_memory_imp_2C4IQC
   (DLMB_abus,
    DLMB_addrstrobe,
    DLMB_be,
    DLMB_ce,
    DLMB_readdbus,
    DLMB_readstrobe,
    DLMB_ready,
    DLMB_ue,
    DLMB_wait,
    DLMB_writedbus,
    DLMB_writestrobe,
    ILMB_abus,
    ILMB_addrstrobe,
    ILMB_ce,
    ILMB_readdbus,
    ILMB_readstrobe,
    ILMB_ready,
    ILMB_ue,
    ILMB_wait,
    LMB_Clk,
    SYS_Rst);
  input [0:31]DLMB_abus;
  input DLMB_addrstrobe;
  input [0:3]DLMB_be;
  output DLMB_ce;
  output [0:31]DLMB_readdbus;
  input DLMB_readstrobe;
  output DLMB_ready;
  output DLMB_ue;
  output DLMB_wait;
  input [0:31]DLMB_writedbus;
  input DLMB_writestrobe;
  input [0:31]ILMB_abus;
  input ILMB_addrstrobe;
  output ILMB_ce;
  output [0:31]ILMB_readdbus;
  input ILMB_readstrobe;
  output ILMB_ready;
  output ILMB_ue;
  output ILMB_wait;
  input LMB_Clk;
  input SYS_Rst;

  wire SYS_Rst_1;
  wire microblaze_0_Clk;
  wire [0:31]microblaze_0_dlmb_ABUS;
  wire microblaze_0_dlmb_ADDRSTROBE;
  wire [0:3]microblaze_0_dlmb_BE;
  wire microblaze_0_dlmb_CE;
  wire [0:31]microblaze_0_dlmb_READDBUS;
  wire microblaze_0_dlmb_READSTROBE;
  wire microblaze_0_dlmb_READY;
  wire microblaze_0_dlmb_UE;
  wire microblaze_0_dlmb_WAIT;
  wire [0:31]microblaze_0_dlmb_WRITEDBUS;
  wire microblaze_0_dlmb_WRITESTROBE;
  wire [0:31]microblaze_0_dlmb_bus_ABUS;
  wire microblaze_0_dlmb_bus_ADDRSTROBE;
  wire [0:3]microblaze_0_dlmb_bus_BE;
  wire microblaze_0_dlmb_bus_CE;
  wire [0:31]microblaze_0_dlmb_bus_READDBUS;
  wire microblaze_0_dlmb_bus_READSTROBE;
  wire microblaze_0_dlmb_bus_READY;
  wire microblaze_0_dlmb_bus_UE;
  wire microblaze_0_dlmb_bus_WAIT;
  wire [0:31]microblaze_0_dlmb_bus_WRITEDBUS;
  wire microblaze_0_dlmb_bus_WRITESTROBE;
  wire [0:31]microblaze_0_dlmb_cntlr_ADDR;
  wire microblaze_0_dlmb_cntlr_CLK;
  wire [0:31]microblaze_0_dlmb_cntlr_DIN;
  wire [31:0]microblaze_0_dlmb_cntlr_DOUT;
  wire microblaze_0_dlmb_cntlr_EN;
  wire microblaze_0_dlmb_cntlr_RST;
  wire [0:3]microblaze_0_dlmb_cntlr_WE;
  wire [0:31]microblaze_0_ilmb_ABUS;
  wire microblaze_0_ilmb_ADDRSTROBE;
  wire microblaze_0_ilmb_CE;
  wire [0:31]microblaze_0_ilmb_READDBUS;
  wire microblaze_0_ilmb_READSTROBE;
  wire microblaze_0_ilmb_READY;
  wire microblaze_0_ilmb_UE;
  wire microblaze_0_ilmb_WAIT;
  wire [0:31]microblaze_0_ilmb_bus_ABUS;
  wire microblaze_0_ilmb_bus_ADDRSTROBE;
  wire [0:3]microblaze_0_ilmb_bus_BE;
  wire microblaze_0_ilmb_bus_CE;
  wire [0:31]microblaze_0_ilmb_bus_READDBUS;
  wire microblaze_0_ilmb_bus_READSTROBE;
  wire microblaze_0_ilmb_bus_READY;
  wire microblaze_0_ilmb_bus_UE;
  wire microblaze_0_ilmb_bus_WAIT;
  wire [0:31]microblaze_0_ilmb_bus_WRITEDBUS;
  wire microblaze_0_ilmb_bus_WRITESTROBE;
  wire [0:31]microblaze_0_ilmb_cntlr_ADDR;
  wire microblaze_0_ilmb_cntlr_CLK;
  wire [0:31]microblaze_0_ilmb_cntlr_DIN;
  wire [31:0]microblaze_0_ilmb_cntlr_DOUT;
  wire microblaze_0_ilmb_cntlr_EN;
  wire microblaze_0_ilmb_cntlr_RST;
  wire [0:3]microblaze_0_ilmb_cntlr_WE;

  assign DLMB_ce = microblaze_0_dlmb_CE;
  assign DLMB_readdbus[0:31] = microblaze_0_dlmb_READDBUS;
  assign DLMB_ready = microblaze_0_dlmb_READY;
  assign DLMB_ue = microblaze_0_dlmb_UE;
  assign DLMB_wait = microblaze_0_dlmb_WAIT;
  assign ILMB_ce = microblaze_0_ilmb_CE;
  assign ILMB_readdbus[0:31] = microblaze_0_ilmb_READDBUS;
  assign ILMB_ready = microblaze_0_ilmb_READY;
  assign ILMB_ue = microblaze_0_ilmb_UE;
  assign ILMB_wait = microblaze_0_ilmb_WAIT;
  assign SYS_Rst_1 = SYS_Rst;
  assign microblaze_0_Clk = LMB_Clk;
  assign microblaze_0_dlmb_ABUS = DLMB_abus[0:31];
  assign microblaze_0_dlmb_ADDRSTROBE = DLMB_addrstrobe;
  assign microblaze_0_dlmb_BE = DLMB_be[0:3];
  assign microblaze_0_dlmb_READSTROBE = DLMB_readstrobe;
  assign microblaze_0_dlmb_WRITEDBUS = DLMB_writedbus[0:31];
  assign microblaze_0_dlmb_WRITESTROBE = DLMB_writestrobe;
  assign microblaze_0_ilmb_ABUS = ILMB_abus[0:31];
  assign microblaze_0_ilmb_ADDRSTROBE = ILMB_addrstrobe;
  assign microblaze_0_ilmb_READSTROBE = ILMB_readstrobe;
  (* BMM_INFO_ADDRESS_SPACE = "byte  0x00000000 32 > Main microblaze_0_local_memory/lmb_bram" *) 
  (* KEEP_HIERARCHY = "yes" *) 
  Main_dlmb_bram_if_cntlr_4 dlmb_bram_if_cntlr
       (.BRAM_Addr_A(microblaze_0_dlmb_cntlr_ADDR),
        .BRAM_Clk_A(microblaze_0_dlmb_cntlr_CLK),
        .BRAM_Din_A({microblaze_0_dlmb_cntlr_DOUT[31],microblaze_0_dlmb_cntlr_DOUT[30],microblaze_0_dlmb_cntlr_DOUT[29],microblaze_0_dlmb_cntlr_DOUT[28],microblaze_0_dlmb_cntlr_DOUT[27],microblaze_0_dlmb_cntlr_DOUT[26],microblaze_0_dlmb_cntlr_DOUT[25],microblaze_0_dlmb_cntlr_DOUT[24],microblaze_0_dlmb_cntlr_DOUT[23],microblaze_0_dlmb_cntlr_DOUT[22],microblaze_0_dlmb_cntlr_DOUT[21],microblaze_0_dlmb_cntlr_DOUT[20],microblaze_0_dlmb_cntlr_DOUT[19],microblaze_0_dlmb_cntlr_DOUT[18],microblaze_0_dlmb_cntlr_DOUT[17],microblaze_0_dlmb_cntlr_DOUT[16],microblaze_0_dlmb_cntlr_DOUT[15],microblaze_0_dlmb_cntlr_DOUT[14],microblaze_0_dlmb_cntlr_DOUT[13],microblaze_0_dlmb_cntlr_DOUT[12],microblaze_0_dlmb_cntlr_DOUT[11],microblaze_0_dlmb_cntlr_DOUT[10],microblaze_0_dlmb_cntlr_DOUT[9],microblaze_0_dlmb_cntlr_DOUT[8],microblaze_0_dlmb_cntlr_DOUT[7],microblaze_0_dlmb_cntlr_DOUT[6],microblaze_0_dlmb_cntlr_DOUT[5],microblaze_0_dlmb_cntlr_DOUT[4],microblaze_0_dlmb_cntlr_DOUT[3],microblaze_0_dlmb_cntlr_DOUT[2],microblaze_0_dlmb_cntlr_DOUT[1],microblaze_0_dlmb_cntlr_DOUT[0]}),
        .BRAM_Dout_A(microblaze_0_dlmb_cntlr_DIN),
        .BRAM_EN_A(microblaze_0_dlmb_cntlr_EN),
        .BRAM_Rst_A(microblaze_0_dlmb_cntlr_RST),
        .BRAM_WEN_A(microblaze_0_dlmb_cntlr_WE),
        .LMB_ABus(microblaze_0_dlmb_bus_ABUS),
        .LMB_AddrStrobe(microblaze_0_dlmb_bus_ADDRSTROBE),
        .LMB_BE(microblaze_0_dlmb_bus_BE),
        .LMB_Clk(microblaze_0_Clk),
        .LMB_ReadStrobe(microblaze_0_dlmb_bus_READSTROBE),
        .LMB_Rst(SYS_Rst_1),
        .LMB_WriteDBus(microblaze_0_dlmb_bus_WRITEDBUS),
        .LMB_WriteStrobe(microblaze_0_dlmb_bus_WRITESTROBE),
        .Sl_CE(microblaze_0_dlmb_bus_CE),
        .Sl_DBus(microblaze_0_dlmb_bus_READDBUS),
        .Sl_Ready(microblaze_0_dlmb_bus_READY),
        .Sl_UE(microblaze_0_dlmb_bus_UE),
        .Sl_Wait(microblaze_0_dlmb_bus_WAIT));
  Main_dlmb_v10_4 dlmb_v10
       (.LMB_ABus(microblaze_0_dlmb_bus_ABUS),
        .LMB_AddrStrobe(microblaze_0_dlmb_bus_ADDRSTROBE),
        .LMB_BE(microblaze_0_dlmb_bus_BE),
        .LMB_CE(microblaze_0_dlmb_CE),
        .LMB_Clk(microblaze_0_Clk),
        .LMB_ReadDBus(microblaze_0_dlmb_READDBUS),
        .LMB_ReadStrobe(microblaze_0_dlmb_bus_READSTROBE),
        .LMB_Ready(microblaze_0_dlmb_READY),
        .LMB_UE(microblaze_0_dlmb_UE),
        .LMB_Wait(microblaze_0_dlmb_WAIT),
        .LMB_WriteDBus(microblaze_0_dlmb_bus_WRITEDBUS),
        .LMB_WriteStrobe(microblaze_0_dlmb_bus_WRITESTROBE),
        .M_ABus(microblaze_0_dlmb_ABUS),
        .M_AddrStrobe(microblaze_0_dlmb_ADDRSTROBE),
        .M_BE(microblaze_0_dlmb_BE),
        .M_DBus(microblaze_0_dlmb_WRITEDBUS),
        .M_ReadStrobe(microblaze_0_dlmb_READSTROBE),
        .M_WriteStrobe(microblaze_0_dlmb_WRITESTROBE),
        .SYS_Rst(SYS_Rst_1),
        .Sl_CE(microblaze_0_dlmb_bus_CE),
        .Sl_DBus(microblaze_0_dlmb_bus_READDBUS),
        .Sl_Ready(microblaze_0_dlmb_bus_READY),
        .Sl_UE(microblaze_0_dlmb_bus_UE),
        .Sl_Wait(microblaze_0_dlmb_bus_WAIT));
  Main_ilmb_bram_if_cntlr_4 ilmb_bram_if_cntlr
       (.BRAM_Addr_A(microblaze_0_ilmb_cntlr_ADDR),
        .BRAM_Clk_A(microblaze_0_ilmb_cntlr_CLK),
        .BRAM_Din_A({microblaze_0_ilmb_cntlr_DOUT[31],microblaze_0_ilmb_cntlr_DOUT[30],microblaze_0_ilmb_cntlr_DOUT[29],microblaze_0_ilmb_cntlr_DOUT[28],microblaze_0_ilmb_cntlr_DOUT[27],microblaze_0_ilmb_cntlr_DOUT[26],microblaze_0_ilmb_cntlr_DOUT[25],microblaze_0_ilmb_cntlr_DOUT[24],microblaze_0_ilmb_cntlr_DOUT[23],microblaze_0_ilmb_cntlr_DOUT[22],microblaze_0_ilmb_cntlr_DOUT[21],microblaze_0_ilmb_cntlr_DOUT[20],microblaze_0_ilmb_cntlr_DOUT[19],microblaze_0_ilmb_cntlr_DOUT[18],microblaze_0_ilmb_cntlr_DOUT[17],microblaze_0_ilmb_cntlr_DOUT[16],microblaze_0_ilmb_cntlr_DOUT[15],microblaze_0_ilmb_cntlr_DOUT[14],microblaze_0_ilmb_cntlr_DOUT[13],microblaze_0_ilmb_cntlr_DOUT[12],microblaze_0_ilmb_cntlr_DOUT[11],microblaze_0_ilmb_cntlr_DOUT[10],microblaze_0_ilmb_cntlr_DOUT[9],microblaze_0_ilmb_cntlr_DOUT[8],microblaze_0_ilmb_cntlr_DOUT[7],microblaze_0_ilmb_cntlr_DOUT[6],microblaze_0_ilmb_cntlr_DOUT[5],microblaze_0_ilmb_cntlr_DOUT[4],microblaze_0_ilmb_cntlr_DOUT[3],microblaze_0_ilmb_cntlr_DOUT[2],microblaze_0_ilmb_cntlr_DOUT[1],microblaze_0_ilmb_cntlr_DOUT[0]}),
        .BRAM_Dout_A(microblaze_0_ilmb_cntlr_DIN),
        .BRAM_EN_A(microblaze_0_ilmb_cntlr_EN),
        .BRAM_Rst_A(microblaze_0_ilmb_cntlr_RST),
        .BRAM_WEN_A(microblaze_0_ilmb_cntlr_WE),
        .LMB_ABus(microblaze_0_ilmb_bus_ABUS),
        .LMB_AddrStrobe(microblaze_0_ilmb_bus_ADDRSTROBE),
        .LMB_BE(microblaze_0_ilmb_bus_BE),
        .LMB_Clk(microblaze_0_Clk),
        .LMB_ReadStrobe(microblaze_0_ilmb_bus_READSTROBE),
        .LMB_Rst(SYS_Rst_1),
        .LMB_WriteDBus(microblaze_0_ilmb_bus_WRITEDBUS),
        .LMB_WriteStrobe(microblaze_0_ilmb_bus_WRITESTROBE),
        .Sl_CE(microblaze_0_ilmb_bus_CE),
        .Sl_DBus(microblaze_0_ilmb_bus_READDBUS),
        .Sl_Ready(microblaze_0_ilmb_bus_READY),
        .Sl_UE(microblaze_0_ilmb_bus_UE),
        .Sl_Wait(microblaze_0_ilmb_bus_WAIT));
  Main_ilmb_v10_4 ilmb_v10
       (.LMB_ABus(microblaze_0_ilmb_bus_ABUS),
        .LMB_AddrStrobe(microblaze_0_ilmb_bus_ADDRSTROBE),
        .LMB_BE(microblaze_0_ilmb_bus_BE),
        .LMB_CE(microblaze_0_ilmb_CE),
        .LMB_Clk(microblaze_0_Clk),
        .LMB_ReadDBus(microblaze_0_ilmb_READDBUS),
        .LMB_ReadStrobe(microblaze_0_ilmb_bus_READSTROBE),
        .LMB_Ready(microblaze_0_ilmb_READY),
        .LMB_UE(microblaze_0_ilmb_UE),
        .LMB_Wait(microblaze_0_ilmb_WAIT),
        .LMB_WriteDBus(microblaze_0_ilmb_bus_WRITEDBUS),
        .LMB_WriteStrobe(microblaze_0_ilmb_bus_WRITESTROBE),
        .M_ABus(microblaze_0_ilmb_ABUS),
        .M_AddrStrobe(microblaze_0_ilmb_ADDRSTROBE),
        .M_BE({1'b0,1'b0,1'b0,1'b0}),
        .M_DBus({1'b0,1'b0,1'b0,1'b0,1'b0,1'b0,1'b0,1'b0,1'b0,1'b0,1'b0,1'b0,1'b0,1'b0,1'b0,1'b0,1'b0,1'b0,1'b0,1'b0,1'b0,1'b0,1'b0,1'b0,1'b0,1'b0,1'b0,1'b0,1'b0,1'b0,1'b0,1'b0}),
        .M_ReadStrobe(microblaze_0_ilmb_READSTROBE),
        .M_WriteStrobe(1'b0),
        .SYS_Rst(SYS_Rst_1),
        .Sl_CE(microblaze_0_ilmb_bus_CE),
        .Sl_DBus(microblaze_0_ilmb_bus_READDBUS),
        .Sl_Ready(microblaze_0_ilmb_bus_READY),
        .Sl_UE(microblaze_0_ilmb_bus_UE),
        .Sl_Wait(microblaze_0_ilmb_bus_WAIT));
  Main_lmb_bram_4 lmb_bram
       (.addra({microblaze_0_dlmb_cntlr_ADDR[0],microblaze_0_dlmb_cntlr_ADDR[1],microblaze_0_dlmb_cntlr_ADDR[2],microblaze_0_dlmb_cntlr_ADDR[3],microblaze_0_dlmb_cntlr_ADDR[4],microblaze_0_dlmb_cntlr_ADDR[5],microblaze_0_dlmb_cntlr_ADDR[6],microblaze_0_dlmb_cntlr_ADDR[7],microblaze_0_dlmb_cntlr_ADDR[8],microblaze_0_dlmb_cntlr_ADDR[9],microblaze_0_dlmb_cntlr_ADDR[10],microblaze_0_dlmb_cntlr_ADDR[11],microblaze_0_dlmb_cntlr_ADDR[12],microblaze_0_dlmb_cntlr_ADDR[13],microblaze_0_dlmb_cntlr_ADDR[14],microblaze_0_dlmb_cntlr_ADDR[15],microblaze_0_dlmb_cntlr_ADDR[16],microblaze_0_dlmb_cntlr_ADDR[17],microblaze_0_dlmb_cntlr_ADDR[18],microblaze_0_dlmb_cntlr_ADDR[19],microblaze_0_dlmb_cntlr_ADDR[20],microblaze_0_dlmb_cntlr_ADDR[21],microblaze_0_dlmb_cntlr_ADDR[22],microblaze_0_dlmb_cntlr_ADDR[23],microblaze_0_dlmb_cntlr_ADDR[24],microblaze_0_dlmb_cntlr_ADDR[25],microblaze_0_dlmb_cntlr_ADDR[26],microblaze_0_dlmb_cntlr_ADDR[27],microblaze_0_dlmb_cntlr_ADDR[28],microblaze_0_dlmb_cntlr_ADDR[29],microblaze_0_dlmb_cntlr_ADDR[30],microblaze_0_dlmb_cntlr_ADDR[31]}),
        .addrb({microblaze_0_ilmb_cntlr_ADDR[0],microblaze_0_ilmb_cntlr_ADDR[1],microblaze_0_ilmb_cntlr_ADDR[2],microblaze_0_ilmb_cntlr_ADDR[3],microblaze_0_ilmb_cntlr_ADDR[4],microblaze_0_ilmb_cntlr_ADDR[5],microblaze_0_ilmb_cntlr_ADDR[6],microblaze_0_ilmb_cntlr_ADDR[7],microblaze_0_ilmb_cntlr_ADDR[8],microblaze_0_ilmb_cntlr_ADDR[9],microblaze_0_ilmb_cntlr_ADDR[10],microblaze_0_ilmb_cntlr_ADDR[11],microblaze_0_ilmb_cntlr_ADDR[12],microblaze_0_ilmb_cntlr_ADDR[13],microblaze_0_ilmb_cntlr_ADDR[14],microblaze_0_ilmb_cntlr_ADDR[15],microblaze_0_ilmb_cntlr_ADDR[16],microblaze_0_ilmb_cntlr_ADDR[17],microblaze_0_ilmb_cntlr_ADDR[18],microblaze_0_ilmb_cntlr_ADDR[19],microblaze_0_ilmb_cntlr_ADDR[20],microblaze_0_ilmb_cntlr_ADDR[21],microblaze_0_ilmb_cntlr_ADDR[22],microblaze_0_ilmb_cntlr_ADDR[23],microblaze_0_ilmb_cntlr_ADDR[24],microblaze_0_ilmb_cntlr_ADDR[25],microblaze_0_ilmb_cntlr_ADDR[26],microblaze_0_ilmb_cntlr_ADDR[27],microblaze_0_ilmb_cntlr_ADDR[28],microblaze_0_ilmb_cntlr_ADDR[29],microblaze_0_ilmb_cntlr_ADDR[30],microblaze_0_ilmb_cntlr_ADDR[31]}),
        .clka(microblaze_0_dlmb_cntlr_CLK),
        .clkb(microblaze_0_ilmb_cntlr_CLK),
        .dina({microblaze_0_dlmb_cntlr_DIN[0],microblaze_0_dlmb_cntlr_DIN[1],microblaze_0_dlmb_cntlr_DIN[2],microblaze_0_dlmb_cntlr_DIN[3],microblaze_0_dlmb_cntlr_DIN[4],microblaze_0_dlmb_cntlr_DIN[5],microblaze_0_dlmb_cntlr_DIN[6],microblaze_0_dlmb_cntlr_DIN[7],microblaze_0_dlmb_cntlr_DIN[8],microblaze_0_dlmb_cntlr_DIN[9],microblaze_0_dlmb_cntlr_DIN[10],microblaze_0_dlmb_cntlr_DIN[11],microblaze_0_dlmb_cntlr_DIN[12],microblaze_0_dlmb_cntlr_DIN[13],microblaze_0_dlmb_cntlr_DIN[14],microblaze_0_dlmb_cntlr_DIN[15],microblaze_0_dlmb_cntlr_DIN[16],microblaze_0_dlmb_cntlr_DIN[17],microblaze_0_dlmb_cntlr_DIN[18],microblaze_0_dlmb_cntlr_DIN[19],microblaze_0_dlmb_cntlr_DIN[20],microblaze_0_dlmb_cntlr_DIN[21],microblaze_0_dlmb_cntlr_DIN[22],microblaze_0_dlmb_cntlr_DIN[23],microblaze_0_dlmb_cntlr_DIN[24],microblaze_0_dlmb_cntlr_DIN[25],microblaze_0_dlmb_cntlr_DIN[26],microblaze_0_dlmb_cntlr_DIN[27],microblaze_0_dlmb_cntlr_DIN[28],microblaze_0_dlmb_cntlr_DIN[29],microblaze_0_dlmb_cntlr_DIN[30],microblaze_0_dlmb_cntlr_DIN[31]}),
        .dinb({microblaze_0_ilmb_cntlr_DIN[0],microblaze_0_ilmb_cntlr_DIN[1],microblaze_0_ilmb_cntlr_DIN[2],microblaze_0_ilmb_cntlr_DIN[3],microblaze_0_ilmb_cntlr_DIN[4],microblaze_0_ilmb_cntlr_DIN[5],microblaze_0_ilmb_cntlr_DIN[6],microblaze_0_ilmb_cntlr_DIN[7],microblaze_0_ilmb_cntlr_DIN[8],microblaze_0_ilmb_cntlr_DIN[9],microblaze_0_ilmb_cntlr_DIN[10],microblaze_0_ilmb_cntlr_DIN[11],microblaze_0_ilmb_cntlr_DIN[12],microblaze_0_ilmb_cntlr_DIN[13],microblaze_0_ilmb_cntlr_DIN[14],microblaze_0_ilmb_cntlr_DIN[15],microblaze_0_ilmb_cntlr_DIN[16],microblaze_0_ilmb_cntlr_DIN[17],microblaze_0_ilmb_cntlr_DIN[18],microblaze_0_ilmb_cntlr_DIN[19],microblaze_0_ilmb_cntlr_DIN[20],microblaze_0_ilmb_cntlr_DIN[21],microblaze_0_ilmb_cntlr_DIN[22],microblaze_0_ilmb_cntlr_DIN[23],microblaze_0_ilmb_cntlr_DIN[24],microblaze_0_ilmb_cntlr_DIN[25],microblaze_0_ilmb_cntlr_DIN[26],microblaze_0_ilmb_cntlr_DIN[27],microblaze_0_ilmb_cntlr_DIN[28],microblaze_0_ilmb_cntlr_DIN[29],microblaze_0_ilmb_cntlr_DIN[30],microblaze_0_ilmb_cntlr_DIN[31]}),
        .douta(microblaze_0_dlmb_cntlr_DOUT),
        .doutb(microblaze_0_ilmb_cntlr_DOUT),
        .ena(microblaze_0_dlmb_cntlr_EN),
        .enb(microblaze_0_ilmb_cntlr_EN),
        .rsta(microblaze_0_dlmb_cntlr_RST),
        .rstb(microblaze_0_ilmb_cntlr_RST),
        .wea({microblaze_0_dlmb_cntlr_WE[0],microblaze_0_dlmb_cntlr_WE[1],microblaze_0_dlmb_cntlr_WE[2],microblaze_0_dlmb_cntlr_WE[3]}),
        .web({microblaze_0_ilmb_cntlr_WE[0],microblaze_0_ilmb_cntlr_WE[1],microblaze_0_ilmb_cntlr_WE[2],microblaze_0_ilmb_cntlr_WE[3]}));
endmodule
