JPirman/FPGA_polarimeter/Encoder_sampling/Vivado/Encoder_sampler.srcs/constrs_1/new/Pinout.xdc

set_property IOSTANDARD LVCMOS33 [get_ports adc_cnv_0]
set_property IOSTANDARD LVCMOS33 [get_ports adc_sck_0]
set_property IOSTANDARD LVCMOS33 [get_ports adc_sdo_0]
set_property PACKAGE_PIN L17 [get_ports adc_cnv_0]
set_property PACKAGE_PIN N14 [get_ports adc_sck_0]
set_property PACKAGE_PIN M14 [get_ports adc_sdo_0]


set_property IOSTANDARD LVCMOS33 [get_ports sys_clock]




set_property IOSTANDARD LVCMOS33 [get_ports A_i_0]
set_property IOSTANDARD LVCMOS33 [get_ports B_i_0]
set_property PACKAGE_PIN V16 [get_ports A_i_0]

set_property IOSTANDARD LVCMOS33 [get_ports SW0]
set_property IOSTANDARD LVCMOS33 [get_ports mot_dir]
set_property PACKAGE_PIN E18 [get_ports mot_dir]
set_property PACKAGE_PIN H14 [get_ports SW0]

set_property PACKAGE_PIN T15 [get_ports mot_sby]
set_property IOSTANDARD LVCMOS33 [get_ports mot_sby]
set_property PACKAGE_PIN H16 [get_ports spi_ss_io]

set_property IOSTANDARD LVCMOS33 [get_ports dir_o_0]
set_property PACKAGE_PIN F13 [get_ports dir_o_0]
set_property PACKAGE_PIN U15 [get_ports I_i_0]
set_property IOSTANDARD LVCMOS33 [get_ports I_i_0]

set_property IOSTANDARD LVCMOS33 [get_ports {cnt_o_0[10]}]
set_property IOSTANDARD LVCMOS33 [get_ports {cnt_o_0[9]}]
set_property IOSTANDARD LVCMOS33 [get_ports {cnt_o_0[8]}]
set_property IOSTANDARD LVCMOS33 [get_ports {cnt_o_0[7]}]
set_property IOSTANDARD LVCMOS33 [get_ports {cnt_o_0[6]}]
set_property IOSTANDARD LVCMOS33 [get_ports {cnt_o_0[5]}]
set_property IOSTANDARD LVCMOS33 [get_ports {cnt_o_0[4]}]
set_property IOSTANDARD LVCMOS33 [get_ports {cnt_o_0[3]}]
set_property IOSTANDARD LVCMOS33 [get_ports {cnt_o_0[2]}]
set_property IOSTANDARD LVCMOS33 [get_ports {cnt_o_0[1]}]
set_property IOSTANDARD LVCMOS33 [get_ports {cnt_o_0[0]}]
set_property PACKAGE_PIN V15 [get_ports {cnt_o_0[0]}]
set_property PACKAGE_PIN U12 [get_ports {cnt_o_0[1]}]
set_property PACKAGE_PIN V13 [get_ports {cnt_o_0[2]}]
set_property PACKAGE_PIN T12 [get_ports {cnt_o_0[3]}]
set_property PACKAGE_PIN T13 [get_ports {cnt_o_0[4]}]
set_property PACKAGE_PIN R11 [get_ports {cnt_o_0[5]}]
set_property PACKAGE_PIN T11 [get_ports {cnt_o_0[6]}]
set_property PACKAGE_PIN U11 [get_ports {cnt_o_0[7]}]
set_property PACKAGE_PIN R13 [get_ports {cnt_o_0[10]}]
set_property PACKAGE_PIN P13 [get_ports {cnt_o_0[9]}]
set_property PACKAGE_PIN U16 [get_ports {cnt_o_0[8]}]

set_property IOSTANDARD LVCMOS33 [get_ports out_0]
set_property IOSTANDARD LVCMOS33 [get_ports out_1]
set_property PACKAGE_PIN P17 [get_ports out_0]
set_property PACKAGE_PIN P18 [get_ports out_1]

set_property PACKAGE_PIN U17 [get_ports B_i_0]

set_property IOSTANDARD LVCMOS33 [get_ports LD4]
set_property PACKAGE_PIN E13 [get_ports LD4]
set_property IOSTANDARD LVCMOS33 [get_ports LD2]
set_property IOSTANDARD LVCMOS33 [get_ports LD3]
set_property PACKAGE_PIN E18 [get_ports LD2]
set_property PACKAGE_PIN F13 [get_ports LD3]
set_property IOSTANDARD LVCMOS33 [get_ports BTN0]
set_property PACKAGE_PIN G15 [get_ports BTN0]

set_property IOSTANDARD LVCMOS33 [get_ports LD5]
set_property PACKAGE_PIN H15 [get_ports LD5]
