JPirman/FPGA_polarimeter/Encoder_sampling/Vivado/Encoder_sampler.cache/ip/2022.1/6/3/6363b6aae06d03a1/Main_axi_smc_0_stub.vhdl

-- Copyright 1986-2022 Xilinx, Inc. All Rights Reserved.
-- --------------------------------------------------------------------------------
-- Tool Version: Vivado v.2022.1 (lin64) Build 3526262 Mon Apr 18 15:47:01 MDT 2022
-- Date        : Thu Jul 14 23:25:04 2022
-- Host        : Jure-Linux running 64-bit Linux Mint 20.3
-- Command     : write_vhdl -force -mode synth_stub -rename_top decalper_eb_ot_sdeen_pot_pi_dehcac_xnilix -prefix
--               decalper_eb_ot_sdeen_pot_pi_dehcac_xnilix_ Main_axi_smc_0_stub.vhdl
-- Design      : Main_axi_smc_0
-- Purpose     : Stub declaration of top-level module interface
-- Device      : xc7s25csga324-1
-- --------------------------------------------------------------------------------
library IEEE;
use IEEE.STD_LOGIC_1164.ALL;

entity decalper_eb_ot_sdeen_pot_pi_dehcac_xnilix is
  Port ( 
    aclk : in STD_LOGIC;
    aresetn : in STD_LOGIC;
    S00_AXI_awaddr : in STD_LOGIC_VECTOR ( 31 downto 0 );
    S00_AXI_awprot : in STD_LOGIC_VECTOR ( 2 downto 0 );
    S00_AXI_awvalid : in STD_LOGIC;
    S00_AXI_awready : out STD_LOGIC;
    S00_AXI_wdata : in STD_LOGIC_VECTOR ( 31 downto 0 );
    S00_AXI_wstrb : in STD_LOGIC_VECTOR ( 3 downto 0 );
    S00_AXI_wvalid : in STD_LOGIC;
    S00_AXI_wready : out STD_LOGIC;
    S00_AXI_bresp : out STD_LOGIC_VECTOR ( 1 downto 0 );
    S00_AXI_bvalid : out STD_LOGIC;
    S00_AXI_bready : in STD_LOGIC;
    S00_AXI_araddr : in STD_LOGIC_VECTOR ( 31 downto 0 );
    S00_AXI_arprot : in STD_LOGIC_VECTOR ( 2 downto 0 );
    S00_AXI_arvalid : in STD_LOGIC;
    S00_AXI_arready : out STD_LOGIC;
    S00_AXI_rdata : out STD_LOGIC_VECTOR ( 31 downto 0 );
    S00_AXI_rresp : out STD_LOGIC_VECTOR ( 1 downto 0 );
    S00_AXI_rvalid : out STD_LOGIC;
    S00_AXI_rready : in STD_LOGIC;
    M00_AXI_awaddr : out STD_LOGIC_VECTOR ( 12 downto 0 );
    M00_AXI_awlen : out STD_LOGIC_VECTOR ( 7 downto 0 );
    M00_AXI_awsize : out STD_LOGIC_VECTOR ( 2 downto 0 );
    M00_AXI_awburst : out STD_LOGIC_VECTOR ( 1 downto 0 );
    M00_AXI_awlock : out STD_LOGIC_VECTOR ( 0 to 0 );
    M00_AXI_awcache : out STD_LOGIC_VECTOR ( 3 downto 0 );
    M00_AXI_awprot : out STD_LOGIC_VECTOR ( 2 downto 0 );
    M00_AXI_awqos : out STD_LOGIC_VECTOR ( 3 downto 0 );
    M00_AXI_awvalid : out STD_LOGIC;
    M00_AXI_awready : in STD_LOGIC;
    M00_AXI_wdata : out STD_LOGIC_VECTOR ( 31 downto 0 );
    M00_AXI_wstrb : out STD_LOGIC_VECTOR ( 3 downto 0 );
    M00_AXI_wlast : out STD_LOGIC;
    M00_AXI_wvalid : out STD_LOGIC;
    M00_AXI_wready : in STD_LOGIC;
    M00_AXI_bresp : in STD_LOGIC_VECTOR ( 1 downto 0 );
    M00_AXI_bvalid : in STD_LOGIC;
    M00_AXI_bready : out STD_LOGIC;
    M00_AXI_araddr : out STD_LOGIC_VECTOR ( 12 downto 0 );
    M00_AXI_arlen : out STD_LOGIC_VECTOR ( 7 downto 0 );
    M00_AXI_arsize : out STD_LOGIC_VECTOR ( 2 downto 0 );
    M00_AXI_arburst : out STD_LOGIC_VECTOR ( 1 downto 0 );
    M00_AXI_arlock : out STD_LOGIC_VECTOR ( 0 to 0 );
    M00_AXI_arcache : out STD_LOGIC_VECTOR ( 3 downto 0 );
    M00_AXI_arprot : out STD_LOGIC_VECTOR ( 2 downto 0 );
    M00_AXI_arqos : out STD_LOGIC_VECTOR ( 3 downto 0 );
    M00_AXI_arvalid : out STD_LOGIC;
    M00_AXI_arready : in STD_LOGIC;
    M00_AXI_rdata : in STD_LOGIC_VECTOR ( 31 downto 0 );
    M00_AXI_rresp : in STD_LOGIC_VECTOR ( 1 downto 0 );
    M00_AXI_rlast : in STD_LOGIC;
    M00_AXI_rvalid : in STD_LOGIC;
    M00_AXI_rready : out STD_LOGIC;
    M01_AXI_awaddr : out STD_LOGIC_VECTOR ( 8 downto 0 );
    M01_AXI_awprot : out STD_LOGIC_VECTOR ( 2 downto 0 );
    M01_AXI_awvalid : out STD_LOGIC;
    M01_AXI_awready : in STD_LOGIC;
    M01_AXI_wdata : out STD_LOGIC_VECTOR ( 31 downto 0 );
    M01_AXI_wstrb : out STD_LOGIC_VECTOR ( 3 downto 0 );
    M01_AXI_wvalid : out STD_LOGIC;
    M01_AXI_wready : in STD_LOGIC;
    M01_AXI_bresp : in STD_LOGIC_VECTOR ( 1 downto 0 );
    M01_AXI_bvalid : in STD_LOGIC;
    M01_AXI_bready : out STD_LOGIC;
    M01_AXI_araddr : out STD_LOGIC_VECTOR ( 8 downto 0 );
    M01_AXI_arprot : out STD_LOGIC_VECTOR ( 2 downto 0 );
    M01_AXI_arvalid : out STD_LOGIC;
    M01_AXI_arready : in STD_LOGIC;
    M01_AXI_rdata : in STD_LOGIC_VECTOR ( 31 downto 0 );
    M01_AXI_rresp : in STD_LOGIC_VECTOR ( 1 downto 0 );
    M01_AXI_rvalid : in STD_LOGIC;
    M01_AXI_rready : out STD_LOGIC;
    M02_AXI_awaddr : out STD_LOGIC_VECTOR ( 8 downto 0 );
    M02_AXI_awprot : out STD_LOGIC_VECTOR ( 2 downto 0 );
    M02_AXI_awvalid : out STD_LOGIC;
    M02_AXI_awready : in STD_LOGIC;
    M02_AXI_wdata : out STD_LOGIC_VECTOR ( 31 downto 0 );
    M02_AXI_wstrb : out STD_LOGIC_VECTOR ( 3 downto 0 );
    M02_AXI_wvalid : out STD_LOGIC;
    M02_AXI_wready : in STD_LOGIC;
    M02_AXI_bresp : in STD_LOGIC_VECTOR ( 1 downto 0 );
    M02_AXI_bvalid : in STD_LOGIC;
    M02_AXI_bready : out STD_LOGIC;
    M02_AXI_araddr : out STD_LOGIC_VECTOR ( 8 downto 0 );
    M02_AXI_arprot : out STD_LOGIC_VECTOR ( 2 downto 0 );
    M02_AXI_arvalid : out STD_LOGIC;
    M02_AXI_arready : in STD_LOGIC;
    M02_AXI_rdata : in STD_LOGIC_VECTOR ( 31 downto 0 );
    M02_AXI_rresp : in STD_LOGIC_VECTOR ( 1 downto 0 );
    M02_AXI_rvalid : in STD_LOGIC;
    M02_AXI_rready : out STD_LOGIC;
    M03_AXI_awaddr : out STD_LOGIC_VECTOR ( 3 downto 0 );
    M03_AXI_awprot : out STD_LOGIC_VECTOR ( 2 downto 0 );
    M03_AXI_awvalid : out STD_LOGIC;
    M03_AXI_awready : in STD_LOGIC;
    M03_AXI_wdata : out STD_LOGIC_VECTOR ( 31 downto 0 );
    M03_AXI_wstrb : out STD_LOGIC_VECTOR ( 3 downto 0 );
    M03_AXI_wvalid : out STD_LOGIC;
    M03_AXI_wready : in STD_LOGIC;
    M03_AXI_bresp : in STD_LOGIC_VECTOR ( 1 downto 0 );
    M03_AXI_bvalid : in STD_LOGIC;
    M03_AXI_bready : out STD_LOGIC;
    M03_AXI_araddr : out STD_LOGIC_VECTOR ( 3 downto 0 );
    M03_AXI_arprot : out STD_LOGIC_VECTOR ( 2 downto 0 );
    M03_AXI_arvalid : out STD_LOGIC;
    M03_AXI_arready : in STD_LOGIC;
    M03_AXI_rdata : in STD_LOGIC_VECTOR ( 31 downto 0 );
    M03_AXI_rresp : in STD_LOGIC_VECTOR ( 1 downto 0 );
    M03_AXI_rvalid : in STD_LOGIC;
    M03_AXI_rready : out STD_LOGIC;
    M04_AXI_awaddr : out STD_LOGIC_VECTOR ( 8 downto 0 );
    M04_AXI_awprot : out STD_LOGIC_VECTOR ( 2 downto 0 );
    M04_AXI_awvalid : out STD_LOGIC;
    M04_AXI_awready : in STD_LOGIC;
    M04_AXI_wdata : out STD_LOGIC_VECTOR ( 31 downto 0 );
    M04_AXI_wstrb : out STD_LOGIC_VECTOR ( 3 downto 0 );
    M04_AXI_wvalid : out STD_LOGIC;
    M04_AXI_wready : in STD_LOGIC;
    M04_AXI_bresp : in STD_LOGIC_VECTOR ( 1 downto 0 );
    M04_AXI_bvalid : in STD_LOGIC;
    M04_AXI_bready : out STD_LOGIC;
    M04_AXI_araddr : out STD_LOGIC_VECTOR ( 8 downto 0 );
    M04_AXI_arprot : out STD_LOGIC_VECTOR ( 2 downto 0 );
    M04_AXI_arvalid : out STD_LOGIC;
    M04_AXI_arready : in STD_LOGIC;
    M04_AXI_rdata : in STD_LOGIC_VECTOR ( 31 downto 0 );
    M04_AXI_rresp : in STD_LOGIC_VECTOR ( 1 downto 0 );
    M04_AXI_rvalid : in STD_LOGIC;
    M04_AXI_rready : out STD_LOGIC
  );

end decalper_eb_ot_sdeen_pot_pi_dehcac_xnilix;

architecture stub of decalper_eb_ot_sdeen_pot_pi_dehcac_xnilix is
attribute syn_black_box : boolean;
attribute black_box_pad_pin : string;
attribute syn_black_box of stub : architecture is true;
attribute black_box_pad_pin of stub : architecture is "aclk,aresetn,S00_AXI_awaddr[31:0],S00_AXI_awprot[2:0],S00_AXI_awvalid,S00_AXI_awready,S00_AXI_wdata[31:0],S00_AXI_wstrb[3:0],S00_AXI_wvalid,S00_AXI_wready,S00_AXI_bresp[1:0],S00_AXI_bvalid,S00_AXI_bready,S00_AXI_araddr[31:0],S00_AXI_arprot[2:0],S00_AXI_arvalid,S00_AXI_arready,S00_AXI_rdata[31:0],S00_AXI_rresp[1:0],S00_AXI_rvalid,S00_AXI_rready,M00_AXI_awaddr[12:0],M00_AXI_awlen[7:0],M00_AXI_awsize[2:0],M00_AXI_awburst[1:0],M00_AXI_awlock[0:0],M00_AXI_awcache[3:0],M00_AXI_awprot[2:0],M00_AXI_awqos[3:0],M00_AXI_awvalid,M00_AXI_awready,M00_AXI_wdata[31:0],M00_AXI_wstrb[3:0],M00_AXI_wlast,M00_AXI_wvalid,M00_AXI_wready,M00_AXI_bresp[1:0],M00_AXI_bvalid,M00_AXI_bready,M00_AXI_araddr[12:0],M00_AXI_arlen[7:0],M00_AXI_arsize[2:0],M00_AXI_arburst[1:0],M00_AXI_arlock[0:0],M00_AXI_arcache[3:0],M00_AXI_arprot[2:0],M00_AXI_arqos[3:0],M00_AXI_arvalid,M00_AXI_arready,M00_AXI_rdata[31:0],M00_AXI_rresp[1:0],M00_AXI_rlast,M00_AXI_rvalid,M00_AXI_rready,M01_AXI_awaddr[8:0],M01_AXI_awprot[2:0],M01_AXI_awvalid,M01_AXI_awready,M01_AXI_wdata[31:0],M01_AXI_wstrb[3:0],M01_AXI_wvalid,M01_AXI_wready,M01_AXI_bresp[1:0],M01_AXI_bvalid,M01_AXI_bready,M01_AXI_araddr[8:0],M01_AXI_arprot[2:0],M01_AXI_arvalid,M01_AXI_arready,M01_AXI_rdata[31:0],M01_AXI_rresp[1:0],M01_AXI_rvalid,M01_AXI_rready,M02_AXI_awaddr[8:0],M02_AXI_awprot[2:0],M02_AXI_awvalid,M02_AXI_awready,M02_AXI_wdata[31:0],M02_AXI_wstrb[3:0],M02_AXI_wvalid,M02_AXI_wready,M02_AXI_bresp[1:0],M02_AXI_bvalid,M02_AXI_bready,M02_AXI_araddr[8:0],M02_AXI_arprot[2:0],M02_AXI_arvalid,M02_AXI_arready,M02_AXI_rdata[31:0],M02_AXI_rresp[1:0],M02_AXI_rvalid,M02_AXI_rready,M03_AXI_awaddr[3:0],M03_AXI_awprot[2:0],M03_AXI_awvalid,M03_AXI_awready,M03_AXI_wdata[31:0],M03_AXI_wstrb[3:0],M03_AXI_wvalid,M03_AXI_wready,M03_AXI_bresp[1:0],M03_AXI_bvalid,M03_AXI_bready,M03_AXI_araddr[3:0],M03_AXI_arprot[2:0],M03_AXI_arvalid,M03_AXI_arready,M03_AXI_rdata[31:0],M03_AXI_rresp[1:0],M03_AXI_rvalid,M03_AXI_rready,M04_AXI_awaddr[8:0],M04_AXI_awprot[2:0],M04_AXI_awvalid,M04_AXI_awready,M04_AXI_wdata[31:0],M04_AXI_wstrb[3:0],M04_AXI_wvalid,M04_AXI_wready,M04_AXI_bresp[1:0],M04_AXI_bvalid,M04_AXI_bready,M04_AXI_araddr[8:0],M04_AXI_arprot[2:0],M04_AXI_arvalid,M04_AXI_arready,M04_AXI_rdata[31:0],M04_AXI_rresp[1:0],M04_AXI_rvalid,M04_AXI_rready";
attribute X_CORE_INFO : string;
attribute X_CORE_INFO of stub : architecture is "bd_4c2d,Vivado 2022.1";
begin
end;
