JPirman/FPGA_polarimeter/Encoder_sampling/Vivado/Encoder_sampler.cache/ip/2022.1/1/e/1ea61d68d12c55c0/Main_blk_mem_gen_0_0_stub.vhdl

-- Copyright 1986-2022 Xilinx, Inc. All Rights Reserved.
-- --------------------------------------------------------------------------------
-- Tool Version: Vivado v.2022.1 (lin64) Build 3526262 Mon Apr 18 15:47:01 MDT 2022
-- Date        : Thu Jul 14 11:18:04 2022
-- Host        : Jure-Linux running 64-bit Linux Mint 20.3
-- Command     : write_vhdl -force -mode synth_stub -rename_top decalper_eb_ot_sdeen_pot_pi_dehcac_xnilix -prefix
--               decalper_eb_ot_sdeen_pot_pi_dehcac_xnilix_ Main_blk_mem_gen_0_0_stub.vhdl
-- Design      : Main_blk_mem_gen_0_0
-- Purpose     : Stub declaration of top-level module interface
-- Device      : xc7s25csga324-1
-- --------------------------------------------------------------------------------
library IEEE;
use IEEE.STD_LOGIC_1164.ALL;

entity decalper_eb_ot_sdeen_pot_pi_dehcac_xnilix is
  Port ( 
    clka : in STD_LOGIC;
    ena : in STD_LOGIC;
    wea : in STD_LOGIC_VECTOR ( 0 to 0 );
    addra : in STD_LOGIC_VECTOR ( 9 downto 0 );
    dina : in STD_LOGIC_VECTOR ( 31 downto 0 );
    douta : out STD_LOGIC_VECTOR ( 31 downto 0 );
    clkb : in STD_LOGIC;
    enb : in STD_LOGIC;
    web : in STD_LOGIC_VECTOR ( 0 to 0 );
    addrb : in STD_LOGIC_VECTOR ( 10 downto 0 );
    dinb : in STD_LOGIC_VECTOR ( 15 downto 0 );
    doutb : out STD_LOGIC_VECTOR ( 15 downto 0 )
  );

end decalper_eb_ot_sdeen_pot_pi_dehcac_xnilix;

architecture stub of decalper_eb_ot_sdeen_pot_pi_dehcac_xnilix is
attribute syn_black_box : boolean;
attribute black_box_pad_pin : string;
attribute syn_black_box of stub : architecture is true;
attribute black_box_pad_pin of stub : architecture is "clka,ena,wea[0:0],addra[9:0],dina[31:0],douta[31:0],clkb,enb,web[0:0],addrb[10:0],dinb[15:0],doutb[15:0]";
attribute x_core_info : string;
attribute x_core_info of stub : architecture is "blk_mem_gen_v8_4_5,Vivado 2022.1";
begin
end;
