JPirman/FPGA_polarimeter/Encoder_sampling/Vivado/Encoder_sampler.gen/sources_1/bd/Main/ip/Main_axi_bram_ctrl_0_bram_0/Main_axi_bram_ctrl_0_bram_0_stub.v

// Copyright 1986-2022 Xilinx, Inc. All Rights Reserved.
// --------------------------------------------------------------------------------
// Tool Version: Vivado v.2022.1 (lin64) Build 3526262 Mon Apr 18 15:47:01 MDT 2022
// Date        : Thu Jul 14 21:59:08 2022
// Host        : Jure-Linux running 64-bit Linux Mint 20.3
// Command     : write_verilog -force -mode synth_stub
//               /home/jure/Dokumenti/Xilinx/Polarimeter/Encoder_sampler/Encoder_sampler.gen/sources_1/bd/Main/ip/Main_axi_bram_ctrl_0_bram_0/Main_axi_bram_ctrl_0_bram_0_stub.v
// Design      : Main_axi_bram_ctrl_0_bram_0
// Purpose     : Stub declaration of top-level module interface
// Device      : xc7s25csga324-1
// --------------------------------------------------------------------------------

// This empty module with port declaration file causes synthesis tools to infer a black box for IP.
// The synthesis directives are for Synopsys Synplify support to prevent IO buffer insertion.
// Please paste the declaration into a Verilog source file or add the file as an additional source.
(* x_core_info = "blk_mem_gen_v8_4_5,Vivado 2022.1" *)
module Main_axi_bram_ctrl_0_bram_0(clka, rsta, ena, wea, addra, dina, douta, clkb, rstb, enb, 
  web, addrb, dinb, doutb, rsta_busy, rstb_busy)
/* synthesis syn_black_box black_box_pad_pin="clka,rsta,ena,wea[3:0],addra[31:0],dina[31:0],douta[31:0],clkb,rstb,enb,web[3:0],addrb[31:0],dinb[31:0],doutb[31:0],rsta_busy,rstb_busy" */;
  input clka;
  input rsta;
  input ena;
  input [3:0]wea;
  input [31:0]addra;
  input [31:0]dina;
  output [31:0]douta;
  input clkb;
  input rstb;
  input enb;
  input [3:0]web;
  input [31:0]addrb;
  input [31:0]dinb;
  output [31:0]doutb;
  output rsta_busy;
  output rstb_busy;
endmodule
