JPirman/FPGA_polarimeter/Polarimeter_core/Vivado/Polarimeter_Microblaze.cache/ip/2022.1/2/2/22051269e59579df/Main_DSP_controller_0_1_sim_netlist.v

// Copyright 1986-2022 Xilinx, Inc. All Rights Reserved.
// --------------------------------------------------------------------------------
// Tool Version: Vivado v.2022.1 (lin64) Build 3526262 Mon Apr 18 15:47:01 MDT 2022
// Date        : Fri Jul  8 19:30:25 2022
// Host        : Jure-Linux running 64-bit Linux Mint 20.3
// Command     : write_verilog -force -mode funcsim -rename_top decalper_eb_ot_sdeen_pot_pi_dehcac_xnilix -prefix
//               decalper_eb_ot_sdeen_pot_pi_dehcac_xnilix_ Main_DSP_controller_0_1_sim_netlist.v
// Design      : Main_DSP_controller_0_1
// Purpose     : This verilog netlist is a functional simulation representation of the design and should not be modified
//               or synthesized. This netlist cannot be used for SDF annotated simulation.
// Device      : xc7s25csga324-1
// --------------------------------------------------------------------------------
`timescale 1 ps / 1 ps

module decalper_eb_ot_sdeen_pot_pi_dehcac_xnilix_DSP_controller
   (madd_sin1f_b,
    madd_cos1f_b,
    madd_sin2f_b,
    madd_cos2f_b,
    adc_data,
    m0_axis_phase_tdata,
    data_ready_o,
    m1_axis_phase_tvalid,
    encoder_cnt_i,
    fpga_clk_i,
    s0_axis_data_tdata,
    s1_axis_data_tdata,
    adc_data_i,
    s1_axis_data_tvalid,
    s0_axis_data_tvalid,
    nres_i,
    adc_data_ready_i);
  output [15:0]madd_sin1f_b;
  output [15:0]madd_cos1f_b;
  output [15:0]madd_sin2f_b;
  output [15:0]madd_cos2f_b;
  output [15:0]adc_data;
  output [9:0]m0_axis_phase_tdata;
  output data_ready_o;
  output m1_axis_phase_tvalid;
  input [10:0]encoder_cnt_i;
  input fpga_clk_i;
  input [31:0]s0_axis_data_tdata;
  input [31:0]s1_axis_data_tdata;
  input [15:0]adc_data_i;
  input s1_axis_data_tvalid;
  input s0_axis_data_tvalid;
  input nres_i;
  input adc_data_ready_i;

  wire [15:0]adc_data;
  wire \adc_data[15]_i_1_n_0 ;
  wire [15:0]adc_data_i;
  wire adc_data_ready_i;
  wire adc_has_data;
  wire adc_has_data_i_1_n_0;
  wire clear;
  wire cnt_lsb_del;
  wire cphase;
  wire cpos0;
  wire \cpos0_inferred__0/i__carry_n_1 ;
  wire \cpos0_inferred__0/i__carry_n_2 ;
  wire \cpos0_inferred__0/i__carry_n_3 ;
  wire \cpos[9]_i_2_n_0 ;
  wire \cpos[9]_i_4_n_0 ;
  wire [9:0]cpos_reg;
  wire data_ready_o;
  wire data_ready_o_i_1_n_0;
  wire data_ready_o_i_2_n_0;
  wire data_ready_o_i_3_n_0;
  wire [10:0]encoder_cnt_i;
  wire fpga_clk_i;
  wire i__carry_i_1_n_0;
  wire i__carry_i_2_n_0;
  wire i__carry_i_3_n_0;
  wire i__carry_i_4_n_0;
  wire idle;
  wire idle_i_1_n_0;
  wire [9:0]m0_axis_phase_tdata;
  wire m1_axis_phase_tvalid;
  wire m_axis_tvalid_i_1_n_0;
  wire m_axis_tvalid_i_2_n_0;
  wire m_axis_tvalid_i_3_n_0;
  wire [15:0]madd_cos1f_b;
  wire [15:0]madd_cos2f_b;
  wire [15:0]madd_sin1f_b;
  wire \madd_sin1f_b[15]_i_1_n_0 ;
  wire [15:0]madd_sin2f_b;
  wire nres_i;
  wire [9:0]p_0_in;
  wire [31:0]s0_axis_data_tdata;
  wire s0_axis_data_tvalid;
  wire [31:0]s1_axis_data_tdata;
  wire s1_axis_data_tvalid;
  wire [3:0]\NLW_cpos0_inferred__0/i__carry_O_UNCONNECTED ;

  LUT6 #(
    .INIT(64'hFFFF000020000000)) 
    \adc_data[15]_i_1 
       (.I0(adc_has_data),
        .I1(idle),
        .I2(s0_axis_data_tvalid),
        .I3(s1_axis_data_tvalid),
        .I4(nres_i),
        .I5(adc_data_ready_i),
        .O(\adc_data[15]_i_1_n_0 ));
  FDRE \adc_data_reg[0] 
       (.C(fpga_clk_i),
        .CE(\adc_data[15]_i_1_n_0 ),
        .D(adc_data_i[0]),
        .Q(adc_data[0]),
        .R(1'b0));
  FDRE \adc_data_reg[10] 
       (.C(fpga_clk_i),
        .CE(\adc_data[15]_i_1_n_0 ),
        .D(adc_data_i[10]),
        .Q(adc_data[10]),
        .R(1'b0));
  FDRE \adc_data_reg[11] 
       (.C(fpga_clk_i),
        .CE(\adc_data[15]_i_1_n_0 ),
        .D(adc_data_i[11]),
        .Q(adc_data[11]),
        .R(1'b0));
  FDRE \adc_data_reg[12] 
       (.C(fpga_clk_i),
        .CE(\adc_data[15]_i_1_n_0 ),
        .D(adc_data_i[12]),
        .Q(adc_data[12]),
        .R(1'b0));
  FDRE \adc_data_reg[13] 
       (.C(fpga_clk_i),
        .CE(\adc_data[15]_i_1_n_0 ),
        .D(adc_data_i[13]),
        .Q(adc_data[13]),
        .R(1'b0));
  FDRE \adc_data_reg[14] 
       (.C(fpga_clk_i),
        .CE(\adc_data[15]_i_1_n_0 ),
        .D(adc_data_i[14]),
        .Q(adc_data[14]),
        .R(1'b0));
  FDRE \adc_data_reg[15] 
       (.C(fpga_clk_i),
        .CE(\adc_data[15]_i_1_n_0 ),
        .D(adc_data_i[15]),
        .Q(adc_data[15]),
        .R(1'b0));
  FDRE \adc_data_reg[1] 
       (.C(fpga_clk_i),
        .CE(\adc_data[15]_i_1_n_0 ),
        .D(adc_data_i[1]),
        .Q(adc_data[1]),
        .R(1'b0));
  FDRE \adc_data_reg[2] 
       (.C(fpga_clk_i),
        .CE(\adc_data[15]_i_1_n_0 ),
        .D(adc_data_i[2]),
        .Q(adc_data[2]),
        .R(1'b0));
  FDRE \adc_data_reg[3] 
       (.C(fpga_clk_i),
        .CE(\adc_data[15]_i_1_n_0 ),
        .D(adc_data_i[3]),
        .Q(adc_data[3]),
        .R(1'b0));
  FDRE \adc_data_reg[4] 
       (.C(fpga_clk_i),
        .CE(\adc_data[15]_i_1_n_0 ),
        .D(adc_data_i[4]),
        .Q(adc_data[4]),
        .R(1'b0));
  FDRE \adc_data_reg[5] 
       (.C(fpga_clk_i),
        .CE(\adc_data[15]_i_1_n_0 ),
        .D(adc_data_i[5]),
        .Q(adc_data[5]),
        .R(1'b0));
  FDRE \adc_data_reg[6] 
       (.C(fpga_clk_i),
        .CE(\adc_data[15]_i_1_n_0 ),
        .D(adc_data_i[6]),
        .Q(adc_data[6]),
        .R(1'b0));
  FDRE \adc_data_reg[7] 
       (.C(fpga_clk_i),
        .CE(\adc_data[15]_i_1_n_0 ),
        .D(adc_data_i[7]),
        .Q(adc_data[7]),
        .R(1'b0));
  FDRE \adc_data_reg[8] 
       (.C(fpga_clk_i),
        .CE(\adc_data[15]_i_1_n_0 ),
        .D(adc_data_i[8]),
        .Q(adc_data[8]),
        .R(1'b0));
  FDRE \adc_data_reg[9] 
       (.C(fpga_clk_i),
        .CE(\adc_data[15]_i_1_n_0 ),
        .D(adc_data_i[9]),
        .Q(adc_data[9]),
        .R(1'b0));
  LUT3 #(
    .INIT(8'hE0)) 
    adc_has_data_i_1
       (.I0(adc_has_data),
        .I1(adc_data_ready_i),
        .I2(nres_i),
        .O(adc_has_data_i_1_n_0));
  FDRE #(
    .INIT(1'b0)) 
    adc_has_data_reg
       (.C(fpga_clk_i),
        .CE(1'b1),
        .D(adc_has_data_i_1_n_0),
        .Q(adc_has_data),
        .R(1'b0));
  FDRE cnt_lsb_del_reg
       (.C(fpga_clk_i),
        .CE(1'b1),
        .D(encoder_cnt_i[0]),
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
        .Q(data_ready_o),
        .R(1'b0));
  LUT3 #(
    .INIT(8'h09)) 
    i__carry_i_1
       (.I0(cpos_reg[9]),
        .I1(encoder_cnt_i[9]),
        .I2(encoder_cnt_i[10]),
        .O(i__carry_i_1_n_0));
  LUT6 #(
    .INIT(64'h9009000000009009)) 
    i__carry_i_2
       (.I0(encoder_cnt_i[8]),
        .I1(cpos_reg[8]),
        .I2(encoder_cnt_i[7]),
        .I3(cpos_reg[7]),
        .I4(cpos_reg[6]),
        .I5(encoder_cnt_i[6]),
        .O(i__carry_i_2_n_0));
  LUT6 #(
    .INIT(64'h9009000000009009)) 
    i__carry_i_3
       (.I0(encoder_cnt_i[5]),
        .I1(cpos_reg[5]),
        .I2(encoder_cnt_i[4]),
        .I3(cpos_reg[4]),
        .I4(cpos_reg[3]),
        .I5(encoder_cnt_i[3]),
        .O(i__carry_i_3_n_0));
  LUT6 #(
    .INIT(64'h9009000000009009)) 
    i__carry_i_4
       (.I0(encoder_cnt_i[2]),
        .I1(cpos_reg[2]),
        .I2(encoder_cnt_i[1]),
        .I3(cpos_reg[1]),
        .I4(cpos_reg[0]),
        .I5(encoder_cnt_i[0]),
        .O(i__carry_i_4_n_0));
  (* SOFT_HLUTNM = "soft_lutpair2" *) 
  LUT5 #(
    .INIT(32'h82AAFFFF)) 
    idle_i_1
       (.I0(idle),
        .I1(encoder_cnt_i[0]),
        .I2(cnt_lsb_del),
        .I3(cpos0),
        .I4(nres_i),
        .O(idle_i_1_n_0));
  FDRE #(
    .INIT(1'b1)) 
    idle_reg
       (.C(fpga_clk_i),
        .CE(1'b1),
        .D(idle_i_1_n_0),
        .Q(idle),
        .R(1'b0));
  LUT6 #(
    .INIT(64'hFE22022200000000)) 
    m_axis_tvalid_i_1
       (.I0(m1_axis_phase_tvalid),
        .I1(m_axis_tvalid_i_2_n_0),
        .I2(m_axis_tvalid_i_3_n_0),
        .I3(cpos0),
        .I4(idle),
        .I5(nres_i),
        .O(m_axis_tvalid_i_1_n_0));
  LUT4 #(
    .INIT(16'h0800)) 
    m_axis_tvalid_i_2
       (.I0(s0_axis_data_tvalid),
        .I1(s1_axis_data_tvalid),
        .I2(idle),
        .I3(adc_has_data),
        .O(m_axis_tvalid_i_2_n_0));
  (* SOFT_HLUTNM = "soft_lutpair2" *) 
  LUT3 #(
    .INIT(8'h60)) 
    m_axis_tvalid_i_3
       (.I0(cnt_lsb_del),
        .I1(encoder_cnt_i[0]),
        .I2(idle),
        .O(m_axis_tvalid_i_3_n_0));
  FDRE #(
    .INIT(1'b0)) 
    m_axis_tvalid_reg
       (.C(fpga_clk_i),
        .CE(1'b1),
        .D(m_axis_tvalid_i_1_n_0),
        .Q(m1_axis_phase_tvalid),
        .R(1'b0));
  FDRE \madd_cos1f_b_reg[0] 
       (.C(fpga_clk_i),
        .CE(\madd_sin1f_b[15]_i_1_n_0 ),
        .D(s0_axis_data_tdata[0]),
        .Q(madd_cos1f_b[0]),
        .R(1'b0));
  FDRE \madd_cos1f_b_reg[10] 
       (.C(fpga_clk_i),
        .CE(\madd_sin1f_b[15]_i_1_n_0 ),
        .D(s0_axis_data_tdata[10]),
        .Q(madd_cos1f_b[10]),
        .R(1'b0));
  FDRE \madd_cos1f_b_reg[11] 
       (.C(fpga_clk_i),
        .CE(\madd_sin1f_b[15]_i_1_n_0 ),
        .D(s0_axis_data_tdata[11]),
        .Q(madd_cos1f_b[11]),
        .R(1'b0));
  FDRE \madd_cos1f_b_reg[12] 
       (.C(fpga_clk_i),
        .CE(\madd_sin1f_b[15]_i_1_n_0 ),
        .D(s0_axis_data_tdata[12]),
        .Q(madd_cos1f_b[12]),
        .R(1'b0));
  FDRE \madd_cos1f_b_reg[13] 
       (.C(fpga_clk_i),
        .CE(\madd_sin1f_b[15]_i_1_n_0 ),
        .D(s0_axis_data_tdata[13]),
        .Q(madd_cos1f_b[13]),
        .R(1'b0));
  FDRE \madd_cos1f_b_reg[14] 
       (.C(fpga_clk_i),
        .CE(\madd_sin1f_b[15]_i_1_n_0 ),
        .D(s0_axis_data_tdata[14]),
        .Q(madd_cos1f_b[14]),
        .R(1'b0));
  FDRE \madd_cos1f_b_reg[15] 
       (.C(fpga_clk_i),
        .CE(\madd_sin1f_b[15]_i_1_n_0 ),
        .D(s0_axis_data_tdata[15]),
        .Q(madd_cos1f_b[15]),
        .R(1'b0));
  FDRE \madd_cos1f_b_reg[1] 
       (.C(fpga_clk_i),
        .CE(\madd_sin1f_b[15]_i_1_n_0 ),
        .D(s0_axis_data_tdata[1]),
        .Q(madd_cos1f_b[1]),
        .R(1'b0));
  FDRE \madd_cos1f_b_reg[2] 
       (.C(fpga_clk_i),
        .CE(\madd_sin1f_b[15]_i_1_n_0 ),
        .D(s0_axis_data_tdata[2]),
        .Q(madd_cos1f_b[2]),
        .R(1'b0));
  FDRE \madd_cos1f_b_reg[3] 
       (.C(fpga_clk_i),
        .CE(\madd_sin1f_b[15]_i_1_n_0 ),
        .D(s0_axis_data_tdata[3]),
        .Q(madd_cos1f_b[3]),
        .R(1'b0));
  FDRE \madd_cos1f_b_reg[4] 
       (.C(fpga_clk_i),
        .CE(\madd_sin1f_b[15]_i_1_n_0 ),
        .D(s0_axis_data_tdata[4]),
        .Q(madd_cos1f_b[4]),
        .R(1'b0));
  FDRE \madd_cos1f_b_reg[5] 
       (.C(fpga_clk_i),
        .CE(\madd_sin1f_b[15]_i_1_n_0 ),
        .D(s0_axis_data_tdata[5]),
        .Q(madd_cos1f_b[5]),
        .R(1'b0));
  FDRE \madd_cos1f_b_reg[6] 
       (.C(fpga_clk_i),
        .CE(\madd_sin1f_b[15]_i_1_n_0 ),
        .D(s0_axis_data_tdata[6]),
        .Q(madd_cos1f_b[6]),
        .R(1'b0));
  FDRE \madd_cos1f_b_reg[7] 
       (.C(fpga_clk_i),
        .CE(\madd_sin1f_b[15]_i_1_n_0 ),
        .D(s0_axis_data_tdata[7]),
        .Q(madd_cos1f_b[7]),
        .R(1'b0));
  FDRE \madd_cos1f_b_reg[8] 
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
        .D(s1_axis_data_tdata[24]),
        .Q(madd_sin2f_b[8]),
        .R(1'b0));
  FDRE \madd_sin2f_b_reg[9] 
       (.C(fpga_clk_i),
        .CE(\madd_sin1f_b[15]_i_1_n_0 ),
        .D(s1_axis_data_tdata[25]),
        .Q(madd_sin2f_b[9]),
        .R(1'b0));
endmodule

(* CHECK_LICENSE_TYPE = "Main_DSP_controller_0_1,DSP_controller,{}" *) (* DowngradeIPIdentifiedWarnings = "yes" *) (* IP_DEFINITION_SOURCE = "module_ref" *) 
(* X_CORE_INFO = "DSP_controller,Vivado 2022.1" *) 
(* NotValidForBitStream *)
module decalper_eb_ot_sdeen_pot_pi_dehcac_xnilix
   (fpga_clk_i,
    nres_i,
    adc_data_ready_i,
    encoder_cnt_i,
    adc_data_i,
    madd_sin1f_p,
    madd_cos1f_p,
    madd_sin2f_p,
    madd_cos2f_p,
    add_s,
    madd_sin1f_c,
    madd_cos1f_c,
    madd_sin2f_c,
    madd_cos2f_c,
    madd_sin1f_b,
    madd_cos1f_b,
    madd_sin2f_b,
    madd_cos2f_b,
    add_b,
    adc_data,
    res_0f,
    res_sin1f,
    res_cos1f,
    res_sin2f,
    res_cos2f,
    m0_axis_phase_tdata,
    m0_axis_phase_tvalid,
    s0_axis_data_tdata,
    s0_axis_data_tvalid,
    m1_axis_phase_tdata,
    m1_axis_phase_tvalid,
    s1_axis_data_tdata,
    s1_axis_data_tvalid,
    data_ready_o);
  input fpga_clk_i;
  input nres_i;
  input adc_data_ready_i;
  input [10:0]encoder_cnt_i;
  input [15:0]adc_data_i;
  input [47:0]madd_sin1f_p;
  input [47:0]madd_cos1f_p;
  input [47:0]madd_sin2f_p;
  input [47:0]madd_cos2f_p;
  input [31:0]add_s;
  output [47:0]madd_sin1f_c;
  output [47:0]madd_cos1f_c;
  output [47:0]madd_sin2f_c;
  output [47:0]madd_cos2f_c;
  output [15:0]madd_sin1f_b;
  output [15:0]madd_cos1f_b;
  output [15:0]madd_sin2f_b;
  output [15:0]madd_cos2f_b;
  output [31:0]add_b;
  output [15:0]adc_data;
  output [31:0]res_0f;
  output [47:0]res_sin1f;
  output [47:0]res_cos1f;
  output [47:0]res_sin2f;
  output [47:0]res_cos2f;
  (* X_INTERFACE_INFO = "xilinx.com:interface:axis:1.0 m0_axis_phase TDATA" *) output [15:0]m0_axis_phase_tdata;
  (* X_INTERFACE_INFO = "xilinx.com:interface:axis:1.0 m0_axis_phase TVALID" *) (* X_INTERFACE_PARAMETER = "XIL_INTERFACENAME m0_axis_phase, TDATA_NUM_BYTES 2, TDEST_WIDTH 0, TID_WIDTH 0, TUSER_WIDTH 0, HAS_TREADY 0, HAS_TSTRB 0, HAS_TKEEP 0, HAS_TLAST 0, FREQ_HZ 100000000, PHASE 0.0, LAYERED_METADATA undef, INSERT_VIP 0" *) output m0_axis_phase_tvalid;
  (* X_INTERFACE_INFO = "xilinx.com:interface:axis:1.0 s0_axis_data TDATA" *) input [31:0]s0_axis_data_tdata;
  (* X_INTERFACE_INFO = "xilinx.com:interface:axis:1.0 s0_axis_data TVALID" *) (* X_INTERFACE_PARAMETER = "XIL_INTERFACENAME s0_axis_data, TDATA_NUM_BYTES 4, TDEST_WIDTH 0, TID_WIDTH 0, TUSER_WIDTH 0, HAS_TREADY 0, HAS_TSTRB 0, HAS_TKEEP 0, HAS_TLAST 0, FREQ_HZ 100000000, PHASE 0.0, LAYERED_METADATA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
  (* X_INTERFACE_INFO = "xilinx.com:interface:axis:1.0 m1_axis_phase TDATA" *) output [15:0]m1_axis_phase_tdata;
  (* X_INTERFACE_INFO = "xilinx.com:interface:axis:1.0 m1_axis_phase TVALID" *) (* X_INTERFACE_PARAMETER = "XIL_INTERFACENAME m1_axis_phase, TDATA_NUM_BYTES 2, TDEST_WIDTH 0, TID_WIDTH 0, TUSER_WIDTH 0, HAS_TREADY 0, HAS_TSTRB 0, HAS_TKEEP 0, HAS_TLAST 0, FREQ_HZ 100000000, PHASE 0.0, LAYERED_METADATA undef, INSERT_VIP 0" *) output m1_axis_phase_tvalid;
  (* X_INTERFACE_INFO = "xilinx.com:interface:axis:1.0 s1_axis_data TDATA" *) input [31:0]s1_axis_data_tdata;
  (* X_INTERFACE_INFO = "xilinx.com:interface:axis:1.0 s1_axis_data TVALID" *) (* X_INTERFACE_PARAMETER = "XIL_INTERFACENAME s1_axis_data, TDATA_NUM_BYTES 4, TDEST_WIDTH 0, TID_WIDTH 0, TUSER_WIDTH 0, HAS_TREADY 0, HAS_TSTRB 0, HAS_TKEEP 0, HAS_TLAST 0, FREQ_HZ 100000000, PHASE 0.0, LAYERED_METADATA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
  output data_ready_o;

  wire \<const0> ;
  wire [15:0]adc_data;
  wire [15:0]adc_data_i;
  wire adc_data_ready_i;
  wire data_ready_o;
  wire [10:0]encoder_cnt_i;
  wire fpga_clk_i;
  wire [9:9]\^m0_axis_phase_tdata ;
  wire [8:0]\^m1_axis_phase_tdata ;
  wire m1_axis_phase_tvalid;
  wire [15:0]madd_cos1f_b;
  wire [15:0]madd_cos2f_b;
  wire [15:0]madd_sin1f_b;
  wire [15:0]madd_sin2f_b;
  wire nres_i;
  wire [31:0]s0_axis_data_tdata;
  wire s0_axis_data_tvalid;
  wire [31:0]s1_axis_data_tdata;
  wire s1_axis_data_tvalid;

  assign add_b[31] = \<const0> ;
  assign add_b[30] = \<const0> ;
  assign add_b[29] = \<const0> ;
  assign add_b[28] = \<const0> ;
  assign add_b[27] = \<const0> ;
  assign add_b[26] = \<const0> ;
  assign add_b[25] = \<const0> ;
  assign add_b[24] = \<const0> ;
  assign add_b[23] = \<const0> ;
  assign add_b[22] = \<const0> ;
  assign add_b[21] = \<const0> ;
  assign add_b[20] = \<const0> ;
  assign add_b[19] = \<const0> ;
  assign add_b[18] = \<const0> ;
  assign add_b[17] = \<const0> ;
  assign add_b[16] = \<const0> ;
  assign add_b[15] = \<const0> ;
  assign add_b[14] = \<const0> ;
  assign add_b[13] = \<const0> ;
  assign add_b[12] = \<const0> ;
  assign add_b[11] = \<const0> ;
  assign add_b[10] = \<const0> ;
  assign add_b[9] = \<const0> ;
  assign add_b[8] = \<const0> ;
  assign add_b[7] = \<const0> ;
  assign add_b[6] = \<const0> ;
  assign add_b[5] = \<const0> ;
  assign add_b[4] = \<const0> ;
  assign add_b[3] = \<const0> ;
  assign add_b[2] = \<const0> ;
  assign add_b[1] = \<const0> ;
  assign add_b[0] = \<const0> ;
  assign m0_axis_phase_tdata[15] = \<const0> ;
  assign m0_axis_phase_tdata[14] = \<const0> ;
  assign m0_axis_phase_tdata[13] = \<const0> ;
  assign m0_axis_phase_tdata[12] = \<const0> ;
  assign m0_axis_phase_tdata[11] = \<const0> ;
  assign m0_axis_phase_tdata[10] = \<const0> ;
  assign m0_axis_phase_tdata[9] = \^m0_axis_phase_tdata [9];
  assign m0_axis_phase_tdata[8:0] = \^m1_axis_phase_tdata [8:0];
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
  assign res_sin1f[34] = \<const0> ;
  assign res_sin1f[33] = \<const0> ;
  assign res_sin1f[32] = \<const0> ;
  assign res_sin1f[31] = \<const0> ;
  assign res_sin1f[30] = \<const0> ;
  assign res_sin1f[29] = \<const0> ;
  assign res_sin1f[28] = \<const0> ;
  assign res_sin1f[27] = \<const0> ;
  assign res_sin1f[26] = \<const0> ;
  assign res_sin1f[25] = \<const0> ;
  assign res_sin1f[24] = \<const0> ;
  assign res_sin1f[23] = \<const0> ;
  assign res_sin1f[22] = \<const0> ;
  assign res_sin1f[21] = \<const0> ;
  assign res_sin1f[20] = \<const0> ;
  assign res_sin1f[19] = \<const0> ;
  assign res_sin1f[18] = \<const0> ;
  assign res_sin1f[17] = \<const0> ;
  assign res_sin1f[16] = \<const0> ;
  assign res_sin1f[15] = \<const0> ;
  assign res_sin1f[14] = \<const0> ;
  assign res_sin1f[13] = \<const0> ;
  assign res_sin1f[12] = \<const0> ;
  assign res_sin1f[11] = \<const0> ;
  assign res_sin1f[10] = \<const0> ;
  assign res_sin1f[9] = \<const0> ;
  assign res_sin1f[8] = \<const0> ;
  assign res_sin1f[7] = \<const0> ;
  assign res_sin1f[6] = \<const0> ;
  assign res_sin1f[5] = \<const0> ;
  assign res_sin1f[4] = \<const0> ;
  assign res_sin1f[3] = \<const0> ;
  assign res_sin1f[2] = \<const0> ;
  assign res_sin1f[1] = \<const0> ;
  assign res_sin1f[0] = \<const0> ;
  assign res_sin2f[47] = \<const0> ;
  assign res_sin2f[46] = \<const0> ;
  assign res_sin2f[45] = \<const0> ;
  assign res_sin2f[44] = \<const0> ;
  assign res_sin2f[43] = \<const0> ;
  assign res_sin2f[42] = \<const0> ;
  assign res_sin2f[41] = \<const0> ;
  assign res_sin2f[40] = \<const0> ;
  assign res_sin2f[39] = \<const0> ;
  assign res_sin2f[38] = \<const0> ;
  assign res_sin2f[37] = \<const0> ;
  assign res_sin2f[36] = \<const0> ;
  assign res_sin2f[35] = \<const0> ;
  assign res_sin2f[34] = \<const0> ;
  assign res_sin2f[33] = \<const0> ;
  assign res_sin2f[32] = \<const0> ;
  assign res_sin2f[31] = \<const0> ;
  assign res_sin2f[30] = \<const0> ;
  assign res_sin2f[29] = \<const0> ;
  assign res_sin2f[28] = \<const0> ;
  assign res_sin2f[27] = \<const0> ;
  assign res_sin2f[26] = \<const0> ;
  assign res_sin2f[25] = \<const0> ;
  assign res_sin2f[24] = \<const0> ;
  assign res_sin2f[23] = \<const0> ;
  assign res_sin2f[22] = \<const0> ;
  assign res_sin2f[21] = \<const0> ;
  assign res_sin2f[20] = \<const0> ;
  assign res_sin2f[19] = \<const0> ;
  assign res_sin2f[18] = \<const0> ;
  assign res_sin2f[17] = \<const0> ;
  assign res_sin2f[16] = \<const0> ;
  assign res_sin2f[15] = \<const0> ;
  assign res_sin2f[14] = \<const0> ;
  assign res_sin2f[13] = \<const0> ;
  assign res_sin2f[12] = \<const0> ;
  assign res_sin2f[11] = \<const0> ;
  assign res_sin2f[10] = \<const0> ;
  assign res_sin2f[9] = \<const0> ;
  assign res_sin2f[8] = \<const0> ;
  assign res_sin2f[7] = \<const0> ;
  assign res_sin2f[6] = \<const0> ;
  assign res_sin2f[5] = \<const0> ;
  assign res_sin2f[4] = \<const0> ;
  assign res_sin2f[3] = \<const0> ;
  assign res_sin2f[2] = \<const0> ;
  assign res_sin2f[1] = \<const0> ;
  assign res_sin2f[0] = \<const0> ;
  GND GND
       (.G(\<const0> ));
  decalper_eb_ot_sdeen_pot_pi_dehcac_xnilix_DSP_controller inst
       (.adc_data(adc_data),
        .adc_data_i(adc_data_i),
        .adc_data_ready_i(adc_data_ready_i),
        .data_ready_o(data_ready_o),
        .encoder_cnt_i(encoder_cnt_i),
        .fpga_clk_i(fpga_clk_i),
        .m0_axis_phase_tdata({\^m0_axis_phase_tdata ,\^m1_axis_phase_tdata }),
        .m1_axis_phase_tvalid(m1_axis_phase_tvalid),
        .madd_cos1f_b(madd_cos1f_b),
        .madd_cos2f_b(madd_cos2f_b),
        .madd_sin1f_b(madd_sin1f_b),
        .madd_sin2f_b(madd_sin2f_b),
        .nres_i(nres_i),
        .s0_axis_data_tdata(s0_axis_data_tdata),
        .s0_axis_data_tvalid(s0_axis_data_tvalid),
        .s1_axis_data_tdata(s1_axis_data_tdata),
        .s1_axis_data_tvalid(s1_axis_data_tvalid));
endmodule
`ifndef GLBL
`define GLBL
`timescale  1 ps / 1 ps

module glbl ();

    parameter ROC_WIDTH = 100000;
    parameter TOC_WIDTH = 0;
    parameter GRES_WIDTH = 10000;
    parameter GRES_START = 10000;

//--------   STARTUP Globals --------------
    wire GSR;
    wire GTS;
    wire GWE;
    wire PRLD;
    wire GRESTORE;
    tri1 p_up_tmp;
    tri (weak1, strong0) PLL_LOCKG = p_up_tmp;

    wire PROGB_GLBL;
    wire CCLKO_GLBL;
    wire FCSBO_GLBL;
    wire [3:0] DO_GLBL;
    wire [3:0] DI_GLBL;
   
    reg GSR_int;
    reg GTS_int;
    reg PRLD_int;
    reg GRESTORE_int;

//--------   JTAG Globals --------------
    wire JTAG_TDO_GLBL;
    wire JTAG_TCK_GLBL;
    wire JTAG_TDI_GLBL;
    wire JTAG_TMS_GLBL;
    wire JTAG_TRST_GLBL;

    reg JTAG_CAPTURE_GLBL;
    reg JTAG_RESET_GLBL;
    reg JTAG_SHIFT_GLBL;
    reg JTAG_UPDATE_GLBL;
    reg JTAG_RUNTEST_GLBL;

    reg JTAG_SEL1_GLBL = 0;
    reg JTAG_SEL2_GLBL = 0 ;
    reg JTAG_SEL3_GLBL = 0;
    reg JTAG_SEL4_GLBL = 0;

    reg JTAG_USER_TDO1_GLBL = 1'bz;
    reg JTAG_USER_TDO2_GLBL = 1'bz;
    reg JTAG_USER_TDO3_GLBL = 1'bz;
    reg JTAG_USER_TDO4_GLBL = 1'bz;

    assign (strong1, weak0) GSR = GSR_int;
    assign (strong1, weak0) GTS = GTS_int;
    assign (weak1, weak0) PRLD = PRLD_int;
    assign (strong1, weak0) GRESTORE = GRESTORE_int;

    initial begin
	GSR_int = 1'b1;
	PRLD_int = 1'b1;
	#(ROC_WIDTH)
	GSR_int = 1'b0;
	PRLD_int = 1'b0;
    end

    initial begin
	GTS_int = 1'b1;
	#(TOC_WIDTH)
	GTS_int = 1'b0;
    end

    initial begin 
	GRESTORE_int = 1'b0;
	#(GRES_START);
	GRESTORE_int = 1'b1;
	#(GRES_WIDTH);
	GRESTORE_int = 1'b0;
    end

endmodule
`endif
