JPirman/FPGA_polarimeter/Polarimeter_core/Vivado/Polarimeter_Microblaze.cache/ip/2022.1/2/2/22051269e59579df/Main_DSP_controller_0_1_sim_netlist.vhdl

-- Copyright 1986-2022 Xilinx, Inc. All Rights Reserved.
-- --------------------------------------------------------------------------------
-- Tool Version: Vivado v.2022.1 (lin64) Build 3526262 Mon Apr 18 15:47:01 MDT 2022
-- Date        : Fri Jul  8 19:30:25 2022
-- Host        : Jure-Linux running 64-bit Linux Mint 20.3
-- Command     : write_vhdl -force -mode funcsim -rename_top decalper_eb_ot_sdeen_pot_pi_dehcac_xnilix -prefix
--               decalper_eb_ot_sdeen_pot_pi_dehcac_xnilix_ Main_DSP_controller_0_1_sim_netlist.vhdl
-- Design      : Main_DSP_controller_0_1
-- Purpose     : This VHDL netlist is a functional simulation representation of the design and should not be modified or
--               synthesized. This netlist cannot be used for SDF annotated simulation.
-- Device      : xc7s25csga324-1
-- --------------------------------------------------------------------------------
library IEEE;
use IEEE.STD_LOGIC_1164.ALL;
library UNISIM;
use UNISIM.VCOMPONENTS.ALL;
entity decalper_eb_ot_sdeen_pot_pi_dehcac_xnilix_DSP_controller is
  port (
    madd_sin1f_b : out STD_LOGIC_VECTOR ( 15 downto 0 );
    madd_cos1f_b : out STD_LOGIC_VECTOR ( 15 downto 0 );
    madd_sin2f_b : out STD_LOGIC_VECTOR ( 15 downto 0 );
    madd_cos2f_b : out STD_LOGIC_VECTOR ( 15 downto 0 );
    adc_data : out STD_LOGIC_VECTOR ( 15 downto 0 );
    m0_axis_phase_tdata : out STD_LOGIC_VECTOR ( 9 downto 0 );
    data_ready_o : out STD_LOGIC;
    m1_axis_phase_tvalid : out STD_LOGIC;
    encoder_cnt_i : in STD_LOGIC_VECTOR ( 10 downto 0 );
    fpga_clk_i : in STD_LOGIC;
    s0_axis_data_tdata : in STD_LOGIC_VECTOR ( 31 downto 0 );
    s1_axis_data_tdata : in STD_LOGIC_VECTOR ( 31 downto 0 );
    adc_data_i : in STD_LOGIC_VECTOR ( 15 downto 0 );
    s1_axis_data_tvalid : in STD_LOGIC;
    s0_axis_data_tvalid : in STD_LOGIC;
    nres_i : in STD_LOGIC;
    adc_data_ready_i : in STD_LOGIC
  );
end decalper_eb_ot_sdeen_pot_pi_dehcac_xnilix_DSP_controller;

architecture STRUCTURE of decalper_eb_ot_sdeen_pot_pi_dehcac_xnilix_DSP_controller is
  signal \adc_data[15]_i_1_n_0\ : STD_LOGIC;
  signal adc_has_data : STD_LOGIC;
  signal adc_has_data_i_1_n_0 : STD_LOGIC;
  signal clear : STD_LOGIC;
  signal cnt_lsb_del : STD_LOGIC;
  signal cphase : STD_LOGIC;
  signal cpos0 : STD_LOGIC;
  signal \cpos0_inferred__0/i__carry_n_1\ : STD_LOGIC;
  signal \cpos0_inferred__0/i__carry_n_2\ : STD_LOGIC;
  signal \cpos0_inferred__0/i__carry_n_3\ : STD_LOGIC;
  signal \cpos[9]_i_2_n_0\ : STD_LOGIC;
  signal \cpos[9]_i_4_n_0\ : STD_LOGIC;
  signal cpos_reg : STD_LOGIC_VECTOR ( 9 downto 0 );
  signal \^data_ready_o\ : STD_LOGIC;
  signal data_ready_o_i_1_n_0 : STD_LOGIC;
  signal data_ready_o_i_2_n_0 : STD_LOGIC;
  signal data_ready_o_i_3_n_0 : STD_LOGIC;
  signal \i__carry_i_1_n_0\ : STD_LOGIC;
  signal \i__carry_i_2_n_0\ : STD_LOGIC;
  signal \i__carry_i_3_n_0\ : STD_LOGIC;
  signal \i__carry_i_4_n_0\ : STD_LOGIC;
  signal idle : STD_LOGIC;
  signal idle_i_1_n_0 : STD_LOGIC;
  signal \^m1_axis_phase_tvalid\ : STD_LOGIC;
  signal m_axis_tvalid_i_1_n_0 : STD_LOGIC;
  signal m_axis_tvalid_i_2_n_0 : STD_LOGIC;
  signal m_axis_tvalid_i_3_n_0 : STD_LOGIC;
  signal \madd_sin1f_b[15]_i_1_n_0\ : STD_LOGIC;
  signal p_0_in : STD_LOGIC_VECTOR ( 9 downto 0 );
  signal \NLW_cpos0_inferred__0/i__carry_O_UNCONNECTED\ : STD_LOGIC_VECTOR ( 3 downto 0 );
  attribute SOFT_HLUTNM : string;
  attribute SOFT_HLUTNM of \cpos[1]_i_1\ : label is "soft_lutpair4";
  attribute SOFT_HLUTNM of \cpos[2]_i_1\ : label is "soft_lutpair4";
  attribute SOFT_HLUTNM of \cpos[3]_i_1\ : label is "soft_lutpair1";
  attribute SOFT_HLUTNM of \cpos[4]_i_1\ : label is "soft_lutpair1";
  attribute SOFT_HLUTNM of \cpos[6]_i_1\ : label is "soft_lutpair3";
  attribute SOFT_HLUTNM of \cpos[7]_i_1\ : label is "soft_lutpair3";
  attribute SOFT_HLUTNM of \cpos[8]_i_1\ : label is "soft_lutpair0";
  attribute SOFT_HLUTNM of \cpos[9]_i_3\ : label is "soft_lutpair0";
  attribute SOFT_HLUTNM of idle_i_1 : label is "soft_lutpair2";
  attribute SOFT_HLUTNM of m_axis_tvalid_i_3 : label is "soft_lutpair2";
begin
  data_ready_o <= \^data_ready_o\;
  m1_axis_phase_tvalid <= \^m1_axis_phase_tvalid\;
\adc_data[15]_i_1\: unisim.vcomponents.LUT6
    generic map(
      INIT => X"FFFF000020000000"
    )
        port map (
      I0 => adc_has_data,
      I1 => idle,
      I2 => s0_axis_data_tvalid,
      I3 => s1_axis_data_tvalid,
      I4 => nres_i,
      I5 => adc_data_ready_i,
      O => \adc_data[15]_i_1_n_0\
    );
\adc_data_reg[0]\: unisim.vcomponents.FDRE
     port map (
      C => fpga_clk_i,
      CE => \adc_data[15]_i_1_n_0\,
      D => adc_data_i(0),
      Q => adc_data(0),
      R => '0'
    );
\adc_data_reg[10]\: unisim.vcomponents.FDRE
     port map (
      C => fpga_clk_i,
      CE => \adc_data[15]_i_1_n_0\,
      D => adc_data_i(10),
      Q => adc_data(10),
      R => '0'
    );
\adc_data_reg[11]\: unisim.vcomponents.FDRE
     port map (
      C => fpga_clk_i,
      CE => \adc_data[15]_i_1_n_0\,
      D => adc_data_i(11),
      Q => adc_data(11),
      R => '0'
    );
\adc_data_reg[12]\: unisim.vcomponents.FDRE
     port map (
      C => fpga_clk_i,
      CE => \adc_data[15]_i_1_n_0\,
      D => adc_data_i(12),
      Q => adc_data(12),
      R => '0'
    );
\adc_data_reg[13]\: unisim.vcomponents.FDRE
     port map (
      C => fpga_clk_i,
      CE => \adc_data[15]_i_1_n_0\,
      D => adc_data_i(13),
      Q => adc_data(13),
      R => '0'
    );
\adc_data_reg[14]\: unisim.vcomponents.FDRE
     port map (
      C => fpga_clk_i,
      CE => \adc_data[15]_i_1_n_0\,
      D => adc_data_i(14),
      Q => adc_data(14),
      R => '0'
    );
\adc_data_reg[15]\: unisim.vcomponents.FDRE
     port map (
      C => fpga_clk_i,
      CE => \adc_data[15]_i_1_n_0\,
      D => adc_data_i(15),
      Q => adc_data(15),
      R => '0'
    );
\adc_data_reg[1]\: unisim.vcomponents.FDRE
     port map (
      C => fpga_clk_i,
      CE => \adc_data[15]_i_1_n_0\,
      D => adc_data_i(1),
      Q => adc_data(1),
      R => '0'
    );
\adc_data_reg[2]\: unisim.vcomponents.FDRE
     port map (
      C => fpga_clk_i,
      CE => \adc_data[15]_i_1_n_0\,
      D => adc_data_i(2),
      Q => adc_data(2),
      R => '0'
    );
\adc_data_reg[3]\: unisim.vcomponents.FDRE
     port map (
      C => fpga_clk_i,
      CE => \adc_data[15]_i_1_n_0\,
      D => adc_data_i(3),
      Q => adc_data(3),
      R => '0'
    );
\adc_data_reg[4]\: unisim.vcomponents.FDRE
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
      D => s1_axis_data_tdata(31),
      Q => madd_sin2f_b(15),
      R => '0'
    );
\madd_sin2f_b_reg[1]\: unisim.vcomponents.FDRE
     port map (
      C => fpga_clk_i,
      CE => \madd_sin1f_b[15]_i_1_n_0\,
      D => s1_axis_data_tdata(17),
      Q => madd_sin2f_b(1),
      R => '0'
    );
\madd_sin2f_b_reg[2]\: unisim.vcomponents.FDRE
     port map (
      C => fpga_clk_i,
      CE => \madd_sin1f_b[15]_i_1_n_0\,
      D => s1_axis_data_tdata(18),
      Q => madd_sin2f_b(2),
      R => '0'
    );
\madd_sin2f_b_reg[3]\: unisim.vcomponents.FDRE
     port map (
      C => fpga_clk_i,
      CE => \madd_sin1f_b[15]_i_1_n_0\,
      D => s1_axis_data_tdata(19),
      Q => madd_sin2f_b(3),
      R => '0'
    );
\madd_sin2f_b_reg[4]\: unisim.vcomponents.FDRE
     port map (
      C => fpga_clk_i,
      CE => \madd_sin1f_b[15]_i_1_n_0\,
      D => s1_axis_data_tdata(20),
      Q => madd_sin2f_b(4),
      R => '0'
    );
\madd_sin2f_b_reg[5]\: unisim.vcomponents.FDRE
     port map (
      C => fpga_clk_i,
      CE => \madd_sin1f_b[15]_i_1_n_0\,
      D => s1_axis_data_tdata(21),
      Q => madd_sin2f_b(5),
      R => '0'
    );
\madd_sin2f_b_reg[6]\: unisim.vcomponents.FDRE
     port map (
      C => fpga_clk_i,
      CE => \madd_sin1f_b[15]_i_1_n_0\,
      D => s1_axis_data_tdata(22),
      Q => madd_sin2f_b(6),
      R => '0'
    );
\madd_sin2f_b_reg[7]\: unisim.vcomponents.FDRE
     port map (
      C => fpga_clk_i,
      CE => \madd_sin1f_b[15]_i_1_n_0\,
      D => s1_axis_data_tdata(23),
      Q => madd_sin2f_b(7),
      R => '0'
    );
\madd_sin2f_b_reg[8]\: unisim.vcomponents.FDRE
     port map (
      C => fpga_clk_i,
      CE => \madd_sin1f_b[15]_i_1_n_0\,
      D => s1_axis_data_tdata(24),
      Q => madd_sin2f_b(8),
      R => '0'
    );
\madd_sin2f_b_reg[9]\: unisim.vcomponents.FDRE
     port map (
      C => fpga_clk_i,
      CE => \madd_sin1f_b[15]_i_1_n_0\,
      D => s1_axis_data_tdata(25),
      Q => madd_sin2f_b(9),
      R => '0'
    );
end STRUCTURE;
library IEEE;
use IEEE.STD_LOGIC_1164.ALL;
library UNISIM;
use UNISIM.VCOMPONENTS.ALL;
entity decalper_eb_ot_sdeen_pot_pi_dehcac_xnilix is
  port (
    fpga_clk_i : in STD_LOGIC;
    nres_i : in STD_LOGIC;
    adc_data_ready_i : in STD_LOGIC;
    encoder_cnt_i : in STD_LOGIC_VECTOR ( 10 downto 0 );
    adc_data_i : in STD_LOGIC_VECTOR ( 15 downto 0 );
    madd_sin1f_p : in STD_LOGIC_VECTOR ( 47 downto 0 );
    madd_cos1f_p : in STD_LOGIC_VECTOR ( 47 downto 0 );
    madd_sin2f_p : in STD_LOGIC_VECTOR ( 47 downto 0 );
    madd_cos2f_p : in STD_LOGIC_VECTOR ( 47 downto 0 );
    add_s : in STD_LOGIC_VECTOR ( 31 downto 0 );
    madd_sin1f_c : out STD_LOGIC_VECTOR ( 47 downto 0 );
    madd_cos1f_c : out STD_LOGIC_VECTOR ( 47 downto 0 );
    madd_sin2f_c : out STD_LOGIC_VECTOR ( 47 downto 0 );
    madd_cos2f_c : out STD_LOGIC_VECTOR ( 47 downto 0 );
    madd_sin1f_b : out STD_LOGIC_VECTOR ( 15 downto 0 );
    madd_cos1f_b : out STD_LOGIC_VECTOR ( 15 downto 0 );
    madd_sin2f_b : out STD_LOGIC_VECTOR ( 15 downto 0 );
    madd_cos2f_b : out STD_LOGIC_VECTOR ( 15 downto 0 );
    add_b : out STD_LOGIC_VECTOR ( 31 downto 0 );
    adc_data : out STD_LOGIC_VECTOR ( 15 downto 0 );
    res_0f : out STD_LOGIC_VECTOR ( 31 downto 0 );
    res_sin1f : out STD_LOGIC_VECTOR ( 47 downto 0 );
    res_cos1f : out STD_LOGIC_VECTOR ( 47 downto 0 );
    res_sin2f : out STD_LOGIC_VECTOR ( 47 downto 0 );
    res_cos2f : out STD_LOGIC_VECTOR ( 47 downto 0 );
    m0_axis_phase_tdata : out STD_LOGIC_VECTOR ( 15 downto 0 );
    m0_axis_phase_tvalid : out STD_LOGIC;
    s0_axis_data_tdata : in STD_LOGIC_VECTOR ( 31 downto 0 );
    s0_axis_data_tvalid : in STD_LOGIC;
    m1_axis_phase_tdata : out STD_LOGIC_VECTOR ( 15 downto 0 );
    m1_axis_phase_tvalid : out STD_LOGIC;
    s1_axis_data_tdata : in STD_LOGIC_VECTOR ( 31 downto 0 );
    s1_axis_data_tvalid : in STD_LOGIC;
    data_ready_o : out STD_LOGIC
  );
  attribute NotValidForBitStream : boolean;
  attribute NotValidForBitStream of decalper_eb_ot_sdeen_pot_pi_dehcac_xnilix : entity is true;
  attribute CHECK_LICENSE_TYPE : string;
  attribute CHECK_LICENSE_TYPE of decalper_eb_ot_sdeen_pot_pi_dehcac_xnilix : entity is "Main_DSP_controller_0_1,DSP_controller,{}";
  attribute DowngradeIPIdentifiedWarnings : string;
  attribute DowngradeIPIdentifiedWarnings of decalper_eb_ot_sdeen_pot_pi_dehcac_xnilix : entity is "yes";
  attribute IP_DEFINITION_SOURCE : string;
  attribute IP_DEFINITION_SOURCE of decalper_eb_ot_sdeen_pot_pi_dehcac_xnilix : entity is "module_ref";
  attribute X_CORE_INFO : string;
  attribute X_CORE_INFO of decalper_eb_ot_sdeen_pot_pi_dehcac_xnilix : entity is "DSP_controller,Vivado 2022.1";
end decalper_eb_ot_sdeen_pot_pi_dehcac_xnilix;

architecture STRUCTURE of decalper_eb_ot_sdeen_pot_pi_dehcac_xnilix is
  signal \<const0>\ : STD_LOGIC;
  signal \^m0_axis_phase_tdata\ : STD_LOGIC_VECTOR ( 9 to 9 );
  signal \^m1_axis_phase_tdata\ : STD_LOGIC_VECTOR ( 8 downto 0 );
  signal \^m1_axis_phase_tvalid\ : STD_LOGIC;
  attribute X_INTERFACE_INFO : string;
  attribute X_INTERFACE_INFO of m0_axis_phase_tvalid : signal is "xilinx.com:interface:axis:1.0 m0_axis_phase TVALID";
  attribute X_INTERFACE_PARAMETER : string;
  attribute X_INTERFACE_PARAMETER of m0_axis_phase_tvalid : signal is "XIL_INTERFACENAME m0_axis_phase, TDATA_NUM_BYTES 2, TDEST_WIDTH 0, TID_WIDTH 0, TUSER_WIDTH 0, HAS_TREADY 0, HAS_TSTRB 0, HAS_TKEEP 0, HAS_TLAST 0, FREQ_HZ 100000000, PHASE 0.0, LAYERED_METADATA undef, INSERT_VIP 0";
  attribute X_INTERFACE_INFO of m1_axis_phase_tvalid : signal is "xilinx.com:interface:axis:1.0 m1_axis_phase TVALID";
  attribute X_INTERFACE_PARAMETER of m1_axis_phase_tvalid : signal is "XIL_INTERFACENAME m1_axis_phase, TDATA_NUM_BYTES 2, TDEST_WIDTH 0, TID_WIDTH 0, TUSER_WIDTH 0, HAS_TREADY 0, HAS_TSTRB 0, HAS_TKEEP 0, HAS_TLAST 0, FREQ_HZ 100000000, PHASE 0.0, LAYERED_METADATA undef, INSERT_VIP 0";
  attribute X_INTERFACE_INFO of s0_axis_data_tvalid : signal is "xilinx.com:interface:axis:1.0 s0_axis_data TVALID";
  attribute X_INTERFACE_PARAMETER of s0_axis_data_tvalid : signal is "XIL_INTERFACENAME s0_axis_data, TDATA_NUM_BYTES 4, TDEST_WIDTH 0, TID_WIDTH 0, TUSER_WIDTH 0, HAS_TREADY 0, HAS_TSTRB 0, HAS_TKEEP 0, HAS_TLAST 0, FREQ_HZ 100000000, PHASE 0.0, LAYERED_METADATA xilinx.com:interface:datatypes:1.0 {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
  attribute X_INTERFACE_INFO of s1_axis_data_tvalid : signal is "xilinx.com:interface:axis:1.0 s1_axis_data TVALID";
  attribute X_INTERFACE_PARAMETER of s1_axis_data_tvalid : signal is "XIL_INTERFACENAME s1_axis_data, TDATA_NUM_BYTES 4, TDEST_WIDTH 0, TID_WIDTH 0, TUSER_WIDTH 0, HAS_TREADY 0, HAS_TSTRB 0, HAS_TKEEP 0, HAS_TLAST 0, FREQ_HZ 100000000, PHASE 0.0, LAYERED_METADATA xilinx.com:interface:datatypes:1.0 {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
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
      madd_cos2f_b(15 downto 0) => madd_cos2f_b(15 downto 0),
      madd_sin1f_b(15 downto 0) => madd_sin1f_b(15 downto 0),
      madd_sin2f_b(15 downto 0) => madd_sin2f_b(15 downto 0),
      nres_i => nres_i,
      s0_axis_data_tdata(31 downto 0) => s0_axis_data_tdata(31 downto 0),
      s0_axis_data_tvalid => s0_axis_data_tvalid,
      s1_axis_data_tdata(31 downto 0) => s1_axis_data_tdata(31 downto 0),
      s1_axis_data_tvalid => s1_axis_data_tvalid
    );
end STRUCTURE;
