JPirman/FPGA_polarimeter/Polarimeter_core/Vivado/Polarimeter_Microblaze.cache/ip/2022.1/4/e/4e3c19b2843b1845/Main_DSP_controller_0_1_sim_netlist.v

// Copyright 1986-2022 Xilinx, Inc. All Rights Reserved.
// --------------------------------------------------------------------------------
// Tool Version: Vivado v.2022.1 (lin64) Build 3526262 Mon Apr 18 15:47:01 MDT 2022
// Date        : Fri Jul  8 18:50:16 2022
// Host        : Jure-Linux running 64-bit Linux Mint 20.3
// Command     : write_verilog -force -mode funcsim -rename_top decalper_eb_ot_sdeen_pot_pi_dehcac_xnilix -prefix
//               decalper_eb_ot_sdeen_pot_pi_dehcac_xnilix_ Main_DSP_controller_0_1_sim_netlist.v
// Design      : Main_DSP_controller_0_1
// Purpose     : This verilog netlist is a functional simulation representation of the design and should not be modified
//               or synthesized. This netlist cannot be used for SDF annotated simulation.
// Device      : xc7s25csga324-1
// --------------------------------------------------------------------------------
`timescale 1 ps / 1 ps

module decalper_eb_ot_sdeen_pot_pi_dehcac_xnilix_DSP_controller
   (madd_sin1f_c,
    madd_cos1f_c,
    madd_sin2f_c,
    madd_cos2f_c,
    madd_sin1f_b,
    madd_cos1f_b,
    madd_sin2f_b,
    madd_cos2f_b,
    add_b,
    adc_data,
    res_0f,
    res_sin1f,
    res_cos1f,
    res_sin2f,
    res_cos2f,
    m0_axis_phase_tdata,
    data_ready_o,
    m1_axis_phase_tvalid,
    encoder_cnt_i,
    fpga_clk_i,
    nres_i,
    madd_sin1f_p,
    madd_cos1f_p,
    madd_sin2f_p,
    madd_cos2f_p,
    s0_axis_data_tdata,
    s1_axis_data_tdata,
    add_s,
    adc_data_i,
    adc_data_ready_i,
    s1_axis_data_tvalid,
    s0_axis_data_tvalid);
  output [47:0]madd_sin1f_c;
  output [47:0]madd_cos1f_c;
  output [47:0]madd_sin2f_c;
  output [47:0]madd_cos2f_c;
  output [15:0]madd_sin1f_b;
  output [15:0]madd_cos1f_b;
  output [15:0]madd_sin2f_b;
  output [15:0]madd_cos2f_b;
  output [31:0]add_b;
  output [15:0]adc_data;
  output [31:0]res_0f;
  output [47:0]res_sin1f;
  output [47:0]res_cos1f;
  output [47:0]res_sin2f;
  output [47:0]res_cos2f;
  output [9:0]m0_axis_phase_tdata;
  output data_ready_o;
  output m1_axis_phase_tvalid;
  input [10:0]encoder_cnt_i;
  input fpga_clk_i;
  input nres_i;
  input [47:0]madd_sin1f_p;
  input [47:0]madd_cos1f_p;
  input [47:0]madd_sin2f_p;
  input [47:0]madd_cos2f_p;
  input [31:0]s0_axis_data_tdata;
  input [31:0]s1_axis_data_tdata;
  input [31:0]add_s;
  input [15:0]adc_data_i;
  input adc_data_ready_i;
  input s1_axis_data_tvalid;
  input s0_axis_data_tvalid;

  wire [15:0]adc_data;
  wire [15:0]adc_data_i;
  wire adc_data_ready_i;
  wire [31:0]add_b;
  wire [31:0]add_s;
  wire clear;
  wire cnt_lsb_del;
  wire cphase;
  wire cpos0;
  wire \cpos0_inferred__0/i__carry_n_1 ;
  wire \cpos0_inferred__0/i__carry_n_2 ;
  wire \cpos0_inferred__0/i__carry_n_3 ;
  wire cpos1__0;
  wire \cpos[9]_i_1_n_0 ;
  wire \cpos[9]_i_3_n_0 ;
  wire [9:0]cpos_reg;
  wire data_ready_o;
  wire data_ready_o_i_1_n_0;
  wire [10:0]encoder_cnt_i;
  wire fpga_clk_i;
  wire i__carry_i_1_n_0;
  wire i__carry_i_2_n_0;
  wire i__carry_i_3_n_0;
  wire i__carry_i_4_n_0;
  wire idle;
  wire idle_i_1_n_0;
  wire [9:0]m0_axis_phase_tdata;
  wire m1_axis_phase_tvalid;
  wire m_axis_tvalid_i_1_n_0;
  wire m_axis_tvalid_i_3_n_0;
  wire [15:0]madd_cos1f_b;
  wire [47:0]madd_cos1f_c;
  wire [47:0]madd_cos1f_p;
  wire [15:0]madd_cos2f_b;
  wire [47:0]madd_cos2f_c;
  wire [47:0]madd_cos2f_p;
  wire [15:0]madd_sin1f_b;
  wire \madd_sin1f_b[15]_i_1_n_0 ;
  wire [47:0]madd_sin1f_c;
  wire \madd_sin1f_c[47]_i_2_n_0 ;
  wire [47:0]madd_sin1f_p;
  wire [15:0]madd_sin2f_b;
  wire [47:0]madd_sin2f_c;
  wire [47:0]madd_sin2f_p;
  wire \madd_wait_cnt[0]_i_1_n_0 ;
  wire \madd_wait_cnt[1]_i_1_n_0 ;
  wire \madd_wait_cnt_reg_n_0_[0] ;
  wire \madd_wait_cnt_reg_n_0_[1] ;
  wire madd_wait_state_i_1_n_0;
  wire madd_wait_state_reg_n_0;
  wire nres_i;
  wire [9:0]p_0_in;
  wire [31:0]res_0f;
  wire \res_0f[31]_i_1_n_0 ;
  wire \res_0f[31]_i_2_n_0 ;
  wire \res_0f[31]_i_3_n_0 ;
  wire \res_0f[31]_i_4_n_0 ;
  wire \res_0f[31]_i_5_n_0 ;
  wire [47:0]res_cos1f;
  wire [47:0]res_cos2f;
  wire [47:0]res_sin1f;
  wire [47:0]res_sin2f;
  wire [31:0]s0_axis_data_tdata;
  wire s0_axis_data_tvalid;
  wire [31:0]s1_axis_data_tdata;
  wire s1_axis_data_tvalid;
  wire [3:0]\NLW_cpos0_inferred__0/i__carry_O_UNCONNECTED ;

  FDRE \adc_data_reg[0] 
       (.C(fpga_clk_i),
        .CE(\madd_sin1f_b[15]_i_1_n_0 ),
        .D(adc_data_i[0]),
        .Q(adc_data[0]),
        .R(1'b0));
  FDRE \adc_data_reg[10] 
       (.C(fpga_clk_i),
        .CE(\madd_sin1f_b[15]_i_1_n_0 ),
        .D(adc_data_i[10]),
        .Q(adc_data[10]),
        .R(1'b0));
  FDRE \adc_data_reg[11] 
       (.C(fpga_clk_i),
        .CE(\madd_sin1f_b[15]_i_1_n_0 ),
        .D(adc_data_i[11]),
        .Q(adc_data[11]),
        .R(1'b0));
  FDRE \adc_data_reg[12] 
       (.C(fpga_clk_i),
        .CE(\madd_sin1f_b[15]_i_1_n_0 ),
        .D(adc_data_i[12]),
        .Q(adc_data[12]),
        .R(1'b0));
  FDRE \adc_data_reg[13] 
       (.C(fpga_clk_i),
        .CE(\madd_sin1f_b[15]_i_1_n_0 ),
        .D(adc_data_i[13]),
        .Q(adc_data[13]),
        .R(1'b0));
  FDRE \adc_data_reg[14] 
       (.C(fpga_clk_i),
        .CE(\madd_sin1f_b[15]_i_1_n_0 ),
        .D(adc_data_i[14]),
        .Q(adc_data[14]),
        .R(1'b0));
  FDRE \adc_data_reg[15] 
       (.C(fpga_clk_i),
        .CE(\madd_sin1f_b[15]_i_1_n_0 ),
        .D(adc_data_i[15]),
        .Q(adc_data[15]),
        .R(1'b0));
  FDRE \adc_data_reg[1] 
       (.C(fpga_clk_i),
        .CE(\madd_sin1f_b[15]_i_1_n_0 ),
        .D(adc_data_i[1]),
        .Q(adc_data[1]),
        .R(1'b0));
  FDRE \adc_data_reg[2] 
       (.C(fpga_clk_i),
        .CE(\madd_sin1f_b[15]_i_1_n_0 ),
        .D(adc_data_i[2]),
        .Q(adc_data[2]),
        .R(1'b0));
  FDRE \adc_data_reg[3] 
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
        .I5(encoder_cnt_i[8]),
        .O(i__carry_i_2_n_0));
  LUT6 #(
    .INIT(64'h9009000000009009)) 
    i__carry_i_3
       (.I0(cpos_reg[4]),
        .I1(encoder_cnt_i[4]),
        .I2(cpos_reg[3]),
        .I3(encoder_cnt_i[3]),
        .I4(cpos_reg[5]),
        .I5(encoder_cnt_i[5]),
        .O(i__carry_i_3_n_0));
  LUT6 #(
    .INIT(64'h9009000000009009)) 
    i__carry_i_4
       (.I0(cpos_reg[1]),
        .I1(encoder_cnt_i[1]),
        .I2(cpos_reg[0]),
        .I3(encoder_cnt_i[0]),
        .I4(cpos_reg[2]),
        .I5(encoder_cnt_i[2]),
        .O(i__carry_i_4_n_0));
  LUT6 #(
    .INIT(64'hF55FFFFFDDDDDDDD)) 
    idle_i_1
       (.I0(nres_i),
        .I1(\madd_sin1f_c[47]_i_2_n_0 ),
        .I2(cnt_lsb_del),
        .I3(encoder_cnt_i[0]),
        .I4(cpos0),
        .I5(idle),
        .O(idle_i_1_n_0));
  FDRE #(
    .INIT(1'b1)) 
    idle_reg
       (.C(fpga_clk_i),
        .CE(1'b1),
        .D(idle_i_1_n_0),
        .Q(idle),
        .R(1'b0));
  LUT6 #(
    .INIT(64'hF0F000F080800000)) 
    m_axis_tvalid_i_1
       (.I0(cpos1__0),
        .I1(cpos0),
        .I2(nres_i),
        .I3(m_axis_tvalid_i_3_n_0),
        .I4(idle),
        .I5(m1_axis_phase_tvalid),
        .O(m_axis_tvalid_i_1_n_0));
  LUT2 #(
    .INIT(4'h6)) 
    m_axis_tvalid_i_2
       (.I0(encoder_cnt_i[0]),
        .I1(cnt_lsb_del),
        .O(cpos1__0));
  LUT4 #(
    .INIT(16'h0800)) 
    m_axis_tvalid_i_3
       (.I0(s0_axis_data_tvalid),
        .I1(s1_axis_data_tvalid),
        .I2(madd_wait_state_reg_n_0),
        .I3(adc_data_ready_i),
        .O(m_axis_tvalid_i_3_n_0));
  FDRE #(
    .INIT(1'b0)) 
    m_axis_tvalid_reg
       (.C(fpga_clk_i),
        .CE(1'b1),
        .D(m_axis_tvalid_i_1_n_0),
        .Q(m1_axis_phase_tvalid),
        .R(1'b0));
  FDRE \madd_cos1f_b_reg[0] 
       (.C(fpga_clk_i),
        .CE(\madd_sin1f_b[15]_i_1_n_0 ),
        .D(s0_axis_data_tdata[0]),
        .Q(madd_cos1f_b[0]),
        .R(1'b0));
  FDRE \madd_cos1f_b_reg[10] 
       (.C(fpga_clk_i),
        .CE(\madd_sin1f_b[15]_i_1_n_0 ),
        .D(s0_axis_data_tdata[10]),
        .Q(madd_cos1f_b[10]),
        .R(1'b0));
  FDRE \madd_cos1f_b_reg[11] 
       (.C(fpga_clk_i),
        .CE(\madd_sin1f_b[15]_i_1_n_0 ),
        .D(s0_axis_data_tdata[11]),
        .Q(madd_cos1f_b[11]),
        .R(1'b0));
  FDRE \madd_cos1f_b_reg[12] 
       (.C(fpga_clk_i),
        .CE(\madd_sin1f_b[15]_i_1_n_0 ),
        .D(s0_axis_data_tdata[12]),
        .Q(madd_cos1f_b[12]),
        .R(1'b0));
  FDRE \madd_cos1f_b_reg[13] 
       (.C(fpga_clk_i),
        .CE(\madd_sin1f_b[15]_i_1_n_0 ),
        .D(s0_axis_data_tdata[13]),
        .Q(madd_cos1f_b[13]),
        .R(1'b0));
  FDRE \madd_cos1f_b_reg[14] 
       (.C(fpga_clk_i),
        .CE(\madd_sin1f_b[15]_i_1_n_0 ),
        .D(s0_axis_data_tdata[14]),
        .Q(madd_cos1f_b[14]),
        .R(1'b0));
  FDRE \madd_cos1f_b_reg[15] 
       (.C(fpga_clk_i),
        .CE(\madd_sin1f_b[15]_i_1_n_0 ),
        .D(s0_axis_data_tdata[15]),
        .Q(madd_cos1f_b[15]),
        .R(1'b0));
  FDRE \madd_cos1f_b_reg[1] 
       (.C(fpga_clk_i),
        .CE(\madd_sin1f_b[15]_i_1_n_0 ),
        .D(s0_axis_data_tdata[1]),
        .Q(madd_cos1f_b[1]),
        .R(1'b0));
  FDRE \madd_cos1f_b_reg[2] 
       (.C(fpga_clk_i),
        .CE(\madd_sin1f_b[15]_i_1_n_0 ),
        .D(s0_axis_data_tdata[2]),
        .Q(madd_cos1f_b[2]),
        .R(1'b0));
  FDRE \madd_cos1f_b_reg[3] 
       (.C(fpga_clk_i),
        .CE(\madd_sin1f_b[15]_i_1_n_0 ),
        .D(s0_axis_data_tdata[3]),
        .Q(madd_cos1f_b[3]),
        .R(1'b0));
  FDRE \madd_cos1f_b_reg[4] 
       (.C(fpga_clk_i),
        .CE(\madd_sin1f_b[15]_i_1_n_0 ),
        .D(s0_axis_data_tdata[4]),
        .Q(madd_cos1f_b[4]),
        .R(1'b0));
  FDRE \madd_cos1f_b_reg[5] 
       (.C(fpga_clk_i),
        .CE(\madd_sin1f_b[15]_i_1_n_0 ),
        .D(s0_axis_data_tdata[5]),
        .Q(madd_cos1f_b[5]),
        .R(1'b0));
  FDRE \madd_cos1f_b_reg[6] 
       (.C(fpga_clk_i),
        .CE(\madd_sin1f_b[15]_i_1_n_0 ),
        .D(s0_axis_data_tdata[6]),
        .Q(madd_cos1f_b[6]),
        .R(1'b0));
  FDRE \madd_cos1f_b_reg[7] 
       (.C(fpga_clk_i),
        .CE(\madd_sin1f_b[15]_i_1_n_0 ),
        .D(s0_axis_data_tdata[7]),
        .Q(madd_cos1f_b[7]),
        .R(1'b0));
  FDRE \madd_cos1f_b_reg[8] 
       (.C(fpga_clk_i),
        .CE(\madd_sin1f_b[15]_i_1_n_0 ),
        .D(s0_axis_data_tdata[8]),
        .Q(madd_cos1f_b[8]),
        .R(1'b0));
  FDRE \madd_cos1f_b_reg[9] 
       (.C(fpga_clk_i),
        .CE(\madd_sin1f_b[15]_i_1_n_0 ),
        .D(s0_axis_data_tdata[9]),
        .Q(madd_cos1f_b[9]),
        .R(1'b0));
  FDRE \madd_cos1f_c_reg[0] 
       (.C(fpga_clk_i),
        .CE(\madd_sin1f_c[47]_i_2_n_0 ),
        .D(madd_cos1f_p[0]),
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
        .I1(\madd_wait_cnt_reg_n_0_[0] ),
        .I2(madd_wait_state_reg_n_0),
        .I3(nres_i),
        .I4(m_axis_tvalid_i_3_n_0),
        .I5(idle),
        .O(\madd_wait_cnt[1]_i_1_n_0 ));
  FDRE #(
    .INIT(1'b0)) 
    \madd_wait_cnt_reg[0] 
       (.C(fpga_clk_i),
        .CE(1'b1),
        .D(\madd_wait_cnt[0]_i_1_n_0 ),
        .Q(\madd_wait_cnt_reg_n_0_[0] ),
        .R(1'b0));
  FDRE #(
    .INIT(1'b0)) 
    \madd_wait_cnt_reg[1] 
       (.C(fpga_clk_i),
        .CE(1'b1),
        .D(\madd_wait_cnt[1]_i_1_n_0 ),
        .Q(\madd_wait_cnt_reg_n_0_[1] ),
        .R(1'b0));
  LUT6 #(
    .INIT(64'hF000F0000000E000)) 
    madd_wait_state_i_1
       (.I0(\madd_wait_cnt_reg_n_0_[1] ),
        .I1(\madd_wait_cnt_reg_n_0_[0] ),
        .I2(madd_wait_state_reg_n_0),
        .I3(nres_i),
        .I4(m_axis_tvalid_i_3_n_0),
        .I5(idle),
        .O(madd_wait_state_i_1_n_0));
  FDRE #(
    .INIT(1'b0)) 
    madd_wait_state_reg
       (.C(fpga_clk_i),
        .CE(1'b1),
        .D(madd_wait_state_i_1_n_0),
        .Q(madd_wait_state_reg_n_0),
        .R(1'b0));
  LUT6 #(
    .INIT(64'h1400000000000000)) 
    \res_0f[31]_i_1 
       (.I0(\res_0f[31]_i_2_n_0 ),
        .I1(encoder_cnt_i[0]),
        .I2(cnt_lsb_del),
        .I3(\res_0f[31]_i_3_n_0 ),
        .I4(\res_0f[31]_i_4_n_0 ),
        .I5(\res_0f[31]_i_5_n_0 ),
        .O(\res_0f[31]_i_1_n_0 ));
  LUT2 #(
    .INIT(4'h7)) 
    \res_0f[31]_i_2 
       (.I0(nres_i),
        .I1(idle),
        .O(\res_0f[31]_i_2_n_0 ));
  LUT4 #(
    .INIT(16'h0001)) 
    \res_0f[31]_i_3 
       (.I0(cpos_reg[9]),
        .I1(cpos_reg[8]),
        .I2(cpos_reg[7]),
        .I3(cpos_reg[5]),
        .O(\res_0f[31]_i_3_n_0 ));
  (* SOFT_HLUTNM = "soft_lutpair2" *) 
  LUT4 #(
    .INIT(16'h0001)) 
    \res_0f[31]_i_4 
       (.I0(cpos_reg[1]),
        .I1(cpos_reg[0]),
        .I2(cpos_reg[4]),
        .I3(cpos_reg[2]),
        .O(\res_0f[31]_i_4_n_0 ));
  LUT6 #(
    .INIT(64'h0000230000002323)) 
    \res_0f[31]_i_5 
       (.I0(cpos_reg[7]),
        .I1(cpos_reg[8]),
        .I2(cpos_reg[6]),
        .I3(cpos_reg[4]),
        .I4(cpos_reg[5]),
        .I5(cpos_reg[3]),
        .O(\res_0f[31]_i_5_n_0 ));
  FDRE \res_0f_reg[0] 
       (.C(fpga_clk_i),
        .CE(\res_0f[31]_i_1_n_0 ),
        .D(add_b[0]),
        .Q(res_0f[0]),
        .R(1'b0));
  FDRE \res_0f_reg[10] 
       (.C(fpga_clk_i),
        .CE(\res_0f[31]_i_1_n_0 ),
        .D(add_b[10]),
        .Q(res_0f[10]),
        .R(1'b0));
  FDRE \res_0f_reg[11] 
       (.C(fpga_clk_i),
        .CE(\res_0f[31]_i_1_n_0 ),
        .D(add_b[11]),
        .Q(res_0f[11]),
        .R(1'b0));
  FDRE \res_0f_reg[12] 
       (.C(fpga_clk_i),
        .CE(\res_0f[31]_i_1_n_0 ),
        .D(add_b[12]),
        .Q(res_0f[12]),
        .R(1'b0));
  FDRE \res_0f_reg[13] 
       (.C(fpga_clk_i),
        .CE(\res_0f[31]_i_1_n_0 ),
        .D(add_b[13]),
        .Q(res_0f[13]),
        .R(1'b0));
  FDRE \res_0f_reg[14] 
       (.C(fpga_clk_i),
        .CE(\res_0f[31]_i_1_n_0 ),
        .D(add_b[14]),
        .Q(res_0f[14]),
        .R(1'b0));
  FDRE \res_0f_reg[15] 
       (.C(fpga_clk_i),
        .CE(\res_0f[31]_i_1_n_0 ),
        .D(add_b[15]),
        .Q(res_0f[15]),
        .R(1'b0));
  FDRE \res_0f_reg[16] 
       (.C(fpga_clk_i),
        .CE(\res_0f[31]_i_1_n_0 ),
        .D(add_b[16]),
        .Q(res_0f[16]),
        .R(1'b0));
  FDRE \res_0f_reg[17] 
       (.C(fpga_clk_i),
        .CE(\res_0f[31]_i_1_n_0 ),
        .D(add_b[17]),
        .Q(res_0f[17]),
        .R(1'b0));
  FDRE \res_0f_reg[18] 
       (.C(fpga_clk_i),
        .CE(\res_0f[31]_i_1_n_0 ),
        .D(add_b[18]),
        .Q(res_0f[18]),
        .R(1'b0));
  FDRE \res_0f_reg[19] 
       (.C(fpga_clk_i),
        .CE(\res_0f[31]_i_1_n_0 ),
        .D(add_b[19]),
        .Q(res_0f[19]),
        .R(1'b0));
  FDRE \res_0f_reg[1] 
       (.C(fpga_clk_i),
        .CE(\res_0f[31]_i_1_n_0 ),
        .D(add_b[1]),
        .Q(res_0f[1]),
        .R(1'b0));
  FDRE \res_0f_reg[20] 
       (.C(fpga_clk_i),
        .CE(\res_0f[31]_i_1_n_0 ),
        .D(add_b[20]),
        .Q(res_0f[20]),
        .R(1'b0));
  FDRE \res_0f_reg[21] 
       (.C(fpga_clk_i),
        .CE(\res_0f[31]_i_1_n_0 ),
        .D(add_b[21]),
        .Q(res_0f[21]),
        .R(1'b0));
  FDRE \res_0f_reg[22] 
       (.C(fpga_clk_i),
        .CE(\res_0f[31]_i_1_n_0 ),
        .D(add_b[22]),
        .Q(res_0f[22]),
        .R(1'b0));
  FDRE \res_0f_reg[23] 
       (.C(fpga_clk_i),
        .CE(\res_0f[31]_i_1_n_0 ),
        .D(add_b[23]),
        .Q(res_0f[23]),
        .R(1'b0));
  FDRE \res_0f_reg[24] 
       (.C(fpga_clk_i),
        .CE(\res_0f[31]_i_1_n_0 ),
        .D(add_b[24]),
        .Q(res_0f[24]),
        .R(1'b0));
  FDRE \res_0f_reg[25] 
       (.C(fpga_clk_i),
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
        .CE(\res_0f[31]_i_1_n_0 ),
        .D(madd_sin2f_c[8]),
        .Q(res_sin2f[8]),
        .R(1'b0));
  FDRE \res_sin2f_reg[9] 
       (.C(fpga_clk_i),
        .CE(\res_0f[31]_i_1_n_0 ),
        .D(madd_sin2f_c[9]),
        .Q(res_sin2f[9]),
        .R(1'b0));
endmodule

(* CHECK_LICENSE_TYPE = "Main_DSP_controller_0_1,DSP_controller,{}" *) (* DowngradeIPIdentifiedWarnings = "yes" *) (* IP_DEFINITION_SOURCE = "module_ref" *) 
(* X_CORE_INFO = "DSP_controller,Vivado 2022.1" *) 
(* NotValidForBitStream *)
module decalper_eb_ot_sdeen_pot_pi_dehcac_xnilix
   (fpga_clk_i,
    nres_i,
    adc_data_ready_i,
    encoder_cnt_i,
    adc_data_i,
    madd_sin1f_p,
    madd_cos1f_p,
    madd_sin2f_p,
    madd_cos2f_p,
    add_s,
    madd_sin1f_c,
    madd_cos1f_c,
    madd_sin2f_c,
    madd_cos2f_c,
    madd_sin1f_b,
    madd_cos1f_b,
    madd_sin2f_b,
    madd_cos2f_b,
    add_b,
    adc_data,
    res_0f,
    res_sin1f,
    res_cos1f,
    res_sin2f,
    res_cos2f,
    m0_axis_phase_tdata,
    m0_axis_phase_tvalid,
    s0_axis_data_tdata,
    s0_axis_data_tvalid,
    m1_axis_phase_tdata,
    m1_axis_phase_tvalid,
    s1_axis_data_tdata,
    s1_axis_data_tvalid,
    data_ready_o);
  input fpga_clk_i;
  input nres_i;
  input adc_data_ready_i;
  input [10:0]encoder_cnt_i;
  input [15:0]adc_data_i;
  input [47:0]madd_sin1f_p;
  input [47:0]madd_cos1f_p;
  input [47:0]madd_sin2f_p;
  input [47:0]madd_cos2f_p;
  input [31:0]add_s;
  output [47:0]madd_sin1f_c;
  output [47:0]madd_cos1f_c;
  output [47:0]madd_sin2f_c;
  output [47:0]madd_cos2f_c;
  output [15:0]madd_sin1f_b;
  output [15:0]madd_cos1f_b;
  output [15:0]madd_sin2f_b;
  output [15:0]madd_cos2f_b;
  output [31:0]add_b;
  output [15:0]adc_data;
  output [31:0]res_0f;
  output [47:0]res_sin1f;
  output [47:0]res_cos1f;
  output [47:0]res_sin2f;
  output [47:0]res_cos2f;
  (* X_INTERFACE_INFO = "xilinx.com:interface:axis:1.0 m0_axis_phase TDATA" *) output [15:0]m0_axis_phase_tdata;
  (* X_INTERFACE_INFO = "xilinx.com:interface:axis:1.0 m0_axis_phase TVALID" *) (* X_INTERFACE_PARAMETER = "XIL_INTERFACENAME m0_axis_phase, TDATA_NUM_BYTES 2, TDEST_WIDTH 0, TID_WIDTH 0, TUSER_WIDTH 0, HAS_TREADY 0, HAS_TSTRB 0, HAS_TKEEP 0, HAS_TLAST 0, FREQ_HZ 100000000, PHASE 0.0, LAYERED_METADATA undef, INSERT_VIP 0" *) output m0_axis_phase_tvalid;
  (* X_INTERFACE_INFO = "xilinx.com:interface:axis:1.0 s0_axis_data TDATA" *) input [31:0]s0_axis_data_tdata;
  (* X_INTERFACE_INFO = "xilinx.com:interface:axis:1.0 s0_axis_data TVALID" *) (* X_INTERFACE_PARAMETER = "XIL_INTERFACENAME s0_axis_data, TDATA_NUM_BYTES 4, TDEST_WIDTH 0, TID_WIDTH 0, TUSER_WIDTH 0, HAS_TREADY 0, HAS_TSTRB 0, HAS_TKEEP 0, HAS_TLAST 0, FREQ_HZ 100000000, PHASE 0.0, LAYERED_METADATA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
  (* X_INTERFACE_INFO = "xilinx.com:interface:axis:1.0 m1_axis_phase TDATA" *) output [15:0]m1_axis_phase_tdata;
  (* X_INTERFACE_INFO = "xilinx.com:interface:axis:1.0 m1_axis_phase TVALID" *) (* X_INTERFACE_PARAMETER = "XIL_INTERFACENAME m1_axis_phase, TDATA_NUM_BYTES 2, TDEST_WIDTH 0, TID_WIDTH 0, TUSER_WIDTH 0, HAS_TREADY 0, HAS_TSTRB 0, HAS_TKEEP 0, HAS_TLAST 0, FREQ_HZ 100000000, PHASE 0.0, LAYERED_METADATA undef, INSERT_VIP 0" *) output m1_axis_phase_tvalid;
  (* X_INTERFACE_INFO = "xilinx.com:interface:axis:1.0 s1_axis_data TDATA" *) input [31:0]s1_axis_data_tdata;
  (* X_INTERFACE_INFO = "xilinx.com:interface:axis:1.0 s1_axis_data TVALID" *) (* X_INTERFACE_PARAMETER = "XIL_INTERFACENAME s1_axis_data, TDATA_NUM_BYTES 4, TDEST_WIDTH 0, TID_WIDTH 0, TUSER_WIDTH 0, HAS_TREADY 0, HAS_TSTRB 0, HAS_TKEEP 0, HAS_TLAST 0, FREQ_HZ 100000000, PHASE 0.0, LAYERED_METADATA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
  output data_ready_o;

  wire \<const0> ;
  wire [15:0]adc_data;
  wire [15:0]adc_data_i;
  wire adc_data_ready_i;
  wire [31:0]add_b;
  wire [31:0]add_s;
  wire data_ready_o;
  wire [10:0]encoder_cnt_i;
  wire fpga_clk_i;
  wire [9:9]\^m0_axis_phase_tdata ;
  wire [8:0]\^m1_axis_phase_tdata ;
  wire m1_axis_phase_tvalid;
  wire [15:0]madd_cos1f_b;
  wire [47:0]madd_cos1f_c;
  wire [47:0]madd_cos1f_p;
  wire [15:0]madd_cos2f_b;
  wire [47:0]madd_cos2f_c;
  wire [47:0]madd_cos2f_p;
  wire [15:0]madd_sin1f_b;
  wire [47:0]madd_sin1f_c;
  wire [47:0]madd_sin1f_p;
  wire [15:0]madd_sin2f_b;
  wire [47:0]madd_sin2f_c;
  wire [47:0]madd_sin2f_p;
  wire nres_i;
  wire [31:0]res_0f;
  wire [47:0]res_cos1f;
  wire [47:0]res_cos2f;
  wire [47:0]res_sin1f;
  wire [47:0]res_sin2f;
  wire [31:0]s0_axis_data_tdata;
  wire s0_axis_data_tvalid;
  wire [31:0]s1_axis_data_tdata;
  wire s1_axis_data_tvalid;

  assign m0_axis_phase_tdata[15] = \<const0> ;
  assign m0_axis_phase_tdata[14] = \<const0> ;
  assign m0_axis_phase_tdata[13] = \<const0> ;
  assign m0_axis_phase_tdata[12] = \<const0> ;
  assign m0_axis_phase_tdata[11] = \<const0> ;
  assign m0_axis_phase_tdata[10] = \<const0> ;
  assign m0_axis_phase_tdata[9] = \^m0_axis_phase_tdata [9];
  assign m0_axis_phase_tdata[8:0] = \^m1_axis_phase_tdata [8:0];
  assign m0_axis_phase_tvalid = m1_axis_phase_tvalid;
  assign m1_axis_phase_tdata[15] = \<const0> ;
  assign m1_axis_phase_tdata[14] = \<const0> ;
  assign m1_axis_phase_tdata[13] = \<const0> ;
  assign m1_axis_phase_tdata[12] = \<const0> ;
  assign m1_axis_phase_tdata[11] = \<const0> ;
  assign m1_axis_phase_tdata[10] = \<const0> ;
  assign m1_axis_phase_tdata[9] = \<const0> ;
  assign m1_axis_phase_tdata[8:0] = \^m1_axis_phase_tdata [8:0];
  GND GND
       (.G(\<const0> ));
  decalper_eb_ot_sdeen_pot_pi_dehcac_xnilix_DSP_controller inst
       (.adc_data(adc_data),
        .adc_data_i(adc_data_i),
        .adc_data_ready_i(adc_data_ready_i),
        .add_b(add_b),
        .add_s(add_s),
        .data_ready_o(data_ready_o),
        .encoder_cnt_i(encoder_cnt_i),
        .fpga_clk_i(fpga_clk_i),
        .m0_axis_phase_tdata({\^m0_axis_phase_tdata ,\^m1_axis_phase_tdata }),
        .m1_axis_phase_tvalid(m1_axis_phase_tvalid),
        .madd_cos1f_b(madd_cos1f_b),
        .madd_cos1f_c(madd_cos1f_c),
        .madd_cos1f_p(madd_cos1f_p),
        .madd_cos2f_b(madd_cos2f_b),
        .madd_cos2f_c(madd_cos2f_c),
        .madd_cos2f_p(madd_cos2f_p),
        .madd_sin1f_b(madd_sin1f_b),
        .madd_sin1f_c(madd_sin1f_c),
        .madd_sin1f_p(madd_sin1f_p),
        .madd_sin2f_b(madd_sin2f_b),
        .madd_sin2f_c(madd_sin2f_c),
        .madd_sin2f_p(madd_sin2f_p),
        .nres_i(nres_i),
        .res_0f(res_0f),
        .res_cos1f(res_cos1f),
        .res_cos2f(res_cos2f),
        .res_sin1f(res_sin1f),
        .res_sin2f(res_sin2f),
        .s0_axis_data_tdata(s0_axis_data_tdata),
        .s0_axis_data_tvalid(s0_axis_data_tvalid),
        .s1_axis_data_tdata(s1_axis_data_tdata),
        .s1_axis_data_tvalid(s1_axis_data_tvalid));
endmodule
`ifndef GLBL
`define GLBL
`timescale  1 ps / 1 ps

module glbl ();

    parameter ROC_WIDTH = 100000;
    parameter TOC_WIDTH = 0;
    parameter GRES_WIDTH = 10000;
    parameter GRES_START = 10000;

//--------   STARTUP Globals --------------
    wire GSR;
    wire GTS;
    wire GWE;
    wire PRLD;
    wire GRESTORE;
    tri1 p_up_tmp;
    tri (weak1, strong0) PLL_LOCKG = p_up_tmp;

    wire PROGB_GLBL;
    wire CCLKO_GLBL;
    wire FCSBO_GLBL;
    wire [3:0] DO_GLBL;
    wire [3:0] DI_GLBL;
   
    reg GSR_int;
    reg GTS_int;
    reg PRLD_int;
    reg GRESTORE_int;
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
