JPirman/FPGA_polarimeter/Polarimeter_core/Vivado/Polarimeter_Microblaze.cache/ip/2022.1/0/b/0bd465e0ead2b182/Main_axi_gpio_0_1_sim_netlist.v

// Copyright 1986-2022 Xilinx, Inc. All Rights Reserved.
// --------------------------------------------------------------------------------
// Tool Version: Vivado v.2022.1 (lin64) Build 3526262 Mon Apr 18 15:47:01 MDT 2022
// Date        : Sat May 21 14:37:01 2022
// Host        : Jure-Linux running 64-bit Linux Mint 20.3
// Command     : write_verilog -force -mode funcsim -rename_top decalper_eb_ot_sdeen_pot_pi_dehcac_xnilix -prefix
//               decalper_eb_ot_sdeen_pot_pi_dehcac_xnilix_ Main_axi_gpio_0_1_sim_netlist.v
// Design      : Main_axi_gpio_0_1
// Purpose     : This verilog netlist is a functional simulation representation of the design and should not be modified
//               or synthesized. This netlist cannot be used for SDF annotated simulation.
// Device      : xc7s25csga324-1
// --------------------------------------------------------------------------------
`timescale 1 ps / 1 ps

module decalper_eb_ot_sdeen_pot_pi_dehcac_xnilix_GPIO_Core
   (gpio_io_o,
    ip2bus_wrack_i,
    ip2bus_rdack_i,
    \GEN_BKEND_CE_REGISTERS[0].ce_out_i_reg[0] ,
    s_axi_aclk,
    SR,
    bus2ip_cs,
    bus2ip_rnw,
    E,
    D,
    \GEN_BKEND_CE_REGISTERS[2].ce_out_i_reg ,
    \GEN_BKEND_CE_REGISTERS[0].ce_out_i_reg ,
    \GEN_BKEND_CE_REGISTERS[1].ce_out_i_reg ,
    Bus_RNW_reg,
    \GEN_BKEND_CE_REGISTERS[3].ce_out_i_reg );
  output [3:0]gpio_io_o;
  output ip2bus_wrack_i;
  output ip2bus_rdack_i;
  output [4:0]\GEN_BKEND_CE_REGISTERS[0].ce_out_i_reg[0] ;
  input s_axi_aclk;
  input [0:0]SR;
  input bus2ip_cs;
  input bus2ip_rnw;
  input [0:0]E;
  input [3:0]D;
  input \GEN_BKEND_CE_REGISTERS[2].ce_out_i_reg ;
  input \GEN_BKEND_CE_REGISTERS[0].ce_out_i_reg ;
  input \GEN_BKEND_CE_REGISTERS[1].ce_out_i_reg ;
  input Bus_RNW_reg;
  input \GEN_BKEND_CE_REGISTERS[3].ce_out_i_reg ;

  wire Bus_RNW_reg;
  wire [3:0]D;
  wire [0:0]E;
  wire \GEN_BKEND_CE_REGISTERS[0].ce_out_i_reg ;
  wire [4:0]\GEN_BKEND_CE_REGISTERS[0].ce_out_i_reg[0] ;
  wire \GEN_BKEND_CE_REGISTERS[1].ce_out_i_reg ;
  wire \GEN_BKEND_CE_REGISTERS[2].ce_out_i_reg ;
  wire \GEN_BKEND_CE_REGISTERS[3].ce_out_i_reg ;
  wire GPIO_xferAck_i;
  wire Read_Reg_Rst__0;
  wire [0:0]SR;
  wire bus2ip_cs;
  wire bus2ip_rnw;
  wire [3:0]gpio_io_o;
  wire gpio_xferAck_Reg;
  wire iGPIO_xferAck__0;
  wire ip2bus_rdack_i;
  wire ip2bus_wrack_i;
  wire [28:31]reg1;
  wire s_axi_aclk;

  FDRE \Not_Dual.ALLOUT_ND.READ_REG_GEN[0].reg1_reg[28] 
       (.C(s_axi_aclk),
        .CE(1'b1),
        .D(gpio_io_o[3]),
        .Q(reg1[28]),
        .R(Read_Reg_Rst__0));
  FDRE \Not_Dual.ALLOUT_ND.READ_REG_GEN[1].reg1_reg[29] 
       (.C(s_axi_aclk),
        .CE(1'b1),
        .D(gpio_io_o[2]),
        .Q(reg1[29]),
        .R(Read_Reg_Rst__0));
  FDRE \Not_Dual.ALLOUT_ND.READ_REG_GEN[2].reg1_reg[30] 
       (.C(s_axi_aclk),
        .CE(1'b1),
        .D(gpio_io_o[1]),
        .Q(reg1[30]),
        .R(Read_Reg_Rst__0));
  FDRE \Not_Dual.ALLOUT_ND.READ_REG_GEN[3].reg1_reg[31] 
       (.C(s_axi_aclk),
        .CE(1'b1),
        .D(gpio_io_o[0]),
        .Q(reg1[31]),
        .R(Read_Reg_Rst__0));
  FDRE #(
    .INIT(1'b0)) 
    \Not_Dual.gpio_Data_Out_reg[0] 
       (.C(s_axi_aclk),
        .CE(E),
        .D(D[3]),
        .Q(gpio_io_o[3]),
        .R(SR));
  FDRE #(
    .INIT(1'b0)) 
    \Not_Dual.gpio_Data_Out_reg[1] 
       (.C(s_axi_aclk),
        .CE(E),
        .D(D[2]),
        .Q(gpio_io_o[2]),
        .R(SR));
  FDRE #(
    .INIT(1'b0)) 
    \Not_Dual.gpio_Data_Out_reg[2] 
       (.C(s_axi_aclk),
        .CE(E),
        .D(D[1]),
        .Q(gpio_io_o[1]),
        .R(SR));
  FDRE #(
    .INIT(1'b0)) 
    \Not_Dual.gpio_Data_Out_reg[3] 
       (.C(s_axi_aclk),
        .CE(E),
        .D(D[0]),
        .Q(gpio_io_o[0]),
        .R(SR));
  LUT4 #(
    .INIT(16'hFFDF)) 
    Read_Reg_Rst
       (.I0(bus2ip_rnw),
        .I1(GPIO_xferAck_i),
        .I2(bus2ip_cs),
        .I3(gpio_xferAck_Reg),
        .O(Read_Reg_Rst__0));
  FDRE gpio_xferAck_Reg_reg
       (.C(s_axi_aclk),
        .CE(1'b1),
        .D(GPIO_xferAck_i),
        .Q(gpio_xferAck_Reg),
        .R(SR));
  (* SOFT_HLUTNM = "soft_lutpair6" *) 
  LUT3 #(
    .INIT(8'h02)) 
    iGPIO_xferAck
       (.I0(bus2ip_cs),
        .I1(gpio_xferAck_Reg),
        .I2(GPIO_xferAck_i),
        .O(iGPIO_xferAck__0));
  FDRE iGPIO_xferAck_reg
       (.C(s_axi_aclk),
        .CE(1'b1),
        .D(iGPIO_xferAck__0),
        .Q(GPIO_xferAck_i),
        .R(SR));
  LUT5 #(
    .INIT(32'h00001400)) 
    \ip2bus_data_i_D1[0]_i_1 
       (.I0(\GEN_BKEND_CE_REGISTERS[0].ce_out_i_reg ),
        .I1(\GEN_BKEND_CE_REGISTERS[3].ce_out_i_reg ),
        .I2(\GEN_BKEND_CE_REGISTERS[1].ce_out_i_reg ),
        .I3(Bus_RNW_reg),
        .I4(\GEN_BKEND_CE_REGISTERS[2].ce_out_i_reg ),
        .O(\GEN_BKEND_CE_REGISTERS[0].ce_out_i_reg[0] [4]));
  LUT6 #(
    .INIT(64'h0011000011400000)) 
    \ip2bus_data_i_D1[28]_i_1 
       (.I0(\GEN_BKEND_CE_REGISTERS[2].ce_out_i_reg ),
        .I1(\GEN_BKEND_CE_REGISTERS[0].ce_out_i_reg ),
        .I2(reg1[28]),
        .I3(\GEN_BKEND_CE_REGISTERS[1].ce_out_i_reg ),
        .I4(Bus_RNW_reg),
        .I5(\GEN_BKEND_CE_REGISTERS[3].ce_out_i_reg ),
        .O(\GEN_BKEND_CE_REGISTERS[0].ce_out_i_reg[0] [3]));
  LUT6 #(
    .INIT(64'h0011000011400000)) 
    \ip2bus_data_i_D1[29]_i_1 
       (.I0(\GEN_BKEND_CE_REGISTERS[2].ce_out_i_reg ),
        .I1(\GEN_BKEND_CE_REGISTERS[0].ce_out_i_reg ),
        .I2(reg1[29]),
        .I3(\GEN_BKEND_CE_REGISTERS[1].ce_out_i_reg ),
        .I4(Bus_RNW_reg),
        .I5(\GEN_BKEND_CE_REGISTERS[3].ce_out_i_reg ),
        .O(\GEN_BKEND_CE_REGISTERS[0].ce_out_i_reg[0] [2]));
  LUT6 #(
    .INIT(64'h0011000011400000)) 
    \ip2bus_data_i_D1[30]_i_1 
       (.I0(\GEN_BKEND_CE_REGISTERS[2].ce_out_i_reg ),
        .I1(\GEN_BKEND_CE_REGISTERS[0].ce_out_i_reg ),
        .I2(reg1[30]),
        .I3(\GEN_BKEND_CE_REGISTERS[1].ce_out_i_reg ),
        .I4(Bus_RNW_reg),
        .I5(\GEN_BKEND_CE_REGISTERS[3].ce_out_i_reg ),
        .O(\GEN_BKEND_CE_REGISTERS[0].ce_out_i_reg[0] [1]));
  LUT6 #(
    .INIT(64'h0011000011400000)) 
    \ip2bus_data_i_D1[31]_i_1 
       (.I0(\GEN_BKEND_CE_REGISTERS[2].ce_out_i_reg ),
        .I1(\GEN_BKEND_CE_REGISTERS[0].ce_out_i_reg ),
        .I2(reg1[31]),
        .I3(\GEN_BKEND_CE_REGISTERS[1].ce_out_i_reg ),
        .I4(Bus_RNW_reg),
        .I5(\GEN_BKEND_CE_REGISTERS[3].ce_out_i_reg ),
        .O(\GEN_BKEND_CE_REGISTERS[0].ce_out_i_reg[0] [0]));
  LUT2 #(
    .INIT(4'h8)) 
    ip2bus_rdack_i_D1_i_1
       (.I0(GPIO_xferAck_i),
        .I1(bus2ip_rnw),
        .O(ip2bus_rdack_i));
  (* SOFT_HLUTNM = "soft_lutpair6" *) 
  LUT2 #(
    .INIT(4'h2)) 
    ip2bus_wrack_i_D1_i_1
       (.I0(GPIO_xferAck_i),
        .I1(bus2ip_rnw),
        .O(ip2bus_wrack_i));
endmodule

(* CHECK_LICENSE_TYPE = "Main_axi_gpio_0_1,axi_gpio,{}" *) (* downgradeipidentifiedwarnings = "yes" *) (* x_core_info = "axi_gpio,Vivado 2022.1" *) 
(* NotValidForBitStream *)
module decalper_eb_ot_sdeen_pot_pi_dehcac_xnilix
   (s_axi_aclk,
    s_axi_aresetn,
    s_axi_awaddr,
    s_axi_awvalid,
    s_axi_awready,
    s_axi_wdata,
    s_axi_wstrb,
    s_axi_wvalid,
    s_axi_wready,
    s_axi_bresp,
    s_axi_bvalid,
    s_axi_bready,
    s_axi_araddr,
    s_axi_arvalid,
    s_axi_arready,
    s_axi_rdata,
    s_axi_rresp,
    s_axi_rvalid,
    s_axi_rready,
    gpio_io_o);
  (* x_interface_info = "xilinx.com:signal:clock:1.0 S_AXI_ACLK CLK" *) (* x_interface_parameter = "XIL_INTERFACENAME S_AXI_ACLK, ASSOCIATED_BUSIF S_AXI, ASSOCIATED_RESET s_axi_aresetn, FREQ_HZ 100000000, FREQ_TOLERANCE_HZ 0, PHASE 0.0, CLK_DOMAIN /clk_wiz_0_clk_out1, INSERT_VIP 0" *) input s_axi_aclk;
  (* x_interface_info = "xilinx.com:signal:reset:1.0 S_AXI_ARESETN RST" *) (* x_interface_parameter = "XIL_INTERFACENAME S_AXI_ARESETN, POLARITY ACTIVE_LOW, INSERT_VIP 0" *) input s_axi_aresetn;
  (* x_interface_info = "xilinx.com:interface:aximm:1.0 S_AXI AWADDR" *) (* x_interface_parameter = "XIL_INTERFACENAME S_AXI, DATA_WIDTH 32, PROTOCOL AXI4LITE, FREQ_HZ 100000000, ID_WIDTH 0, ADDR_WIDTH 9, AWUSER_WIDTH 0, ARUSER_WIDTH 0, WUSER_WIDTH 0, RUSER_WIDTH 0, BUSER_WIDTH 0, READ_WRITE_MODE READ_WRITE, HAS_BURST 0, HAS_LOCK 0, HAS_PROT 0, HAS_CACHE 0, HAS_QOS 0, HAS_REGION 0, HAS_WSTRB 1, HAS_BRESP 1, HAS_RRESP 1, SUPPORTS_NARROW_BURST 0, NUM_READ_OUTSTANDING 1, NUM_WRITE_OUTSTANDING 1, MAX_BURST_LENGTH 1, PHASE 0.0, CLK_DOMAIN /clk_wiz_0_clk_out1, NUM_READ_THREADS 1, NUM_WRITE_THREADS 1, RUSER_BITS_PER_BYTE 0, WUSER_BITS_PER_BYTE 0, INSERT_VIP 0" *) input [8:0]s_axi_awaddr;
  (* x_interface_info = "xilinx.com:interface:aximm:1.0 S_AXI AWVALID" *) input s_axi_awvalid;
  (* x_interface_info = "xilinx.com:interface:aximm:1.0 S_AXI AWREADY" *) output s_axi_awready;
  (* x_interface_info = "xilinx.com:interface:aximm:1.0 S_AXI WDATA" *) input [31:0]s_axi_wdata;
  (* x_interface_info = "xilinx.com:interface:aximm:1.0 S_AXI WSTRB" *) input [3:0]s_axi_wstrb;
  (* x_interface_info = "xilinx.com:interface:aximm:1.0 S_AXI WVALID" *) input s_axi_wvalid;
  (* x_interface_info = "xilinx.com:interface:aximm:1.0 S_AXI WREADY" *) output s_axi_wready;
  (* x_interface_info = "xilinx.com:interface:aximm:1.0 S_AXI BRESP" *) output [1:0]s_axi_bresp;
  (* x_interface_info = "xilinx.com:interface:aximm:1.0 S_AXI BVALID" *) output s_axi_bvalid;
  (* x_interface_info = "xilinx.com:interface:aximm:1.0 S_AXI BREADY" *) input s_axi_bready;
  (* x_interface_info = "xilinx.com:interface:aximm:1.0 S_AXI ARADDR" *) input [8:0]s_axi_araddr;
  (* x_interface_info = "xilinx.com:interface:aximm:1.0 S_AXI ARVALID" *) input s_axi_arvalid;
  (* x_interface_info = "xilinx.com:interface:aximm:1.0 S_AXI ARREADY" *) output s_axi_arready;
  (* x_interface_info = "xilinx.com:interface:aximm:1.0 S_AXI RDATA" *) output [31:0]s_axi_rdata;
  (* x_interface_info = "xilinx.com:interface:aximm:1.0 S_AXI RRESP" *) output [1:0]s_axi_rresp;
  (* x_interface_info = "xilinx.com:interface:aximm:1.0 S_AXI RVALID" *) output s_axi_rvalid;
  (* x_interface_info = "xilinx.com:interface:aximm:1.0 S_AXI RREADY" *) input s_axi_rready;
  (* x_interface_info = "xilinx.com:interface:gpio:1.0 GPIO TRI_O" *) (* x_interface_parameter = "XIL_INTERFACENAME GPIO, BOARD.ASSOCIATED_PARAM GPIO_BOARD_INTERFACE" *) output [3:0]gpio_io_o;

  wire \<const0> ;
  wire [3:0]gpio_io_o;
  wire s_axi_aclk;
  wire [8:0]s_axi_araddr;
  wire s_axi_aresetn;
  wire s_axi_arready;
  wire s_axi_arvalid;
  wire [8:0]s_axi_awaddr;
  wire s_axi_awready;
  wire s_axi_awvalid;
  wire s_axi_bready;
  wire s_axi_bvalid;
  wire [31:0]s_axi_rdata;
  wire s_axi_rready;
  wire s_axi_rvalid;
  wire [31:0]s_axi_wdata;
  wire s_axi_wready;
  wire s_axi_wvalid;
  wire NLW_U0_ip2intc_irpt_UNCONNECTED;
  wire [31:0]NLW_U0_gpio2_io_o_UNCONNECTED;
  wire [31:0]NLW_U0_gpio2_io_t_UNCONNECTED;
  wire [3:0]NLW_U0_gpio_io_t_UNCONNECTED;
  wire [1:0]NLW_U0_s_axi_bresp_UNCONNECTED;
  wire [1:0]NLW_U0_s_axi_rresp_UNCONNECTED;

  assign s_axi_bresp[1] = \<const0> ;
  assign s_axi_bresp[0] = \<const0> ;
  assign s_axi_rresp[1] = \<const0> ;
  assign s_axi_rresp[0] = \<const0> ;
  GND GND
       (.G(\<const0> ));
  (* C_ALL_INPUTS = "0" *) 
  (* C_ALL_INPUTS_2 = "0" *) 
  (* C_ALL_OUTPUTS = "1" *) 
  (* C_ALL_OUTPUTS_2 = "0" *) 
  (* C_DOUT_DEFAULT = "0" *) 
  (* C_DOUT_DEFAULT_2 = "0" *) 
  (* C_FAMILY = "spartan7" *) 
  (* C_GPIO2_WIDTH = "32" *) 
  (* C_GPIO_WIDTH = "4" *) 
  (* C_INTERRUPT_PRESENT = "0" *) 
  (* C_IS_DUAL = "0" *) 
  (* C_S_AXI_ADDR_WIDTH = "9" *) 
  (* C_S_AXI_DATA_WIDTH = "32" *) 
  (* C_TRI_DEFAULT = "-1" *) 
  (* C_TRI_DEFAULT_2 = "-1" *) 
  (* downgradeipidentifiedwarnings = "yes" *) 
  (* ip_group = "LOGICORE" *) 
  decalper_eb_ot_sdeen_pot_pi_dehcac_xnilix_axi_gpio U0
       (.gpio2_io_i({1'b0,1'b0,1'b0,1'b0,1'b0,1'b0,1'b0,1'b0,1'b0,1'b0,1'b0,1'b0,1'b0,1'b0,1'b0,1'b0,1'b0,1'b0,1'b0,1'b0,1'b0,1'b0,1'b0,1'b0,1'b0,1'b0,1'b0,1'b0,1'b0,1'b0,1'b0,1'b0}),
        .gpio2_io_o(NLW_U0_gpio2_io_o_UNCONNECTED[31:0]),
        .gpio2_io_t(NLW_U0_gpio2_io_t_UNCONNECTED[31:0]),
        .gpio_io_i({1'b0,1'b0,1'b0,1'b0}),
        .gpio_io_o(gpio_io_o),
        .gpio_io_t(NLW_U0_gpio_io_t_UNCONNECTED[3:0]),
        .ip2intc_irpt(NLW_U0_ip2intc_irpt_UNCONNECTED),
        .s_axi_aclk(s_axi_aclk),
        .s_axi_araddr({s_axi_araddr[8],1'b0,1'b0,1'b0,1'b0,s_axi_araddr[3:2],1'b0,1'b0}),
        .s_axi_aresetn(s_axi_aresetn),
        .s_axi_arready(s_axi_arready),
        .s_axi_arvalid(s_axi_arvalid),
        .s_axi_awaddr({s_axi_awaddr[8],1'b0,1'b0,1'b0,1'b0,s_axi_awaddr[3:2],1'b0,1'b0}),
        .s_axi_awready(s_axi_awready),
        .s_axi_awvalid(s_axi_awvalid),
        .s_axi_bready(s_axi_bready),
        .s_axi_bresp(NLW_U0_s_axi_bresp_UNCONNECTED[1:0]),
        .s_axi_bvalid(s_axi_bvalid),
        .s_axi_rdata(s_axi_rdata),
        .s_axi_rready(s_axi_rready),
        .s_axi_rresp(NLW_U0_s_axi_rresp_UNCONNECTED[1:0]),
        .s_axi_rvalid(s_axi_rvalid),
        .s_axi_wdata({s_axi_wdata[31:28],1'b0,1'b0,1'b0,1'b0,1'b0,1'b0,1'b0,1'b0,1'b0,1'b0,1'b0,1'b0,1'b0,1'b0,1'b0,1'b0,1'b0,1'b0,1'b0,1'b0,1'b0,1'b0,1'b0,1'b0,s_axi_wdata[3:0]}),
        .s_axi_wready(s_axi_wready),
        .s_axi_wstrb({1'b0,1'b0,1'b0,1'b0}),
        .s_axi_wvalid(s_axi_wvalid));
endmodule

module decalper_eb_ot_sdeen_pot_pi_dehcac_xnilix_address_decoder
   (\GEN_BKEND_CE_REGISTERS[3].ce_out_i_reg ,
    \GEN_BKEND_CE_REGISTERS[2].ce_out_i_reg ,
    \GEN_BKEND_CE_REGISTERS[1].ce_out_i_reg ,
    \GEN_BKEND_CE_REGISTERS[0].ce_out_i_reg ,
    Bus_RNW_reg,
    \MEM_DECODE_GEN[0].cs_out_i_reg[0]_0 ,
    E,
    ip2bus_rdack_i_D1_reg,
    ip2bus_wrack_i_D1_reg,
    D,
    Q,
    s_axi_aclk,
    \Not_Dual.gpio_Data_Out_reg[0] ,
    bus2ip_rnw,
    s_axi_aresetn,
    ip2bus_rdack_i_D1,
    s_axi_arready,
    s_axi_arready_0,
    ip2bus_wrack_i_D1,
    s_axi_awready,
    s_axi_wdata);
  output \GEN_BKEND_CE_REGISTERS[3].ce_out_i_reg ;
  output \GEN_BKEND_CE_REGISTERS[2].ce_out_i_reg ;
  output \GEN_BKEND_CE_REGISTERS[1].ce_out_i_reg ;
  output \GEN_BKEND_CE_REGISTERS[0].ce_out_i_reg ;
  output Bus_RNW_reg;
  output \MEM_DECODE_GEN[0].cs_out_i_reg[0]_0 ;
  output [0:0]E;
  output ip2bus_rdack_i_D1_reg;
  output ip2bus_wrack_i_D1_reg;
  output [3:0]D;
  input Q;
  input s_axi_aclk;
  input [2:0]\Not_Dual.gpio_Data_Out_reg[0] ;
  input bus2ip_rnw;
  input s_axi_aresetn;
  input ip2bus_rdack_i_D1;
  input s_axi_arready;
  input [3:0]s_axi_arready_0;
  input ip2bus_wrack_i_D1;
  input s_axi_awready;
  input [7:0]s_axi_wdata;

  wire Bus_RNW_reg;
  wire Bus_RNW_reg_i_1_n_0;
  wire [3:0]D;
  wire [0:0]E;
  wire \GEN_BKEND_CE_REGISTERS[0].ce_out_i_reg ;
  wire \GEN_BKEND_CE_REGISTERS[1].ce_out_i_reg ;
  wire \GEN_BKEND_CE_REGISTERS[2].ce_out_i_reg ;
  wire \GEN_BKEND_CE_REGISTERS[3].ce_out_i_reg ;
  wire \MEM_DECODE_GEN[0].cs_out_i[0]_i_1_n_0 ;
  wire \MEM_DECODE_GEN[0].cs_out_i_reg[0]_0 ;
  wire [2:0]\Not_Dual.gpio_Data_Out_reg[0] ;
  wire Q;
  wire bus2ip_rnw;
  wire ce_expnd_i_0;
  wire ce_expnd_i_1;
  wire ce_expnd_i_2;
  wire ce_expnd_i_3;
  wire cs_ce_clr;
  wire ip2bus_rdack_i_D1;
  wire ip2bus_rdack_i_D1_reg;
  wire ip2bus_wrack_i_D1;
  wire ip2bus_wrack_i_D1_reg;
  wire s_axi_aclk;
  wire s_axi_aresetn;
  wire s_axi_arready;
  wire [3:0]s_axi_arready_0;
  wire s_axi_awready;
  wire [7:0]s_axi_wdata;

  LUT3 #(
    .INIT(8'hB8)) 
    Bus_RNW_reg_i_1
       (.I0(bus2ip_rnw),
        .I1(Q),
        .I2(Bus_RNW_reg),
        .O(Bus_RNW_reg_i_1_n_0));
  FDRE Bus_RNW_reg_reg
       (.C(s_axi_aclk),
        .CE(1'b1),
        .D(Bus_RNW_reg_i_1_n_0),
        .Q(Bus_RNW_reg),
        .R(1'b0));
  FDRE \GEN_BKEND_CE_REGISTERS[0].ce_out_i_reg[0] 
       (.C(s_axi_aclk),
        .CE(Q),
        .D(ce_expnd_i_3),
        .Q(\GEN_BKEND_CE_REGISTERS[0].ce_out_i_reg ),
        .R(cs_ce_clr));
  (* SOFT_HLUTNM = "soft_lutpair1" *) 
  LUT2 #(
    .INIT(4'h2)) 
    \GEN_BKEND_CE_REGISTERS[1].ce_out_i[1]_i_1 
       (.I0(\Not_Dual.gpio_Data_Out_reg[0] [0]),
        .I1(\Not_Dual.gpio_Data_Out_reg[0] [1]),
        .O(ce_expnd_i_2));
  FDRE \GEN_BKEND_CE_REGISTERS[1].ce_out_i_reg[1] 
       (.C(s_axi_aclk),
        .CE(Q),
        .D(ce_expnd_i_2),
        .Q(\GEN_BKEND_CE_REGISTERS[1].ce_out_i_reg ),
        .R(cs_ce_clr));
  FDRE \GEN_BKEND_CE_REGISTERS[2].ce_out_i_reg[2] 
       (.C(s_axi_aclk),
        .CE(Q),
        .D(ce_expnd_i_1),
        .Q(\GEN_BKEND_CE_REGISTERS[2].ce_out_i_reg ),
        .R(cs_ce_clr));
  LUT3 #(
    .INIT(8'hEF)) 
    \GEN_BKEND_CE_REGISTERS[3].ce_out_i[3]_i_1 
       (.I0(ip2bus_wrack_i_D1_reg),
        .I1(ip2bus_rdack_i_D1_reg),
        .I2(s_axi_aresetn),
        .O(cs_ce_clr));
  (* SOFT_HLUTNM = "soft_lutpair0" *) 
  LUT2 #(
    .INIT(4'h8)) 
    \GEN_BKEND_CE_REGISTERS[3].ce_out_i[3]_i_2 
       (.I0(\Not_Dual.gpio_Data_Out_reg[0] [1]),
        .I1(\Not_Dual.gpio_Data_Out_reg[0] [0]),
        .O(ce_expnd_i_0));
  FDRE \GEN_BKEND_CE_REGISTERS[3].ce_out_i_reg[3] 
       (.C(s_axi_aclk),
        .CE(Q),
        .D(ce_expnd_i_0),
        .Q(\GEN_BKEND_CE_REGISTERS[3].ce_out_i_reg ),
        .R(cs_ce_clr));
  decalper_eb_ot_sdeen_pot_pi_dehcac_xnilix_pselect_f \MEM_DECODE_GEN[0].PER_CE_GEN[0].MULTIPLE_CES_THIS_CS_GEN.CE_I 
       (.\GEN_BKEND_CE_REGISTERS[0].ce_out_i_reg[0] (\Not_Dual.gpio_Data_Out_reg[0] [1:0]),
        .ce_expnd_i_3(ce_expnd_i_3));
  decalper_eb_ot_sdeen_pot_pi_dehcac_xnilix_pselect_f__parameterized1 \MEM_DECODE_GEN[0].PER_CE_GEN[2].MULTIPLE_CES_THIS_CS_GEN.CE_I 
       (.\GEN_BKEND_CE_REGISTERS[2].ce_out_i_reg[2] (\Not_Dual.gpio_Data_Out_reg[0] [1:0]),
        .ce_expnd_i_1(ce_expnd_i_1));
  LUT5 #(
    .INIT(32'h000000E0)) 
    \MEM_DECODE_GEN[0].cs_out_i[0]_i_1 
       (.I0(\MEM_DECODE_GEN[0].cs_out_i_reg[0]_0 ),
        .I1(Q),
        .I2(s_axi_aresetn),
        .I3(ip2bus_rdack_i_D1_reg),
        .I4(ip2bus_wrack_i_D1_reg),
        .O(\MEM_DECODE_GEN[0].cs_out_i[0]_i_1_n_0 ));
  FDRE \MEM_DECODE_GEN[0].cs_out_i_reg[0] 
       (.C(s_axi_aclk),
        .CE(1'b1),
        .D(\MEM_DECODE_GEN[0].cs_out_i[0]_i_1_n_0 ),
        .Q(\MEM_DECODE_GEN[0].cs_out_i_reg[0]_0 ),
        .R(1'b0));
  (* SOFT_HLUTNM = "soft_lutpair0" *) 
  LUT5 #(
    .INIT(32'h00000004)) 
    \Not_Dual.gpio_Data_Out[0]_i_1 
       (.I0(\Not_Dual.gpio_Data_Out_reg[0] [2]),
        .I1(\MEM_DECODE_GEN[0].cs_out_i_reg[0]_0 ),
        .I2(\Not_Dual.gpio_Data_Out_reg[0] [0]),
        .I3(bus2ip_rnw),
        .I4(\Not_Dual.gpio_Data_Out_reg[0] [1]),
        .O(E));
  LUT4 #(
    .INIT(16'hFB08)) 
    \Not_Dual.gpio_Data_Out[0]_i_2 
       (.I0(s_axi_wdata[3]),
        .I1(\MEM_DECODE_GEN[0].cs_out_i_reg[0]_0 ),
        .I2(\Not_Dual.gpio_Data_Out_reg[0] [1]),
        .I3(s_axi_wdata[7]),
        .O(D[3]));
  LUT4 #(
    .INIT(16'hFB08)) 
    \Not_Dual.gpio_Data_Out[1]_i_1 
       (.I0(s_axi_wdata[2]),
        .I1(\MEM_DECODE_GEN[0].cs_out_i_reg[0]_0 ),
        .I2(\Not_Dual.gpio_Data_Out_reg[0] [1]),
        .I3(s_axi_wdata[6]),
        .O(D[2]));
  LUT4 #(
    .INIT(16'hFB08)) 
    \Not_Dual.gpio_Data_Out[2]_i_1 
       (.I0(s_axi_wdata[1]),
        .I1(\MEM_DECODE_GEN[0].cs_out_i_reg[0]_0 ),
        .I2(\Not_Dual.gpio_Data_Out_reg[0] [1]),
        .I3(s_axi_wdata[5]),
        .O(D[1]));
  (* SOFT_HLUTNM = "soft_lutpair1" *) 
  LUT4 #(
    .INIT(16'hFB08)) 
    \Not_Dual.gpio_Data_Out[3]_i_1 
       (.I0(s_axi_wdata[0]),
        .I1(\MEM_DECODE_GEN[0].cs_out_i_reg[0]_0 ),
        .I2(\Not_Dual.gpio_Data_Out_reg[0] [1]),
        .I3(s_axi_wdata[4]),
        .O(D[0]));
  LUT6 #(
    .INIT(64'hAAAAAAAAAAAEAAAA)) 
    s_axi_arready_INST_0
       (.I0(ip2bus_rdack_i_D1),
        .I1(s_axi_arready),
        .I2(s_axi_arready_0[2]),
        .I3(s_axi_arready_0[1]),
        .I4(s_axi_arready_0[3]),
        .I5(s_axi_arready_0[0]),
        .O(ip2bus_rdack_i_D1_reg));
  LUT6 #(
    .INIT(64'hAAAAAAAAAAAEAAAA)) 
    s_axi_wready_INST_0
       (.I0(ip2bus_wrack_i_D1),
        .I1(s_axi_awready),
        .I2(s_axi_arready_0[2]),
        .I3(s_axi_arready_0[1]),
        .I4(s_axi_arready_0[3]),
        .I5(s_axi_arready_0[0]),
        .O(ip2bus_wrack_i_D1_reg));
endmodule

(* C_ALL_INPUTS = "0" *) (* C_ALL_INPUTS_2 = "0" *) (* C_ALL_OUTPUTS = "1" *) 
(* C_ALL_OUTPUTS_2 = "0" *) (* C_DOUT_DEFAULT = "0" *) (* C_DOUT_DEFAULT_2 = "0" *) 
(* C_FAMILY = "spartan7" *) (* C_GPIO2_WIDTH = "32" *) (* C_GPIO_WIDTH = "4" *) 
(* C_INTERRUPT_PRESENT = "0" *) (* C_IS_DUAL = "0" *) (* C_S_AXI_ADDR_WIDTH = "9" *) 
(* C_S_AXI_DATA_WIDTH = "32" *) (* C_TRI_DEFAULT = "-1" *) (* C_TRI_DEFAULT_2 = "-1" *) 
(* downgradeipidentifiedwarnings = "yes" *) (* ip_group = "LOGICORE" *) 
module decalper_eb_ot_sdeen_pot_pi_dehcac_xnilix_axi_gpio
   (s_axi_aclk,
    s_axi_aresetn,
    s_axi_awaddr,
    s_axi_awvalid,
    s_axi_awready,
    s_axi_wdata,
    s_axi_wstrb,
    s_axi_wvalid,
    s_axi_wready,
    s_axi_bresp,
    s_axi_bvalid,
    s_axi_bready,
    s_axi_araddr,
    s_axi_arvalid,
    s_axi_arready,
    s_axi_rdata,
    s_axi_rresp,
    s_axi_rvalid,
    s_axi_rready,
    ip2intc_irpt,
    gpio_io_i,
    gpio_io_o,
    gpio_io_t,
    gpio2_io_i,
    gpio2_io_o,
    gpio2_io_t);
  (* sigis = "Clk" *) input s_axi_aclk;
  (* sigis = "Rst" *) input s_axi_aresetn;
  input [8:0]s_axi_awaddr;
  input s_axi_awvalid;
  output s_axi_awready;
  input [31:0]s_axi_wdata;
  input [3:0]s_axi_wstrb;
  input s_axi_wvalid;
  output s_axi_wready;
  output [1:0]s_axi_bresp;
  output s_axi_bvalid;
  input s_axi_bready;
  input [8:0]s_axi_araddr;
  input s_axi_arvalid;
  output s_axi_arready;
  output [31:0]s_axi_rdata;
  output [1:0]s_axi_rresp;
  output s_axi_rvalid;
  input s_axi_rready;
  (* sigis = "INTR_LEVEL_HIGH" *) output ip2intc_irpt;
  input [3:0]gpio_io_i;
  output [3:0]gpio_io_o;
  output [3:0]gpio_io_t;
  input [31:0]gpio2_io_i;
  output [31:0]gpio2_io_o;
  output [31:0]gpio2_io_t;

  wire \<const0> ;
  wire AXI_LITE_IPIF_I_n_10;
  wire [0:3]DBus_Reg;
  wire \I_SLAVE_ATTACHMENT/I_DECODER/Bus_RNW_reg ;
  wire \I_SLAVE_ATTACHMENT/I_DECODER/GEN_BKEND_CE_REGISTERS[0].ce_out_i_reg ;
  wire \I_SLAVE_ATTACHMENT/I_DECODER/GEN_BKEND_CE_REGISTERS[1].ce_out_i_reg ;
  wire \I_SLAVE_ATTACHMENT/I_DECODER/GEN_BKEND_CE_REGISTERS[2].ce_out_i_reg ;
  wire \I_SLAVE_ATTACHMENT/I_DECODER/GEN_BKEND_CE_REGISTERS[3].ce_out_i_reg ;
  wire bus2ip_cs;
  wire bus2ip_reset;
  wire bus2ip_rnw;
  wire [3:0]gpio_io_o;
  wire [0:31]ip2bus_data;
  wire [0:31]ip2bus_data_i_D1;
  wire ip2bus_rdack_i;
  wire ip2bus_rdack_i_D1;
  wire ip2bus_wrack_i;
  wire ip2bus_wrack_i_D1;
  wire s_axi_aclk;
  wire [8:0]s_axi_araddr;
  wire s_axi_aresetn;
  wire s_axi_arready;
  wire s_axi_arvalid;
  wire [8:0]s_axi_awaddr;
  wire s_axi_awready;
  wire s_axi_awvalid;
  wire s_axi_bready;
  wire s_axi_bvalid;
  wire [30:0]\^s_axi_rdata ;
  wire s_axi_rready;
  wire s_axi_rvalid;
  wire [31:0]s_axi_wdata;
  wire s_axi_wvalid;

  assign gpio2_io_o[31] = \<const0> ;
  assign gpio2_io_o[30] = \<const0> ;
  assign gpio2_io_o[29] = \<const0> ;
  assign gpio2_io_o[28] = \<const0> ;
  assign gpio2_io_o[27] = \<const0> ;
  assign gpio2_io_o[26] = \<const0> ;
  assign gpio2_io_o[25] = \<const0> ;
  assign gpio2_io_o[24] = \<const0> ;
  assign gpio2_io_o[23] = \<const0> ;
  assign gpio2_io_o[22] = \<const0> ;
  assign gpio2_io_o[21] = \<const0> ;
  assign gpio2_io_o[20] = \<const0> ;
  assign gpio2_io_o[19] = \<const0> ;
  assign gpio2_io_o[18] = \<const0> ;
  assign gpio2_io_o[17] = \<const0> ;
  assign gpio2_io_o[16] = \<const0> ;
  assign gpio2_io_o[15] = \<const0> ;
  assign gpio2_io_o[14] = \<const0> ;
  assign gpio2_io_o[13] = \<const0> ;
  assign gpio2_io_o[12] = \<const0> ;
  assign gpio2_io_o[11] = \<const0> ;
  assign gpio2_io_o[10] = \<const0> ;
  assign gpio2_io_o[9] = \<const0> ;
  assign gpio2_io_o[8] = \<const0> ;
  assign gpio2_io_o[7] = \<const0> ;
  assign gpio2_io_o[6] = \<const0> ;
  assign gpio2_io_o[5] = \<const0> ;
  assign gpio2_io_o[4] = \<const0> ;
  assign gpio2_io_o[3] = \<const0> ;
  assign gpio2_io_o[2] = \<const0> ;
  assign gpio2_io_o[1] = \<const0> ;
  assign gpio2_io_o[0] = \<const0> ;
  assign gpio2_io_t[31] = \<const0> ;
  assign gpio2_io_t[30] = \<const0> ;
  assign gpio2_io_t[29] = \<const0> ;
  assign gpio2_io_t[28] = \<const0> ;
  assign gpio2_io_t[27] = \<const0> ;
  assign gpio2_io_t[26] = \<const0> ;
  assign gpio2_io_t[25] = \<const0> ;
  assign gpio2_io_t[24] = \<const0> ;
  assign gpio2_io_t[23] = \<const0> ;
  assign gpio2_io_t[22] = \<const0> ;
  assign gpio2_io_t[21] = \<const0> ;
  assign gpio2_io_t[20] = \<const0> ;
  assign gpio2_io_t[19] = \<const0> ;
  assign gpio2_io_t[18] = \<const0> ;
  assign gpio2_io_t[17] = \<const0> ;
  assign gpio2_io_t[16] = \<const0> ;
  assign gpio2_io_t[15] = \<const0> ;
  assign gpio2_io_t[14] = \<const0> ;
  assign gpio2_io_t[13] = \<const0> ;
  assign gpio2_io_t[12] = \<const0> ;
  assign gpio2_io_t[11] = \<const0> ;
  assign gpio2_io_t[10] = \<const0> ;
  assign gpio2_io_t[9] = \<const0> ;
  assign gpio2_io_t[8] = \<const0> ;
  assign gpio2_io_t[7] = \<const0> ;
  assign gpio2_io_t[6] = \<const0> ;
  assign gpio2_io_t[5] = \<const0> ;
  assign gpio2_io_t[4] = \<const0> ;
  assign gpio2_io_t[3] = \<const0> ;
  assign gpio2_io_t[2] = \<const0> ;
  assign gpio2_io_t[1] = \<const0> ;
  assign gpio2_io_t[0] = \<const0> ;
  assign gpio_io_t[3] = \<const0> ;
  assign gpio_io_t[2] = \<const0> ;
  assign gpio_io_t[1] = \<const0> ;
  assign gpio_io_t[0] = \<const0> ;
  assign ip2intc_irpt = \<const0> ;
  assign s_axi_bresp[1] = \<const0> ;
  assign s_axi_bresp[0] = \<const0> ;
  assign s_axi_rdata[31] = \^s_axi_rdata [30];
  assign s_axi_rdata[30] = \^s_axi_rdata [30];
  assign s_axi_rdata[29] = \^s_axi_rdata [30];
  assign s_axi_rdata[28] = \^s_axi_rdata [30];
  assign s_axi_rdata[27] = \^s_axi_rdata [30];
  assign s_axi_rdata[26] = \^s_axi_rdata [30];
  assign s_axi_rdata[25] = \^s_axi_rdata [30];
  assign s_axi_rdata[24] = \^s_axi_rdata [30];
  assign s_axi_rdata[23] = \^s_axi_rdata [30];
  assign s_axi_rdata[22] = \^s_axi_rdata [30];
  assign s_axi_rdata[21] = \^s_axi_rdata [30];
  assign s_axi_rdata[20] = \^s_axi_rdata [30];
  assign s_axi_rdata[19] = \^s_axi_rdata [30];
  assign s_axi_rdata[18] = \^s_axi_rdata [30];
  assign s_axi_rdata[17] = \^s_axi_rdata [30];
  assign s_axi_rdata[16] = \^s_axi_rdata [30];
  assign s_axi_rdata[15] = \^s_axi_rdata [30];
  assign s_axi_rdata[14] = \^s_axi_rdata [30];
  assign s_axi_rdata[13] = \^s_axi_rdata [30];
  assign s_axi_rdata[12] = \^s_axi_rdata [30];
  assign s_axi_rdata[11] = \^s_axi_rdata [30];
  assign s_axi_rdata[10] = \^s_axi_rdata [30];
  assign s_axi_rdata[9] = \^s_axi_rdata [30];
  assign s_axi_rdata[8] = \^s_axi_rdata [30];
  assign s_axi_rdata[7] = \^s_axi_rdata [30];
  assign s_axi_rdata[6] = \^s_axi_rdata [30];
  assign s_axi_rdata[5] = \^s_axi_rdata [30];
  assign s_axi_rdata[4] = \^s_axi_rdata [30];
  assign s_axi_rdata[3:0] = \^s_axi_rdata [3:0];
  assign s_axi_rresp[1] = \<const0> ;
  assign s_axi_rresp[0] = \<const0> ;
  assign s_axi_wready = s_axi_awready;
  decalper_eb_ot_sdeen_pot_pi_dehcac_xnilix_axi_lite_ipif AXI_LITE_IPIF_I
       (.Bus_RNW_reg(\I_SLAVE_ATTACHMENT/I_DECODER/Bus_RNW_reg ),
        .D({DBus_Reg[0],DBus_Reg[1],DBus_Reg[2],DBus_Reg[3]}),
        .E(AXI_LITE_IPIF_I_n_10),
        .\GEN_BKEND_CE_REGISTERS[0].ce_out_i_reg (\I_SLAVE_ATTACHMENT/I_DECODER/GEN_BKEND_CE_REGISTERS[0].ce_out_i_reg ),
        .\GEN_BKEND_CE_REGISTERS[1].ce_out_i_reg (\I_SLAVE_ATTACHMENT/I_DECODER/GEN_BKEND_CE_REGISTERS[1].ce_out_i_reg ),
        .\GEN_BKEND_CE_REGISTERS[2].ce_out_i_reg (\I_SLAVE_ATTACHMENT/I_DECODER/GEN_BKEND_CE_REGISTERS[2].ce_out_i_reg ),
        .\GEN_BKEND_CE_REGISTERS[3].ce_out_i_reg (\I_SLAVE_ATTACHMENT/I_DECODER/GEN_BKEND_CE_REGISTERS[3].ce_out_i_reg ),
        .Q({ip2bus_data_i_D1[0],ip2bus_data_i_D1[28],ip2bus_data_i_D1[29],ip2bus_data_i_D1[30],ip2bus_data_i_D1[31]}),
        .bus2ip_cs(bus2ip_cs),
        .bus2ip_reset(bus2ip_reset),
        .bus2ip_rnw(bus2ip_rnw),
        .ip2bus_rdack_i_D1(ip2bus_rdack_i_D1),
        .ip2bus_rdack_i_D1_reg(s_axi_arready),
        .ip2bus_wrack_i_D1(ip2bus_wrack_i_D1),
        .ip2bus_wrack_i_D1_reg(s_axi_awready),
        .s_axi_aclk(s_axi_aclk),
        .s_axi_araddr({s_axi_araddr[8],s_axi_araddr[3:2]}),
        .s_axi_aresetn(s_axi_aresetn),
        .s_axi_arvalid(s_axi_arvalid),
        .s_axi_awaddr({s_axi_awaddr[8],s_axi_awaddr[3:2]}),
        .s_axi_awvalid(s_axi_awvalid),
        .s_axi_bready(s_axi_bready),
        .s_axi_bvalid_i_reg(s_axi_bvalid),
        .s_axi_rdata({\^s_axi_rdata [30],\^s_axi_rdata [3:0]}),
        .s_axi_rready(s_axi_rready),
        .s_axi_rvalid_i_reg(s_axi_rvalid),
        .s_axi_wdata({s_axi_wdata[31:28],s_axi_wdata[3:0]}),
        .s_axi_wvalid(s_axi_wvalid));
  GND GND
       (.G(\<const0> ));
  decalper_eb_ot_sdeen_pot_pi_dehcac_xnilix_GPIO_Core gpio_core_1
       (.Bus_RNW_reg(\I_SLAVE_ATTACHMENT/I_DECODER/Bus_RNW_reg ),
        .D({DBus_Reg[0],DBus_Reg[1],DBus_Reg[2],DBus_Reg[3]}),
        .E(AXI_LITE_IPIF_I_n_10),
        .\GEN_BKEND_CE_REGISTERS[0].ce_out_i_reg (\I_SLAVE_ATTACHMENT/I_DECODER/GEN_BKEND_CE_REGISTERS[0].ce_out_i_reg ),
        .\GEN_BKEND_CE_REGISTERS[0].ce_out_i_reg[0] ({ip2bus_data[0],ip2bus_data[28],ip2bus_data[29],ip2bus_data[30],ip2bus_data[31]}),
        .\GEN_BKEND_CE_REGISTERS[1].ce_out_i_reg (\I_SLAVE_ATTACHMENT/I_DECODER/GEN_BKEND_CE_REGISTERS[1].ce_out_i_reg ),
        .\GEN_BKEND_CE_REGISTERS[2].ce_out_i_reg (\I_SLAVE_ATTACHMENT/I_DECODER/GEN_BKEND_CE_REGISTERS[2].ce_out_i_reg ),
        .\GEN_BKEND_CE_REGISTERS[3].ce_out_i_reg (\I_SLAVE_ATTACHMENT/I_DECODER/GEN_BKEND_CE_REGISTERS[3].ce_out_i_reg ),
        .SR(bus2ip_reset),
        .bus2ip_cs(bus2ip_cs),
        .bus2ip_rnw(bus2ip_rnw),
        .gpio_io_o(gpio_io_o),
        .ip2bus_rdack_i(ip2bus_rdack_i),
        .ip2bus_wrack_i(ip2bus_wrack_i),
        .s_axi_aclk(s_axi_aclk));
  FDRE \ip2bus_data_i_D1_reg[0] 
       (.C(s_axi_aclk),
        .CE(1'b1),
        .D(ip2bus_data[0]),
        .Q(ip2bus_data_i_D1[0]),
        .R(bus2ip_reset));
  FDRE \ip2bus_data_i_D1_reg[28] 
       (.C(s_axi_aclk),
        .CE(1'b1),
        .D(ip2bus_data[28]),
        .Q(ip2bus_data_i_D1[28]),
        .R(bus2ip_reset));
  FDRE \ip2bus_data_i_D1_reg[29] 
       (.C(s_axi_aclk),
        .CE(1'b1),
        .D(ip2bus_data[29]),
        .Q(ip2bus_data_i_D1[29]),
        .R(bus2ip_reset));
  FDRE \ip2bus_data_i_D1_reg[30] 
       (.C(s_axi_aclk),
        .CE(1'b1),
        .D(ip2bus_data[30]),
        .Q(ip2bus_data_i_D1[30]),
        .R(bus2ip_reset));
  FDRE \ip2bus_data_i_D1_reg[31] 
       (.C(s_axi_aclk),
        .CE(1'b1),
        .D(ip2bus_data[31]),
        .Q(ip2bus_data_i_D1[31]),
        .R(bus2ip_reset));
  FDRE ip2bus_rdack_i_D1_reg
       (.C(s_axi_aclk),
        .CE(1'b1),
        .D(ip2bus_rdack_i),
        .Q(ip2bus_rdack_i_D1),
        .R(bus2ip_reset));
  FDRE ip2bus_wrack_i_D1_reg
       (.C(s_axi_aclk),
        .CE(1'b1),
        .D(ip2bus_wrack_i),
        .Q(ip2bus_wrack_i_D1),
        .R(bus2ip_reset));
endmodule

module decalper_eb_ot_sdeen_pot_pi_dehcac_xnilix_axi_lite_ipif
   (bus2ip_reset,
    \GEN_BKEND_CE_REGISTERS[3].ce_out_i_reg ,
    \GEN_BKEND_CE_REGISTERS[2].ce_out_i_reg ,
    \GEN_BKEND_CE_REGISTERS[1].ce_out_i_reg ,
    \GEN_BKEND_CE_REGISTERS[0].ce_out_i_reg ,
    bus2ip_rnw,
    Bus_RNW_reg,
    s_axi_rvalid_i_reg,
    s_axi_bvalid_i_reg,
    bus2ip_cs,
    E,
    ip2bus_rdack_i_D1_reg,
    ip2bus_wrack_i_D1_reg,
    s_axi_rdata,
    D,
    s_axi_aclk,
    s_axi_arvalid,
    s_axi_rready,
    s_axi_bready,
    s_axi_aresetn,
    s_axi_awvalid,
    s_axi_wvalid,
    Q,
    s_axi_wdata,
    ip2bus_rdack_i_D1,
    ip2bus_wrack_i_D1,
    s_axi_araddr,
    s_axi_awaddr);
  output bus2ip_reset;
  output \GEN_BKEND_CE_REGISTERS[3].ce_out_i_reg ;
  output \GEN_BKEND_CE_REGISTERS[2].ce_out_i_reg ;
  output \GEN_BKEND_CE_REGISTERS[1].ce_out_i_reg ;
  output \GEN_BKEND_CE_REGISTERS[0].ce_out_i_reg ;
  output bus2ip_rnw;
  output Bus_RNW_reg;
  output s_axi_rvalid_i_reg;
  output s_axi_bvalid_i_reg;
  output bus2ip_cs;
  output [0:0]E;
  output ip2bus_rdack_i_D1_reg;
  output ip2bus_wrack_i_D1_reg;
  output [4:0]s_axi_rdata;
  output [3:0]D;
  input s_axi_aclk;
  input s_axi_arvalid;
  input s_axi_rready;
  input s_axi_bready;
  input s_axi_aresetn;
  input s_axi_awvalid;
  input s_axi_wvalid;
  input [4:0]Q;
  input [7:0]s_axi_wdata;
  input ip2bus_rdack_i_D1;
  input ip2bus_wrack_i_D1;
  input [2:0]s_axi_araddr;
  input [2:0]s_axi_awaddr;

  wire Bus_RNW_reg;
  wire [3:0]D;
  wire [0:0]E;
  wire \GEN_BKEND_CE_REGISTERS[0].ce_out_i_reg ;
  wire \GEN_BKEND_CE_REGISTERS[1].ce_out_i_reg ;
  wire \GEN_BKEND_CE_REGISTERS[2].ce_out_i_reg ;
  wire \GEN_BKEND_CE_REGISTERS[3].ce_out_i_reg ;
  wire [4:0]Q;
  wire bus2ip_cs;
  wire bus2ip_reset;
  wire bus2ip_rnw;
  wire ip2bus_rdack_i_D1;
  wire ip2bus_rdack_i_D1_reg;
  wire ip2bus_wrack_i_D1;
  wire ip2bus_wrack_i_D1_reg;
  wire s_axi_aclk;
  wire [2:0]s_axi_araddr;
  wire s_axi_aresetn;
  wire s_axi_arvalid;
  wire [2:0]s_axi_awaddr;
  wire s_axi_awvalid;
  wire s_axi_bready;
  wire s_axi_bvalid_i_reg;
  wire [4:0]s_axi_rdata;
  wire s_axi_rready;
  wire s_axi_rvalid_i_reg;
  wire [7:0]s_axi_wdata;
  wire s_axi_wvalid;

  decalper_eb_ot_sdeen_pot_pi_dehcac_xnilix_slave_attachment I_SLAVE_ATTACHMENT
       (.Bus_RNW_reg(Bus_RNW_reg),
        .D(D),
        .E(E),
        .\GEN_BKEND_CE_REGISTERS[0].ce_out_i_reg (\GEN_BKEND_CE_REGISTERS[0].ce_out_i_reg ),
        .\GEN_BKEND_CE_REGISTERS[1].ce_out_i_reg (\GEN_BKEND_CE_REGISTERS[1].ce_out_i_reg ),
        .\GEN_BKEND_CE_REGISTERS[2].ce_out_i_reg (\GEN_BKEND_CE_REGISTERS[2].ce_out_i_reg ),
        .\GEN_BKEND_CE_REGISTERS[3].ce_out_i_reg (\GEN_BKEND_CE_REGISTERS[3].ce_out_i_reg ),
        .\MEM_DECODE_GEN[0].cs_out_i_reg[0] (bus2ip_cs),
        .Q(Q),
        .SR(bus2ip_reset),
        .bus2ip_rnw(bus2ip_rnw),
        .ip2bus_rdack_i_D1(ip2bus_rdack_i_D1),
        .ip2bus_rdack_i_D1_reg(ip2bus_rdack_i_D1_reg),
        .ip2bus_wrack_i_D1(ip2bus_wrack_i_D1),
        .ip2bus_wrack_i_D1_reg(ip2bus_wrack_i_D1_reg),
        .s_axi_aclk(s_axi_aclk),
        .s_axi_araddr(s_axi_araddr),
        .s_axi_aresetn(s_axi_aresetn),
        .s_axi_arvalid(s_axi_arvalid),
        .s_axi_awaddr(s_axi_awaddr),
        .s_axi_awvalid(s_axi_awvalid),
        .s_axi_bready(s_axi_bready),
        .s_axi_bvalid_i_reg_0(s_axi_bvalid_i_reg),
        .s_axi_rdata(s_axi_rdata),
        .s_axi_rready(s_axi_rready),
        .s_axi_rvalid_i_reg_0(s_axi_rvalid_i_reg),
        .s_axi_wdata(s_axi_wdata),
        .s_axi_wvalid(s_axi_wvalid));
endmodule

module decalper_eb_ot_sdeen_pot_pi_dehcac_xnilix_pselect_f
   (ce_expnd_i_3,
    \GEN_BKEND_CE_REGISTERS[0].ce_out_i_reg[0] );
  output ce_expnd_i_3;
  input [1:0]\GEN_BKEND_CE_REGISTERS[0].ce_out_i_reg[0] ;

  wire [1:0]\GEN_BKEND_CE_REGISTERS[0].ce_out_i_reg[0] ;
  wire ce_expnd_i_3;

  LUT2 #(
    .INIT(4'h1)) 
    CS
       (.I0(\GEN_BKEND_CE_REGISTERS[0].ce_out_i_reg[0] [0]),
        .I1(\GEN_BKEND_CE_REGISTERS[0].ce_out_i_reg[0] [1]),
        .O(ce_expnd_i_3));
endmodule

(* ORIG_REF_NAME = "pselect_f" *) 
module decalper_eb_ot_sdeen_pot_pi_dehcac_xnilix_pselect_f__parameterized1
   (ce_expnd_i_1,
    \GEN_BKEND_CE_REGISTERS[2].ce_out_i_reg[2] );
  output ce_expnd_i_1;
  input [1:0]\GEN_BKEND_CE_REGISTERS[2].ce_out_i_reg[2] ;

  wire [1:0]\GEN_BKEND_CE_REGISTERS[2].ce_out_i_reg[2] ;
  wire ce_expnd_i_1;

  LUT2 #(
    .INIT(4'h2)) 
    CS
       (.I0(\GEN_BKEND_CE_REGISTERS[2].ce_out_i_reg[2] [1]),
        .I1(\GEN_BKEND_CE_REGISTERS[2].ce_out_i_reg[2] [0]),
        .O(ce_expnd_i_1));
endmodule
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
