JPirman/FPGA_polarimeter/Polarimeter_core/Vivado/Polarimeter_Microblaze.cache/ip/2022.1/0/b/0bd465e0ead2b182/Main_axi_gpio_0_1_sim_netlist.vhdl

-- Copyright 1986-2022 Xilinx, Inc. All Rights Reserved.
-- --------------------------------------------------------------------------------
-- Tool Version: Vivado v.2022.1 (lin64) Build 3526262 Mon Apr 18 15:47:01 MDT 2022
-- Date        : Sat May 21 14:37:01 2022
-- Host        : Jure-Linux running 64-bit Linux Mint 20.3
-- Command     : write_vhdl -force -mode funcsim -rename_top decalper_eb_ot_sdeen_pot_pi_dehcac_xnilix -prefix
--               decalper_eb_ot_sdeen_pot_pi_dehcac_xnilix_ Main_axi_gpio_0_1_sim_netlist.vhdl
-- Design      : Main_axi_gpio_0_1
-- Purpose     : This VHDL netlist is a functional simulation representation of the design and should not be modified or
--               synthesized. This netlist cannot be used for SDF annotated simulation.
-- Device      : xc7s25csga324-1
-- --------------------------------------------------------------------------------
library IEEE;
use IEEE.STD_LOGIC_1164.ALL;
library UNISIM;
use UNISIM.VCOMPONENTS.ALL;
entity decalper_eb_ot_sdeen_pot_pi_dehcac_xnilix_GPIO_Core is
  port (
    gpio_io_o : out STD_LOGIC_VECTOR ( 3 downto 0 );
    ip2bus_wrack_i : out STD_LOGIC;
    ip2bus_rdack_i : out STD_LOGIC;
    \GEN_BKEND_CE_REGISTERS[0].ce_out_i_reg[0]\ : out STD_LOGIC_VECTOR ( 4 downto 0 );
    s_axi_aclk : in STD_LOGIC;
    SR : in STD_LOGIC_VECTOR ( 0 to 0 );
    bus2ip_cs : in STD_LOGIC;
    bus2ip_rnw : in STD_LOGIC;
    E : in STD_LOGIC_VECTOR ( 0 to 0 );
    D : in STD_LOGIC_VECTOR ( 3 downto 0 );
    \GEN_BKEND_CE_REGISTERS[2].ce_out_i_reg\ : in STD_LOGIC;
    \GEN_BKEND_CE_REGISTERS[0].ce_out_i_reg\ : in STD_LOGIC;
    \GEN_BKEND_CE_REGISTERS[1].ce_out_i_reg\ : in STD_LOGIC;
    Bus_RNW_reg : in STD_LOGIC;
    \GEN_BKEND_CE_REGISTERS[3].ce_out_i_reg\ : in STD_LOGIC
  );
end decalper_eb_ot_sdeen_pot_pi_dehcac_xnilix_GPIO_Core;

architecture STRUCTURE of decalper_eb_ot_sdeen_pot_pi_dehcac_xnilix_GPIO_Core is
  signal GPIO_xferAck_i : STD_LOGIC;
  signal \Read_Reg_Rst__0\ : STD_LOGIC;
  signal \^gpio_io_o\ : STD_LOGIC_VECTOR ( 3 downto 0 );
  signal gpio_xferAck_Reg : STD_LOGIC;
  signal \iGPIO_xferAck__0\ : STD_LOGIC;
  signal reg1 : STD_LOGIC_VECTOR ( 28 to 31 );
  attribute SOFT_HLUTNM : string;
  attribute SOFT_HLUTNM of iGPIO_xferAck : label is "soft_lutpair6";
  attribute SOFT_HLUTNM of ip2bus_wrack_i_D1_i_1 : label is "soft_lutpair6";
begin
  gpio_io_o(3 downto 0) <= \^gpio_io_o\(3 downto 0);
\Not_Dual.ALLOUT_ND.READ_REG_GEN[0].reg1_reg[28]\: unisim.vcomponents.FDRE
     port map (
      C => s_axi_aclk,
      CE => '1',
      D => \^gpio_io_o\(3),
      Q => reg1(28),
      R => \Read_Reg_Rst__0\
    );
\Not_Dual.ALLOUT_ND.READ_REG_GEN[1].reg1_reg[29]\: unisim.vcomponents.FDRE
     port map (
      C => s_axi_aclk,
      CE => '1',
      D => \^gpio_io_o\(2),
      Q => reg1(29),
      R => \Read_Reg_Rst__0\
    );
\Not_Dual.ALLOUT_ND.READ_REG_GEN[2].reg1_reg[30]\: unisim.vcomponents.FDRE
     port map (
      C => s_axi_aclk,
      CE => '1',
      D => \^gpio_io_o\(1),
      Q => reg1(30),
      R => \Read_Reg_Rst__0\
    );
\Not_Dual.ALLOUT_ND.READ_REG_GEN[3].reg1_reg[31]\: unisim.vcomponents.FDRE
     port map (
      C => s_axi_aclk,
      CE => '1',
      D => \^gpio_io_o\(0),
      Q => reg1(31),
      R => \Read_Reg_Rst__0\
    );
\Not_Dual.gpio_Data_Out_reg[0]\: unisim.vcomponents.FDRE
    generic map(
      INIT => '0'
    )
        port map (
      C => s_axi_aclk,
      CE => E(0),
      D => D(3),
      Q => \^gpio_io_o\(3),
      R => SR(0)
    );
\Not_Dual.gpio_Data_Out_reg[1]\: unisim.vcomponents.FDRE
    generic map(
      INIT => '0'
    )
        port map (
      C => s_axi_aclk,
      CE => E(0),
      D => D(2),
      Q => \^gpio_io_o\(2),
      R => SR(0)
    );
\Not_Dual.gpio_Data_Out_reg[2]\: unisim.vcomponents.FDRE
    generic map(
      INIT => '0'
    )
        port map (
      C => s_axi_aclk,
      CE => E(0),
      D => D(1),
      Q => \^gpio_io_o\(1),
      R => SR(0)
    );
\Not_Dual.gpio_Data_Out_reg[3]\: unisim.vcomponents.FDRE
    generic map(
      INIT => '0'
    )
        port map (
      C => s_axi_aclk,
      CE => E(0),
      D => D(0),
      Q => \^gpio_io_o\(0),
      R => SR(0)
    );
Read_Reg_Rst: unisim.vcomponents.LUT4
    generic map(
      INIT => X"FFDF"
    )
        port map (
      I0 => bus2ip_rnw,
      I1 => GPIO_xferAck_i,
      I2 => bus2ip_cs,
      I3 => gpio_xferAck_Reg,
      O => \Read_Reg_Rst__0\
    );
gpio_xferAck_Reg_reg: unisim.vcomponents.FDRE
     port map (
      C => s_axi_aclk,
      CE => '1',
      D => GPIO_xferAck_i,
      Q => gpio_xferAck_Reg,
      R => SR(0)
    );
iGPIO_xferAck: unisim.vcomponents.LUT3
    generic map(
      INIT => X"02"
    )
        port map (
      I0 => bus2ip_cs,
      I1 => gpio_xferAck_Reg,
      I2 => GPIO_xferAck_i,
      O => \iGPIO_xferAck__0\
    );
iGPIO_xferAck_reg: unisim.vcomponents.FDRE
     port map (
      C => s_axi_aclk,
      CE => '1',
      D => \iGPIO_xferAck__0\,
      Q => GPIO_xferAck_i,
      R => SR(0)
    );
\ip2bus_data_i_D1[0]_i_1\: unisim.vcomponents.LUT5
    generic map(
      INIT => X"00001400"
    )
        port map (
      I0 => \GEN_BKEND_CE_REGISTERS[0].ce_out_i_reg\,
      I1 => \GEN_BKEND_CE_REGISTERS[3].ce_out_i_reg\,
      I2 => \GEN_BKEND_CE_REGISTERS[1].ce_out_i_reg\,
      I3 => Bus_RNW_reg,
      I4 => \GEN_BKEND_CE_REGISTERS[2].ce_out_i_reg\,
      O => \GEN_BKEND_CE_REGISTERS[0].ce_out_i_reg[0]\(4)
    );
\ip2bus_data_i_D1[28]_i_1\: unisim.vcomponents.LUT6
    generic map(
      INIT => X"0011000011400000"
    )
        port map (
      I0 => \GEN_BKEND_CE_REGISTERS[2].ce_out_i_reg\,
      I1 => \GEN_BKEND_CE_REGISTERS[0].ce_out_i_reg\,
      I2 => reg1(28),
      I3 => \GEN_BKEND_CE_REGISTERS[1].ce_out_i_reg\,
      I4 => Bus_RNW_reg,
      I5 => \GEN_BKEND_CE_REGISTERS[3].ce_out_i_reg\,
      O => \GEN_BKEND_CE_REGISTERS[0].ce_out_i_reg[0]\(3)
    );
\ip2bus_data_i_D1[29]_i_1\: unisim.vcomponents.LUT6
    generic map(
      INIT => X"0011000011400000"
    )
        port map (
      I0 => \GEN_BKEND_CE_REGISTERS[2].ce_out_i_reg\,
      I1 => \GEN_BKEND_CE_REGISTERS[0].ce_out_i_reg\,
      I2 => reg1(29),
      I3 => \GEN_BKEND_CE_REGISTERS[1].ce_out_i_reg\,
      I4 => Bus_RNW_reg,
      I5 => \GEN_BKEND_CE_REGISTERS[3].ce_out_i_reg\,
      O => \GEN_BKEND_CE_REGISTERS[0].ce_out_i_reg[0]\(2)
    );
\ip2bus_data_i_D1[30]_i_1\: unisim.vcomponents.LUT6
    generic map(
      INIT => X"0011000011400000"
    )
        port map (
      I0 => \GEN_BKEND_CE_REGISTERS[2].ce_out_i_reg\,
      I1 => \GEN_BKEND_CE_REGISTERS[0].ce_out_i_reg\,
      I2 => reg1(30),
      I3 => \GEN_BKEND_CE_REGISTERS[1].ce_out_i_reg\,
      I4 => Bus_RNW_reg,
      I5 => \GEN_BKEND_CE_REGISTERS[3].ce_out_i_reg\,
      O => \GEN_BKEND_CE_REGISTERS[0].ce_out_i_reg[0]\(1)
    );
\ip2bus_data_i_D1[31]_i_1\: unisim.vcomponents.LUT6
    generic map(
      INIT => X"0011000011400000"
    )
        port map (
      I0 => \GEN_BKEND_CE_REGISTERS[2].ce_out_i_reg\,
      I1 => \GEN_BKEND_CE_REGISTERS[0].ce_out_i_reg\,
      I2 => reg1(31),
      I3 => \GEN_BKEND_CE_REGISTERS[1].ce_out_i_reg\,
      I4 => Bus_RNW_reg,
      I5 => \GEN_BKEND_CE_REGISTERS[3].ce_out_i_reg\,
      O => \GEN_BKEND_CE_REGISTERS[0].ce_out_i_reg[0]\(0)
    );
ip2bus_rdack_i_D1_i_1: unisim.vcomponents.LUT2
    generic map(
      INIT => X"8"
    )
        port map (
      I0 => GPIO_xferAck_i,
      I1 => bus2ip_rnw,
      O => ip2bus_rdack_i
    );
ip2bus_wrack_i_D1_i_1: unisim.vcomponents.LUT2
    generic map(
      INIT => X"2"
    )
        port map (
      I0 => GPIO_xferAck_i,
      I1 => bus2ip_rnw,
      O => ip2bus_wrack_i
    );
end STRUCTURE;
library IEEE;
use IEEE.STD_LOGIC_1164.ALL;
library UNISIM;
use UNISIM.VCOMPONENTS.ALL;
entity decalper_eb_ot_sdeen_pot_pi_dehcac_xnilix_pselect_f is
  port (
    ce_expnd_i_3 : out STD_LOGIC;
    \GEN_BKEND_CE_REGISTERS[0].ce_out_i_reg[0]\ : in STD_LOGIC_VECTOR ( 1 downto 0 )
  );
end decalper_eb_ot_sdeen_pot_pi_dehcac_xnilix_pselect_f;

architecture STRUCTURE of decalper_eb_ot_sdeen_pot_pi_dehcac_xnilix_pselect_f is
begin
CS: unisim.vcomponents.LUT2
    generic map(
      INIT => X"1"
    )
        port map (
      I0 => \GEN_BKEND_CE_REGISTERS[0].ce_out_i_reg[0]\(0),
      I1 => \GEN_BKEND_CE_REGISTERS[0].ce_out_i_reg[0]\(1),
      O => ce_expnd_i_3
    );
end STRUCTURE;
library IEEE;
use IEEE.STD_LOGIC_1164.ALL;
library UNISIM;
use UNISIM.VCOMPONENTS.ALL;
entity \decalper_eb_ot_sdeen_pot_pi_dehcac_xnilix_pselect_f__parameterized1\ is
  port (
    ce_expnd_i_1 : out STD_LOGIC;
    \GEN_BKEND_CE_REGISTERS[2].ce_out_i_reg[2]\ : in STD_LOGIC_VECTOR ( 1 downto 0 )
  );
  attribute ORIG_REF_NAME : string;
  attribute ORIG_REF_NAME of \decalper_eb_ot_sdeen_pot_pi_dehcac_xnilix_pselect_f__parameterized1\ : entity is "pselect_f";
end \decalper_eb_ot_sdeen_pot_pi_dehcac_xnilix_pselect_f__parameterized1\;

architecture STRUCTURE of \decalper_eb_ot_sdeen_pot_pi_dehcac_xnilix_pselect_f__parameterized1\ is
begin
CS: unisim.vcomponents.LUT2
    generic map(
      INIT => X"2"
    )
        port map (
      I0 => \GEN_BKEND_CE_REGISTERS[2].ce_out_i_reg[2]\(1),
      I1 => \GEN_BKEND_CE_REGISTERS[2].ce_out_i_reg[2]\(0),
      O => ce_expnd_i_1
    );
end STRUCTURE;
library IEEE;
use IEEE.STD_LOGIC_1164.ALL;
library UNISIM;
use UNISIM.VCOMPONENTS.ALL;
entity decalper_eb_ot_sdeen_pot_pi_dehcac_xnilix_address_decoder is
  port (
    \GEN_BKEND_CE_REGISTERS[3].ce_out_i_reg\ : out STD_LOGIC;
    \GEN_BKEND_CE_REGISTERS[2].ce_out_i_reg\ : out STD_LOGIC;
    \GEN_BKEND_CE_REGISTERS[1].ce_out_i_reg\ : out STD_LOGIC;
    \GEN_BKEND_CE_REGISTERS[0].ce_out_i_reg\ : out STD_LOGIC;
    Bus_RNW_reg : out STD_LOGIC;
    \MEM_DECODE_GEN[0].cs_out_i_reg[0]_0\ : out STD_LOGIC;
    E : out STD_LOGIC_VECTOR ( 0 to 0 );
    ip2bus_rdack_i_D1_reg : out STD_LOGIC;
    ip2bus_wrack_i_D1_reg : out STD_LOGIC;
    D : out STD_LOGIC_VECTOR ( 3 downto 0 );
    Q : in STD_LOGIC;
    s_axi_aclk : in STD_LOGIC;
    \Not_Dual.gpio_Data_Out_reg[0]\ : in STD_LOGIC_VECTOR ( 2 downto 0 );
    bus2ip_rnw : in STD_LOGIC;
    s_axi_aresetn : in STD_LOGIC;
    ip2bus_rdack_i_D1 : in STD_LOGIC;
    s_axi_arready : in STD_LOGIC;
    s_axi_arready_0 : in STD_LOGIC_VECTOR ( 3 downto 0 );
    ip2bus_wrack_i_D1 : in STD_LOGIC;
    s_axi_awready : in STD_LOGIC;
    s_axi_wdata : in STD_LOGIC_VECTOR ( 7 downto 0 )
  );
end decalper_eb_ot_sdeen_pot_pi_dehcac_xnilix_address_decoder;
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
