JPirman/FPGA_polarimeter/Polarimeter_core/Vivado/Polarimeter_Microblaze.cache/ip/2022.1/1/7/1767e5a04eac2334/Main_DSP_controller_0_1_sim_netlist.v

// Copyright 1986-2022 Xilinx, Inc. All Rights Reserved.
// --------------------------------------------------------------------------------
// Tool Version: Vivado v.2022.1 (lin64) Build 3526262 Mon Apr 18 15:47:01 MDT 2022
// Date        : Mon May 23 20:21:01 2022
// Host        : Jure-Linux running 64-bit Linux Mint 20.3
// Command     : write_verilog -force -mode funcsim -rename_top decalper_eb_ot_sdeen_pot_pi_dehcac_xnilix -prefix
//               decalper_eb_ot_sdeen_pot_pi_dehcac_xnilix_ Main_DSP_controller_0_1_sim_netlist.v
// Design      : Main_DSP_controller_0_1
// Purpose     : This verilog netlist is a functional simulation representation of the design and should not be modified
//               or synthesized. This netlist cannot be used for SDF annotated simulation.
// Device      : xc7s25csga324-1
// --------------------------------------------------------------------------------
`timescale 1 ps / 1 ps

module decalper_eb_ot_sdeen_pot_pi_dehcac_xnilix_DSP_controller
   (axil_read_valid_reg_0,
    S_AXI_RDATA,
    \SIMPLE_WRITES.axil_awready_reg_0 ,
    S_AXI_ARREADY,
    S_AXI_BVALID,
    S_AXI_RREADY,
    S_AXI_WDATA,
    S_AXI_ACLK,
    S_AXI_ARADDR,
    S_AXI_WSTRB,
    S_AXI_AWADDR,
    S_AXI_ARVALID,
    S_AXI_ARESETN,
    S_AXI_BREADY,
    S_AXI_AWVALID,
    S_AXI_WVALID);
  output axil_read_valid_reg_0;
  output [31:0]S_AXI_RDATA;
  output \SIMPLE_WRITES.axil_awready_reg_0 ;
  output S_AXI_ARREADY;
  output S_AXI_BVALID;
  input S_AXI_RREADY;
  input [31:0]S_AXI_WDATA;
  input S_AXI_ACLK;
  input [1:0]S_AXI_ARADDR;
  input [3:0]S_AXI_WSTRB;
  input [1:0]S_AXI_AWADDR;
  input S_AXI_ARVALID;
  input S_AXI_ARESETN;
  input S_AXI_BREADY;
  input S_AXI_AWVALID;
  input S_AXI_WVALID;

  wire \SIMPLE_WRITES.axil_awready_i_1_n_0 ;
  wire \SIMPLE_WRITES.axil_awready_reg_0 ;
  wire S_AXI_ACLK;
  wire [1:0]S_AXI_ARADDR;
  wire S_AXI_ARESETN;
  wire S_AXI_ARREADY;
  wire S_AXI_ARVALID;
  wire [1:0]S_AXI_AWADDR;
  wire S_AXI_AWVALID;
  wire S_AXI_BREADY;
  wire S_AXI_BVALID;
  wire [31:0]S_AXI_RDATA;
  wire S_AXI_RREADY;
  wire [31:0]S_AXI_WDATA;
  wire [3:0]S_AXI_WSTRB;
  wire S_AXI_WVALID;
  wire axil_bvalid_i_1_n_0;
  wire \axil_read_data[0]_i_1_n_0 ;
  wire \axil_read_data[10]_i_1_n_0 ;
  wire \axil_read_data[11]_i_1_n_0 ;
  wire \axil_read_data[12]_i_1_n_0 ;
  wire \axil_read_data[13]_i_1_n_0 ;
  wire \axil_read_data[14]_i_1_n_0 ;
  wire \axil_read_data[15]_i_1_n_0 ;
  wire \axil_read_data[16]_i_1_n_0 ;
  wire \axil_read_data[17]_i_1_n_0 ;
  wire \axil_read_data[18]_i_1_n_0 ;
  wire \axil_read_data[19]_i_1_n_0 ;
  wire \axil_read_data[1]_i_1_n_0 ;
  wire \axil_read_data[20]_i_1_n_0 ;
  wire \axil_read_data[21]_i_1_n_0 ;
  wire \axil_read_data[22]_i_1_n_0 ;
  wire \axil_read_data[23]_i_1_n_0 ;
  wire \axil_read_data[24]_i_1_n_0 ;
  wire \axil_read_data[25]_i_1_n_0 ;
  wire \axil_read_data[26]_i_1_n_0 ;
  wire \axil_read_data[27]_i_1_n_0 ;
  wire \axil_read_data[28]_i_1_n_0 ;
  wire \axil_read_data[29]_i_1_n_0 ;
  wire \axil_read_data[2]_i_1_n_0 ;
  wire \axil_read_data[30]_i_1_n_0 ;
  wire \axil_read_data[31]_i_1_n_0 ;
  wire \axil_read_data[31]_i_2_n_0 ;
  wire \axil_read_data[3]_i_1_n_0 ;
  wire \axil_read_data[4]_i_1_n_0 ;
  wire \axil_read_data[5]_i_1_n_0 ;
  wire \axil_read_data[6]_i_1_n_0 ;
  wire \axil_read_data[7]_i_1_n_0 ;
  wire \axil_read_data[8]_i_1_n_0 ;
  wire \axil_read_data[9]_i_1_n_0 ;
  wire axil_read_valid_i_1_n_0;
  wire axil_read_valid_reg_0;
  wire p_0_in;
  wire [31:0]r0;
  wire \r0[15]_i_1_n_0 ;
  wire \r0[23]_i_1_n_0 ;
  wire \r0[31]_i_1_n_0 ;
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
