JPirman/FPGA_polarimeter/doc/Polarimeter_sensor.jpg

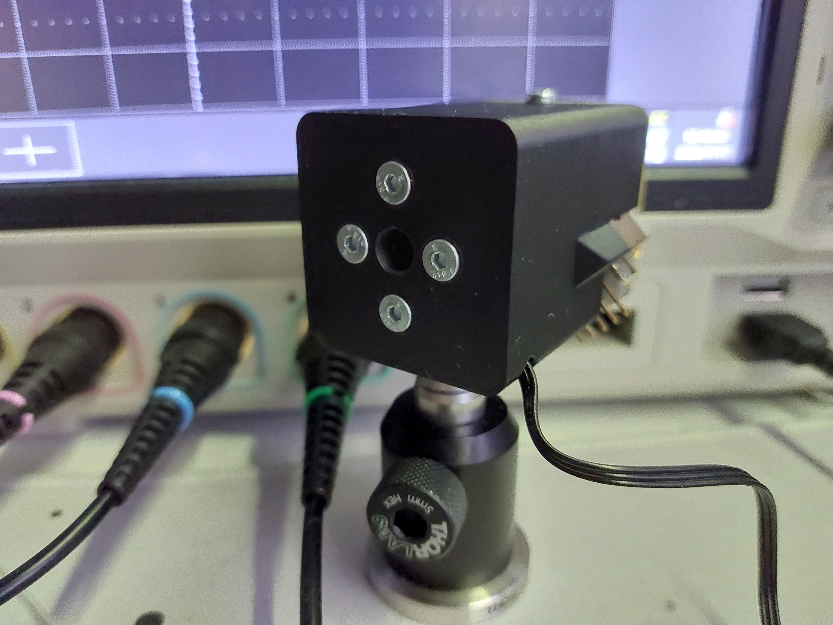
[picture p2: doc/Polarimeter_sensor.jpg]
doc/Polarimeter_sensor.jpg
